angel-obando-17/CNN-accelerator-on-SoC/socs.md

# COMPARACION DE SOCS

| Board | SoC | Familia | Nucleos | Cache | DMA Channels | On Chip Memory | RAM | BRAM  | Word Size BRAM | Logic Cells | DSP Slices | Precio (COP) | 
|---|---|---|---|---|---|---|---|---|---|---|---|---|
| Puzhi 7020  | Z-7020 | Zynq®-7000 | Dual-Core ARM - Cortex-A9 MPCore | 32KB I, 32KB D / 512 KB | 8 (4 to PL) | 256 KB | 512 MB | 4.9Mb | 1-bit hasta 72-bits | 85K | 220 | $480.174 |
| ZedBoard Zynq-7000 | Z-7020 | Zynq®-7000 | Dual-Core ARM - Cortex-A9 MPCore | 32KB I, 32KB D / 512 KB | 8 (4 to PL) | 256 KB | 512 MB | 4.9Mb | 1-bit hasta 72-bits | 85K | 220 | $2.186.821,53 |
| PYNQ-Z2 FPGA | Z-7020 | Zynq®-7000 | Dual-Core ARM - Cortex-A9 MPCore | 32KB I, 32KB D / 512 KB | 8 (4 to PL) | 256 KB | 512 MB | 4.9Mb | 1-bit hasta 72-bits | 85K | 220 | $490.947,33 |
| Zybo Z7 | Z-7020 | Zynq®-7000 | Dual-Core ARM - Cortex-A9 MPCore | 32KB I, 32KB D / 512 KB | 8 (4 to PL) | 256 KB | 1 GB | 4.9Mb | 1-bit hasta 72-bits | 85K | 220 | $2.420.796 |
| KRM-3Z7030 | Z-7030 | Zynq®-7000 | Dual-Core ARM - Cortex-A9 MPCore | 32KB I, 32KB D / 512 KB | 8 (4 to PL) | 256 KB | 1 GB | 9.3Mb | 1-bit hasta 72-bits | 125K | 400 | $1.948.744,00 |
| ZYNQ EVB Board | Z-7030 | Zynq®-7000 | Dual-Core ARM - Cortex-A9 MPCore | 32KB I, 32KB D / 512 KB | 8 (4 to PL) | 256 KB | 2GB | 9.3Mb | 1-bit hasta 72-bits | 125K | 400 | $2.895.960,60 |
| AXU2CGB Dev Board | ZU2CG | Zynq UltraScale+  | Dual-core Arm® Cortex®-A53 / Dual-core Arm Cortex-R5F | ( 32KB I, 32KB D / 1MB ) / ( 32KB I, 32KB D / 128 Tightly Coupled Memory per core ) | 8 (4 to PL) | 256 KB | 2GB | 5.3Mb | 1-bit hasta 72-bits | 103K | 240 | $1.596.491,10 |
