angel-obando-17/CNN-accelerator-on-SoC/CNN/docs/analisis.md

# ANALSIS DE RESULTADOS DE ENTRENAMIENTO

Para validar las restricciones impuestas en el acelerador, sobre la resolucion de imagenes y la cuantizacion a INT8, se desarrollo el modelo de CNN que tendra la tarea de indentificar enfermedades en una planta de tomate, para esto se empleo el database de PlantVillage alojado en Kaggle, link = "https://www.kaggle.com/datasets/emmarex/plantdisease/data".

## ESTRATEGIA DE VALIDACIÓN

Para hacer una analisis completo y detallado de que ocurre en distintos escenarios y asi ver que posibles resultados obtener se planteo el siguiente esquema:

* Realizar entrenamientos del modelo en $3$ resoluciones distintas, las cuales son [ $256$ $\times$ $256$, $128$ $\times$ $128$, $96$ $\times$ $96$ ].
* Para cada entrenamiento obtenido anteriormente se realizan las siguientes cuantizaciones [ "float32", "int16", "int8" ].
* En cada cuantizacion obtenida se usan como metricas el accuracy y confussion matrix.

## IMPLEMENTACION

Para poder realizar una correcta implementacion del modelo, primero se necesitaba balancear el database, ya que para cada una de las clases habia muestras muy disparejas, originalmente el database contaba con $10$ clases, las cuales eran:

* Tomato_Bacterial_Spot.
* Tomato_Early_Blight.
* Tomato_Late_Blight.
* Tomato_Leaf_Mold.
* Tomato_Septoria_Leaf_Spot.
* Tomato_Spider_Mites_Two_Spotted_Spider_Mite.
* Tomato__Target_Spot.
* Tomato__Tomato_YellowLeaf__Curl_Virus.
* Tomato__Tomato_Mosaic_Virus.
* Tomato_Healthy.

Se tomo la desicion de descartar la clase "Tomato__Tomato_Mosaic_Virus" debido a que tenia significativamente muchas menos muestras que las demas clases, y tomar esta clase como referencia para el balance provocaria una perdida enorme de informacion de las demas clases, obteniendo un entrenamiento muy pobre, por lo tanto se decidio eliminarlo definitivamente.

Despues de esto entonces se tomo como clase referencia la clase "Tomato_Leaf_Mold" la cual tenia un total de $952$ muestras, por lo que todas las demas clases debian ser recortadas hasta obtener este mismo numero de muestras, pero antes de hacer eso, se decicio con ayuda de un script en python tomar 48 muestras aleatorias de la clase "Tomato_Leaf_Mold" y aplicarle ciertas transforamciones muy poco invasivas, ya sean como hacer espejo, cambiar algunos tonos de luz o rotar un poco las imagenes, esto con el proposito de alcanzar $1000$ muestras para esta clase, de esta forma entonces, cada clase debia recortarse a $1000$ muestras.

Una vez que el dataset fue balanceado, entonces ahora si se procedio a realizar el script en python que realizaria las siguientes tareas:

* Segmentacion de las imagenes utilizando el metodo de "grabCut" de la libreria OpenCV disponible para python.
* Una vez con las imagenes segmentadas, entonces se procede a realizar el primer entrenamiento con las imagenes en su resolucion original, la cual es de $256$ $\times$ $256$. 
* Una vez que el modelo haya terminado de entrenarse, entonces se exportaron los pesos obtenidos en su formato original de "float32".
* Se procede a validar el modelo con su cunatizado original, se mide accuracy y se obtiene la confussion matrix.
* Se procede a cuantizar el modelo a "int8", se mide accuracy y se obtiene la confussion matrix.
* Se procede a cuantizar el modelo a "int16", se mide el accuracy y se obtiene la confussion matrix.
* Esto se repite para cada otra de las resoluciones, es decir para [ $128$ $\times$ $128$, $96$ $\times$ $96$ ].

En cuanto al modelo CNN implementado, como ya se menciono anteriormente, se utilizo el modelo de MobileNetV1, pero personalizado para que utilice las capas soportadas por el acelerador que se desea implementar, por lo que solo consiste en capas de convolucion normal $3$ $\times$ $3$, DepthWise $3$ $\times$ $3$, PointWise $1$ $\times$ $1$, MaxPool $2$ $\times$ $2$ y Global Average Pool, tambien se limitaron los strides a [ $1$, $2$ ].

Tambien se implemento un sistema que midiera el tiempo que se tardo en cada etapa del proceso, desde que se cargaron las imagenes, segmentado las imagenes, entrenando el modelo, realizando las pruebas de validacion y tambien calculando el tiempo que le tomo cuantizar los parametros del modelo.

## PRIMEROS RESULTADOS

### Primer entrenamiento

#### RESOLUCION 256

Para la primer etapa de entrenamiento donde se uso las imagenes con su resolucion original, es decir $256$ $\times$ $256$, los resultados obtenidos fueron los siguientes:

* Indexado de archivos:  $0.434$ s.
* Total de $9000$ imagenes | $9$ clases.
* [ Train $=$ $6300$,  Val $=$ $1350$,  Test $=$ $1350$ ].
* Entrenamiento: $8254.509$ s.
Accuracy vs Loss in Training
* Accuracy: $0.8319$.
* Confussion Matrix:
Confussion Matrix $256$ $\times$ $256$ (float32)

Despues de esto se cuantizo a INT8, donde se obtuvieron los siguientes resultados:

* Conversion de parametros a INT8: $48.953$ s.
* Tamaño del modelo en INT8: $120.8$ KB.
* Accuracy int8: $0.8259$.
* Confussion Matrix:
Confussion Matrix $256$ $\times$ $256$ (int8)

Para finalizar tenemos el modelo cuantizado en INT16, donde los resultados fueron los siguientes:

* Conversion de parametros a INT16: $95.270$ s.
* Tamaño del modelo en INT8: $141.9$ KB.
* Accuracy int16: $0.8274$.
* Confussion Matrix:
Confussion Matrix $256$ $\times$ $256$ (int16)

#### RESOLUCION 128

Para la segunda etapa de entrenamiento donde se uso las imagenes con un reescalado a $128$ $\times$ $128$, los resultados obtenidos fueron los siguientes:

* Entrenamiento: $8052.963$ s.
Accuracy vs Loss in Training
* Accuracy: $0.6763$.
* Tiempo de evaluacion: $75.031$ s.
* Confussion Matrix:
Confussion Matrix $128$ $\times$ $128$ (float32)

Despues de esto se cuantizo a INT8, donde se obtuvieron los siguientes resultados:

* Conversion de parametros a INT8: $42.980$ s.
* Tamaño del modelo en INT8: $120.8$ KB.
* Accuracy int8: $0.6800$.
* Confussion Matrix:
Confussion Matrix $128$ $\times$ $128$ (int8)

Para finalizar tenemos el modelo cuantizado en INT16, donde los resultados fueron los siguientes:

* Conversion de parametros a INT16: $82.207$ s.
* Tamaño del modelo en INT8: $141.9$ KB.
* Accuracy int16: $0.6763$.
* Confussion Matrix:
Confussion Matrix $128$ $\times$ $128$ (int16

#### RESOLUCION 96

Para la tercer etapa y ultima etapa de entrenamiento donde se uso las imagenes con un reescalado a $96$ $\times$ $96$, los resultados obtenidos fueron los siguientes:

* Entrenamiento: $8052.963$ s.
Accuracy vs Loss in Training
* Accuracy: $0.7259$.
* Tiempo de evaluacion: $72.404$ s.
* Confussion Matrix:
Confussion Matrix $96$ $\times$ $96$ (float32)

Despues de esto se cuantizo a INT8, donde se obtuvieron los siguientes resultados:

* Conversion de parametros a INT8: $41.845$ s.
* Tamaño del modelo en INT8: $120.7$ KB.
* Accuracy int8: $0.7230$.
* Confussion Matrix:
Confussion Matrix $96$ $\times$ $96$ (int8)

Para finalizar tenemos el modelo cuantizado en INT16, donde los resultados fueron los siguientes:

* Conversion de parametros a INT16: $81.680$ s.
* Tamaño del modelo en INT8: $141.8$ KB.
* Accuracy int16: $0.7267$.
* Confussion Matrix:
Confussion Matrix $96$ $\times$ $96$ (int16)

| Resolucion | Tiempo de Entrenamiento ( s ) | Cuantizacion | Accuracy | Inferencia ( ms / img ) | Tamaño del modelo ( kB ) | Tiempo de conversion ( s ) |
|---|---|---|---|---|---|---|
| $256$ $\times$ $256$ | $8254.509$ | float32 | $0.831852$ | $7.5678$ | $1112.441$ | No aplica |
| $256$ $\times$ $256$ | $8254.509$ | INT8 | $0.825926$ | $207.1756$ | $120.773$ | $48.9533$ |
| $256$ $\times$ $256$ | $8254.509$ | INT16 | $0.827407$ | $264.2121$ | $141.882$ | $95.2697$ |
| $128$ $\times$ $128$ | $8052.963$ | float32 | $0.676296$ | $3.3505$ | $1112.293$ | No aplica |
| $128$ $\times$ $128$ | $8052.963$ | INT8 | $0.680000$ | $214.8316$ | $120.773$ | $42.9797$ |
| $128$ $\times$ $128$ | $8052.963$ | INT16 | $0.676296$ | $218.2872$ | $141.882$ | $82.2065$ |
| $96$ $\times$ $96$ | $7811.027$ | float32 | $0.725926$ | $3.7295$ | $1112.286$ | No aplica |
| $96$ $\times$ $96$ | $7811.027$ | INT8 | $0.722963$ | $201.9591$ | $120.656$ | $41.8454$ |
| $96$ $\times$ $96$ | $7811.027$ | INT16 | $0.726667$ | $213.9610$ | $141.7656$ | $81.6804$ |

## CORRECIONES REALIZADAS

Despues de haber entrenado el modelo por primera vez, se observo que el mejor accuracy obtenido fue cuando se entreno el modelo con las dimensiones originales de las imagenes y cuantizando a float32, el accuracy que se obtuvo fue de $0.8318$, lo cual fue un buen punto de partida, a partir de aqui se tomaron desiciones respecto a como mejorar este accuracy obtenido, y buscar subirlo lo mayor posible.

Para el primer entrenamiento realizado, se escogio como modelo de segmentacion el metodo grabCut de openCV, este metodo aunque muy rapido, cometio muchos errores a la hora de segmentar algunas imagenes, ya que o les recortaba parte de la hoja, por lo tanto las dejaba incompletas o sino, les agreagaba sombra como si fueran parte de la hoja, haciendo que el modelo aprendiera patrones que no eran correctos debido a la forma en la cual estaban siendo segmentadas.

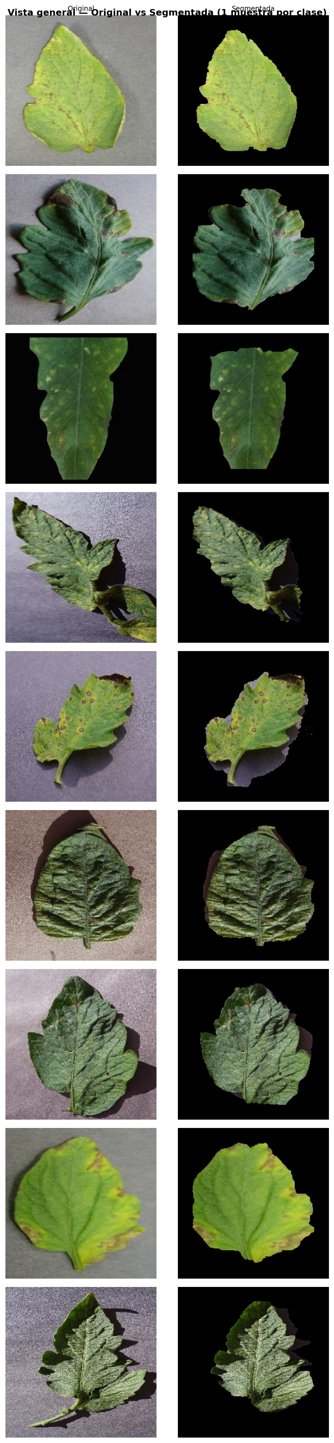
[picture p2: CNN/resultados_experimentos/imagenes_segmentadas/00_mosaic_overview.png]


Para poder resolver este problema se tomo la desicion de tomar una muestra aleatoria de cada clase, y realizar el proceso de segmentacion de manera manual, para esto se uso la herramienta open-source labelme, con la cual se realizaron las mascaras de una muestra por clase, por lo que se obtuvieron 9 mascaras.

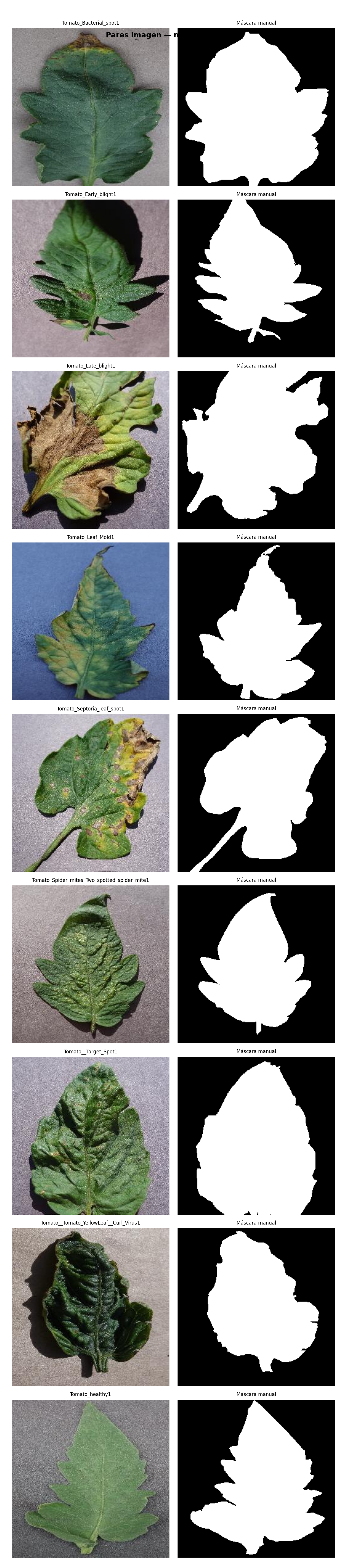
[picture p3: CNN/resultados_experimentos/segmentacion/mascaras_manuales.png]
Segmentacion realizada con grabCut


Con las 9 mascaras ya obtenidas se procedio a entrenar un modelo de CNN pequeño llamado U-Net el cual esta desarrollado para la segmentacion de imagenes. La red se basa en una red neuronal completamente convolucional cuya arquitectura se modificó y amplió para funcionar con menos imágenes de entrenamiento y lograr una segmentación más precisa.

El script utilizado para este paso fue el llamado "u_net_segmentation.py", despues de entrenarla con las 9 mascaras obtenidas de forma manual, se utilizo para segmentar todas las imagenes del dataset, por lo que se obtuvieron 9000 imagenes segmentadas de manera mas precisa que usando el metodo de grabCut, a continuacion se muestran unas muestras de esta segmentacion realizada por la red neuronal.

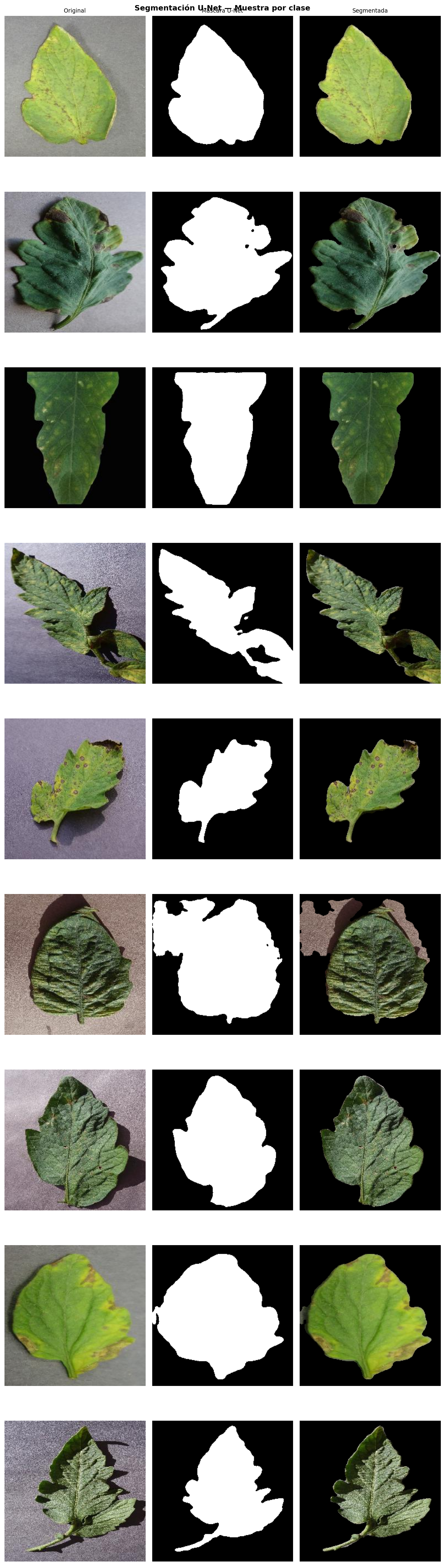
[picture p4: CNN/resultados_experimentos/segmentacion/segmentacion_muestras.png]
Segmentacion realizada con grabCut


Como se puede ver, los resultados que se obtienen son mucho mejores que los que nos devuelve el metodo de grabCut, ahora con este nuevo dataset de imagenes mejor segmentadas, se procedio a realizar un nuevo entrenamiento de la CNN, repitiendo los mismos pasos que en el primer entrenamiento, pero usando este nuevo dataset, los resultados que se obtuvieron fueron los siguientes:

### Segundo Entrenamiento

#### RESOLUCION 256

Para la primer etapa de este segundo entrenamiento, se siguio el mismo esquema que para el primer entrenamiento, donde la primer fase del entrenamiento fue con las imagenes en su resolucion original de $256$ $\times$ $256$, donde se obtuvieron los siguientes resultados:

* Indexado de archivos:  $0.124$ s.
* Total de $9000$ imagenes | $9$ clases.
* [ Train $=$ $6300$,  Val $=$ $1350$,  Test $=$ $1350$ ].
* Entrenamiento: $869.452$ s.
Accuracy vs Loss in Training
* Accuracy: $0.8859$.
* Confussion Matrix:
Confussion Matrix $256$ $\times$ $256$ (float32)

Despues de esto se cuantizo a INT8, donde se obtuvieron los siguientes resultados:

* Conversion de parametros a INT8: $35.354$ s.
* Tamaño del modelo en INT8: $120.8$ KB.
* Accuracy int8: $0.8837$.
* Confussion Matrix:
Confussion Matrix $256$ $\times$ $256$ (int8)

Para finalizar tenemos el modelo cuantizado en INT16, donde los resultados fueron los siguientes:

* Conversion de parametros a INT16: $67.825$ s.
* Tamaño del modelo en INT8: $141.9$ KB.
* Accuracy int16: $0.8867$.
* Confussion Matrix:
Confussion Matrix $256$ $\times$ $256$ (int16)

#### RESOLUCION 128

Para la segunda etapa de entrenamiento donde se uso las imagenes con un reescalado a $128$ $\times$ $128$, los resultados obtenidos fueron los siguientes:

* Entrenamiento: $531.974$ s.
Accuracy vs Loss in Training
* Accuracy: $0.7030$.
* Tiempo de evaluacion: $26.070$ s.
* Confussion Matrix:
Confussion Matrix $128$ $\times$ $128$ (float32)

Despues de esto se cuantizo a INT8, donde se obtuvieron los siguientes resultados:

* Conversion de parametros a INT8: $31.813$ s.
* Tamaño del modelo en INT8: $120.8$ KB.
* Accuracy int8: $0.7104$.
* Confussion Matrix:
Confussion Matrix $128$ $\times$ $128$ (int8)

Para finalizar tenemos el modelo cuantizado en INT16, donde los resultados fueron los siguientes:

* Conversion de parametros a INT16: $58.952$ s.
* Tamaño del modelo en INT8: $141.9$ KB.
* Accuracy int16: $0.7015$.
* Confussion Matrix:
Confussion Matrix $128$ $\times$ $128$ (int16

#### RESOLUCION 96

Para la tercer etapa y ultima etapa de entrenamiento donde se uso las imagenes con un reescalado a $96$ $\times$ $96$, los resultados obtenidos fueron los siguientes:

* Entrenamiento: $534.569$ s.
Accuracy vs Loss in Training
* Accuracy: $0.7622$.
* Tiempo de evaluacion: $26.955$ s.
* Confussion Matrix:
Confussion Matrix $96$ $\times$ $96$ (float32)

Despues de esto se cuantizo a INT8, donde se obtuvieron los siguientes resultados:

* Conversion de parametros a INT8: $30.056$ s.
* Tamaño del modelo en INT8: $120.7$ KB.
* Accuracy int8: $0.7689$.
* Confussion Matrix:
Confussion Matrix $96$ $\times$ $96$ (int8)

Para finalizar tenemos el modelo cuantizado en INT16, donde los resultados fueron los siguientes:

* Conversion de parametros a INT16: $59.788$ s.
* Tamaño del modelo en INT8: $141.8$ KB.
* Accuracy int16: $0.7667$.
* Confussion Matrix:
Confussion Matrix $96$ $\times$ $96$ (int16)

| Resolucion | Tiempo de Entrenamiento ( s ) | Cuantizacion | Accuracy | Inferencia ( ms / img ) | Tamaño del modelo ( kB ) | Tiempo de conversion ( s ) |
|---|---|---|---|---|---|---|
| $256$ $\times$ $256$ | $869.451$ | float32 | $0.885926$ | $8.6652$ | $1112.440$ | No aplica |
| $256$ $\times$ $256$ | $869.451$ | INT8 | $0.883704$ | $11.2185$ | $120.773$ | $35.3539$ |
| $256$ $\times$ $256$ | $869.451$ | INT16 | $0.886667$ | $68.8505$ | $141.882$ | $67.8251$ |
| $128$ $\times$ $128$ | $531.974$ | float32 | $0.702963$ | $2.8907$ | $1112.294$ | No aplica |
| $128$ $\times$ $128$ | $531.974$ | INT8 | $0.710370$ | $6.7732$ | $120.773$ | $31.8126$ |
| $128$ $\times$ $128$ | $531.974$ | INT16 | $0.701481$ | $23.7306$ | $141.882$ | $58.9521$ |
| $96$ $\times$ $96$ | $534.568$ | float32 | $0.762222$ | $3.9877$ | $1112.286$ | No aplica |
| $96$ $\times$ $96$ | $534.568$ | INT8 | $0.768889$ | $6.8182$ | $120.656$ | $30.0562$ |
| $96$ $\times$ $96$ | $534.568$ | INT16 | $0.766667$ | $16.0752$ | $141.765$ | $59.7883$ |

## COMPARACIONES CON OTROS MODELOS

Despues de realizar el segundo entrenamiento, se procedio a reliazar entrenamientos de tres modelos mas, Le-Net, Efficient-Net y MObileNetV2, los entrenamientos se realizaron con el mismo dataset de las imagenes ya segmentadas por U-Net, para este caso, unicamente se realizaron los entrenamientos en la resolucion original de las imagenes, la cual es de $256$ $\times$ $256$, despues se realizaron las respectivas cuantizaciones a INT8 e INT16 y se validaron las muestras de test, los resultados obtenidos de estos entrenamientos fueron los siguientes:

### Le-Net

* Total de $9000$ imagenes | $9$ clases.
* [ Train $=$ $6300$,  Val $=$ $1350$,  Test $=$ $1350$ ].
* Entrenamiento: $882.987$ s.
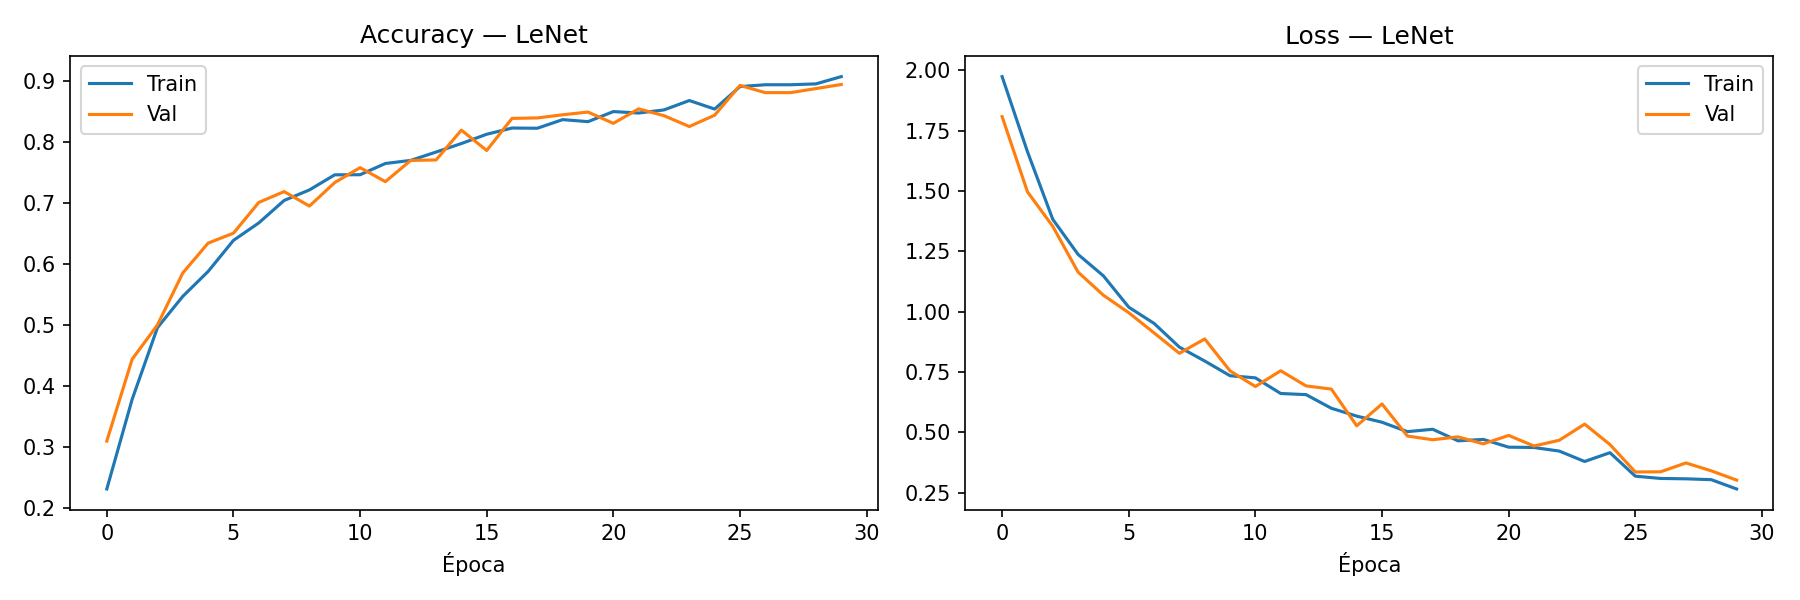
[picture p5: CNN/resultados_comparativa/training_LeNet.png]
Accuracy vs Loss in Training

* Accuracy: $0.8696$.
* Confussion Matrix:
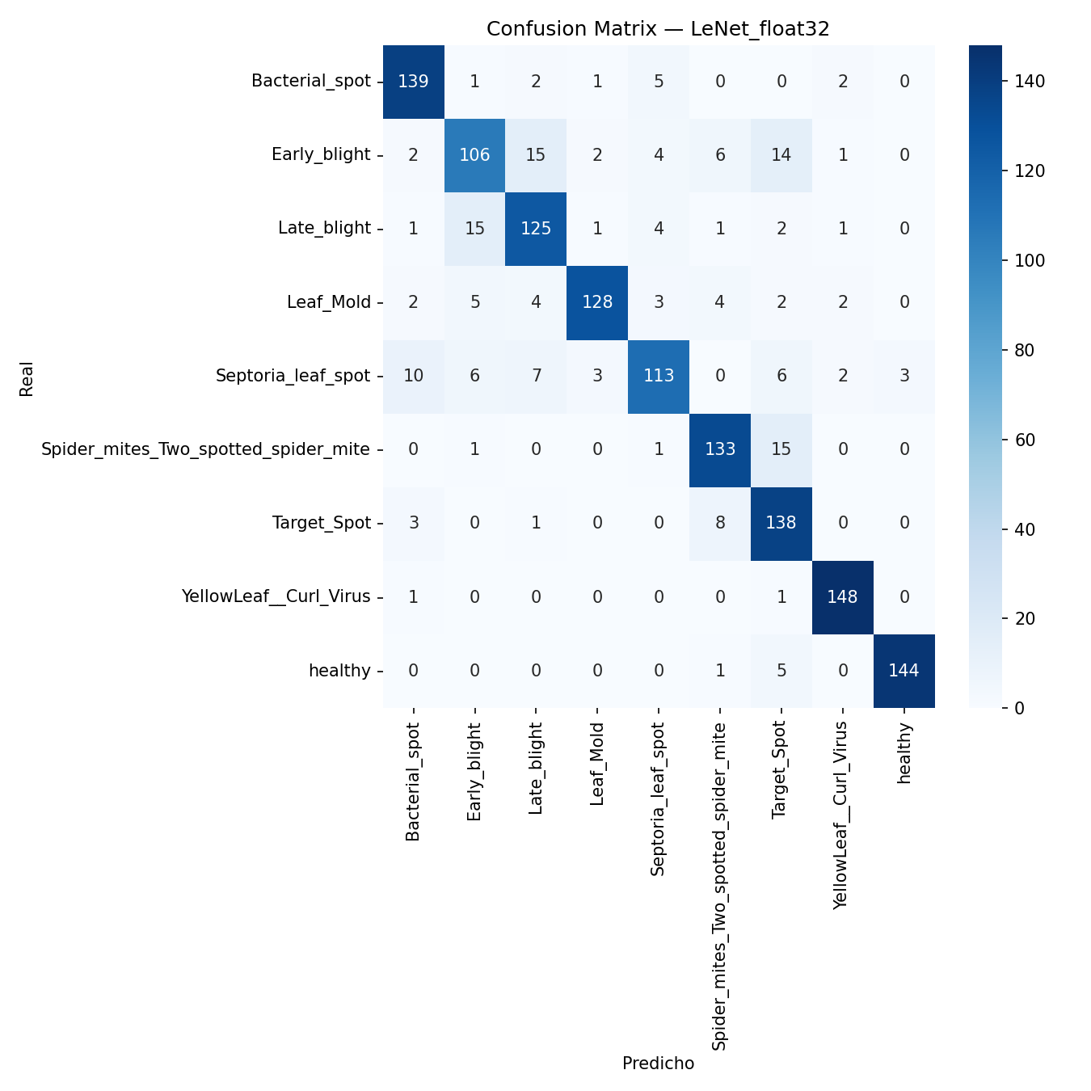
[picture p6: CNN/resultados_comparativa/cm_LeNet_float32.png]
Confussion Matrix $256$ $\times$ $256$ (float32)


Despues de esto se cuantizo a INT8, donde se obtuvieron los siguientes resultados:

* Conversion de parametros a INT8: $12.140$ s.
* Tamaño del modelo en INT8: $110.0$ KB.
* Accuracy int8: $0.8681$.
* Confussion Matrix:
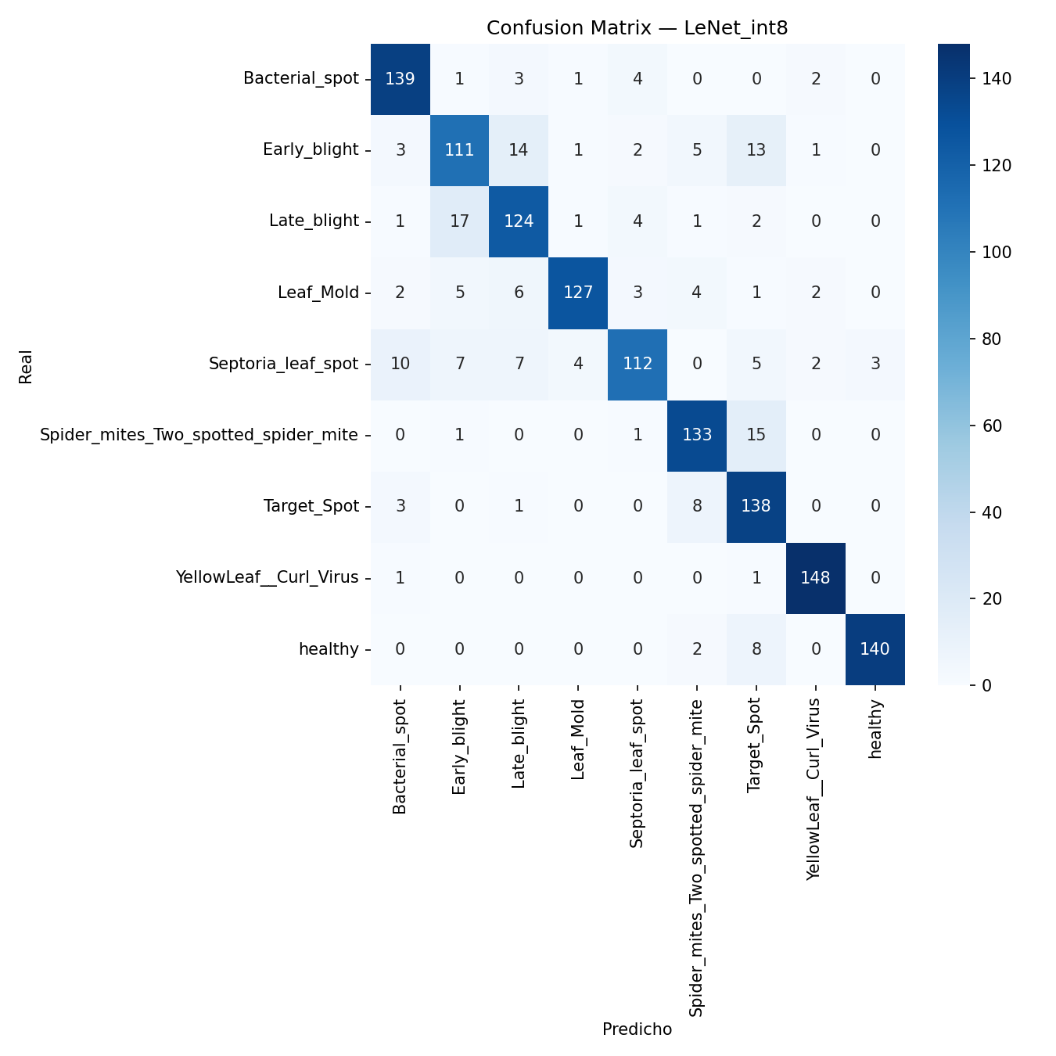
[picture p7: CNN/resultados_comparativa/cm_LeNet_int8.png]


Para finalizar tenemos el modelo cuantizado en INT16, donde los resultados fueron los siguientes:

* Conversion de parametros a INT16: $23.027$ s.
* Tamaño del modelo en INT8: $114.2$ KB.
* Accuracy int16: $0.8689$.
* Confussion Matrix:
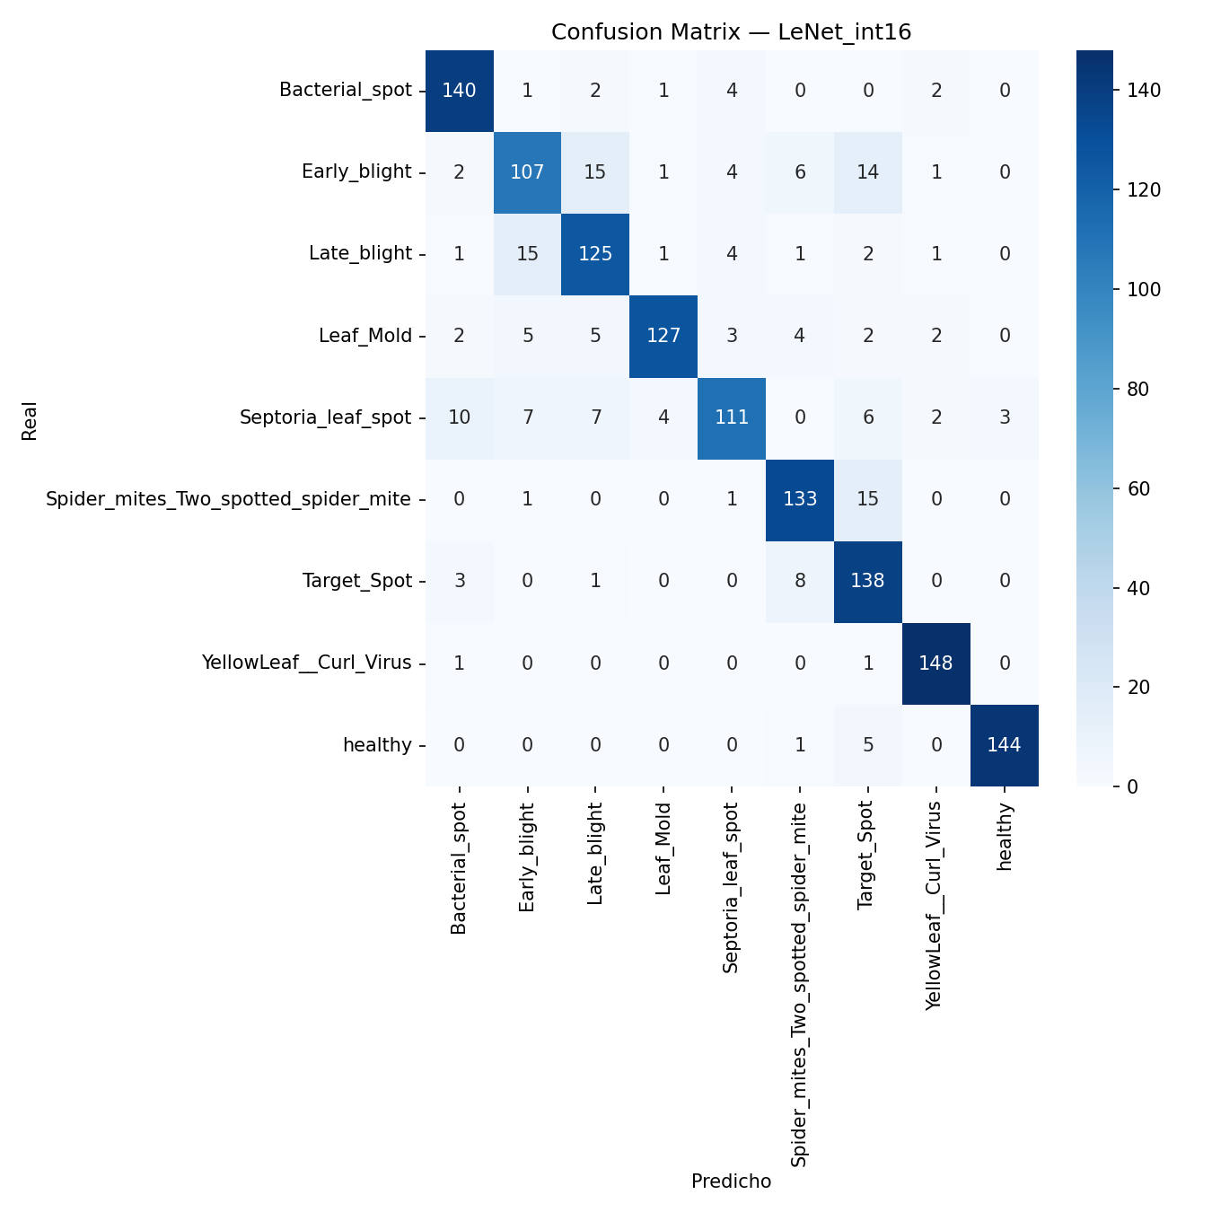
[picture p8: CNN/resultados_comparativa/cm_LeNet_int16.png]


### MobileNetV2

* Total de $9000$ imagenes | $9$ clases.
* [ Train $=$ $6300$,  Val $=$ $1350$,  Test $=$ $1350$ ].
* Entrenamiento: $770.597$ s.
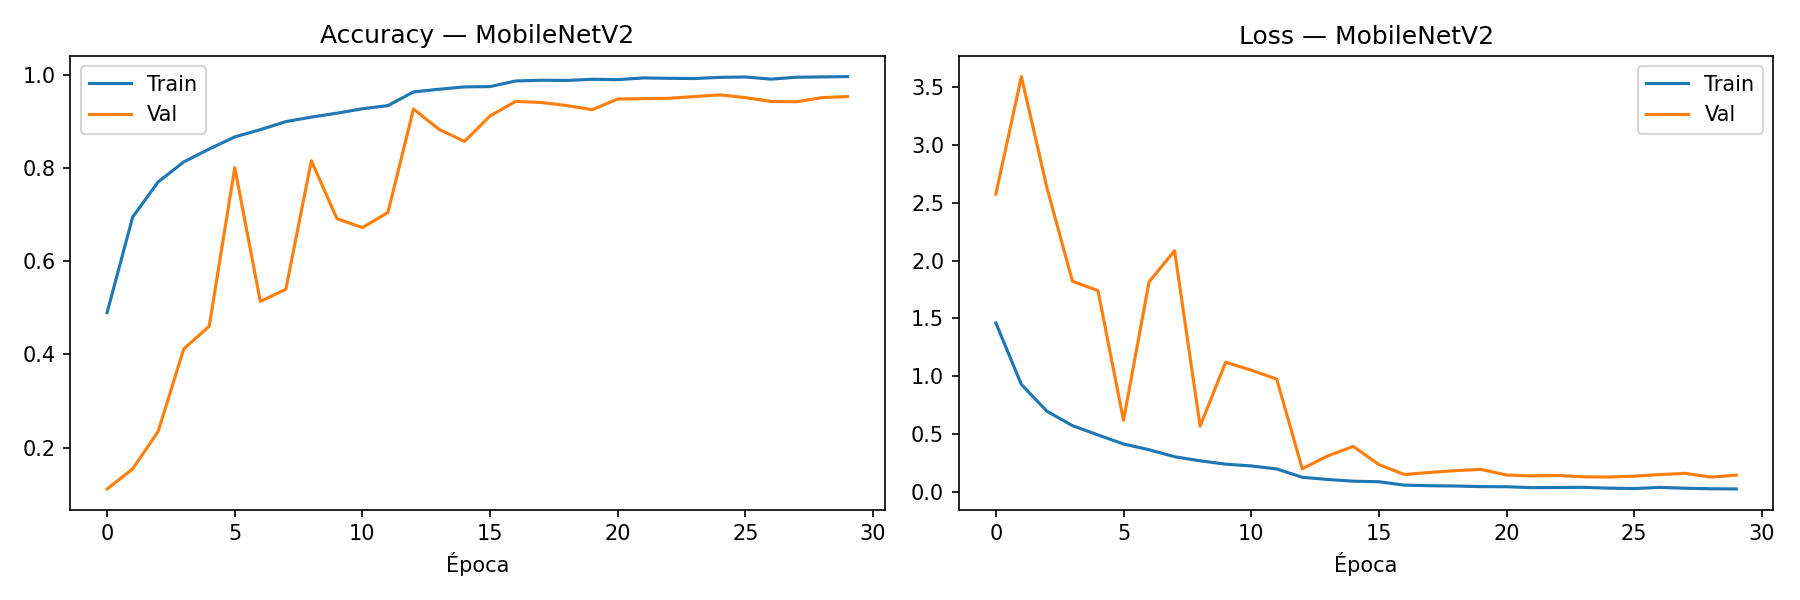
[picture p9: CNN/resultados_comparativa/training_MobileNetV2.png]
Accuracy vs Loss in Training

* Accuracy: $0.9444$.
* Confussion Matrix:
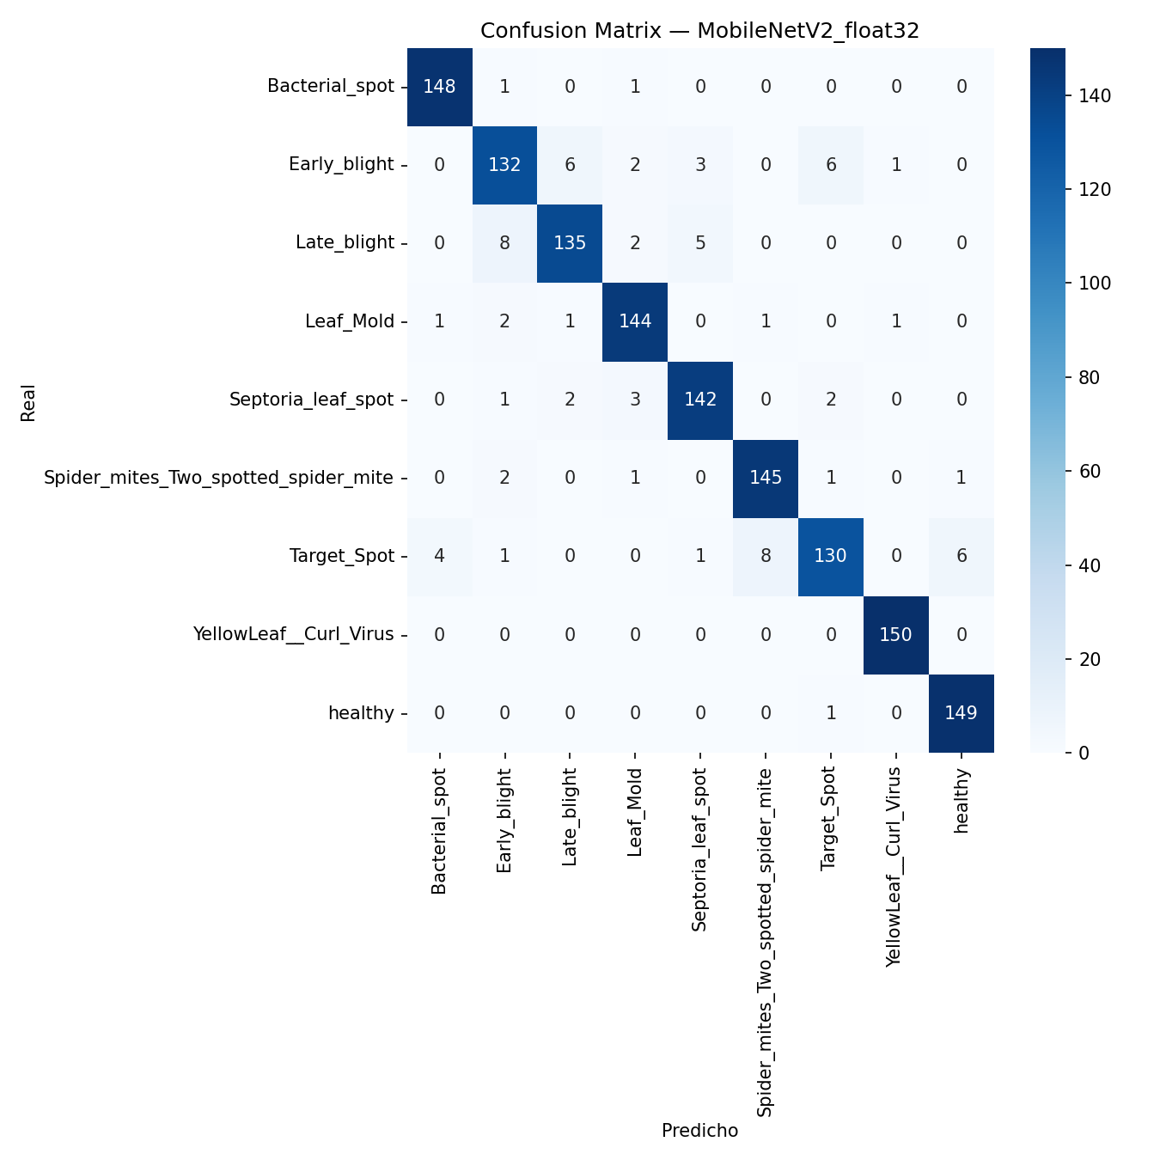
[picture p10: CNN/resultados_comparativa/cm_MobileNetV2_float32.png]
Confussion Matrix $256$ $\times$ $256$ (float32)


Despues de esto se cuantizo a INT8, donde se obtuvieron los siguientes resultados:

* Conversion de parametros a INT8: $11.363$ s.
* Tamaño del modelo en INT8: $143.5$ KB.
* Accuracy int8: $0.9452$.
* Confussion Matrix:
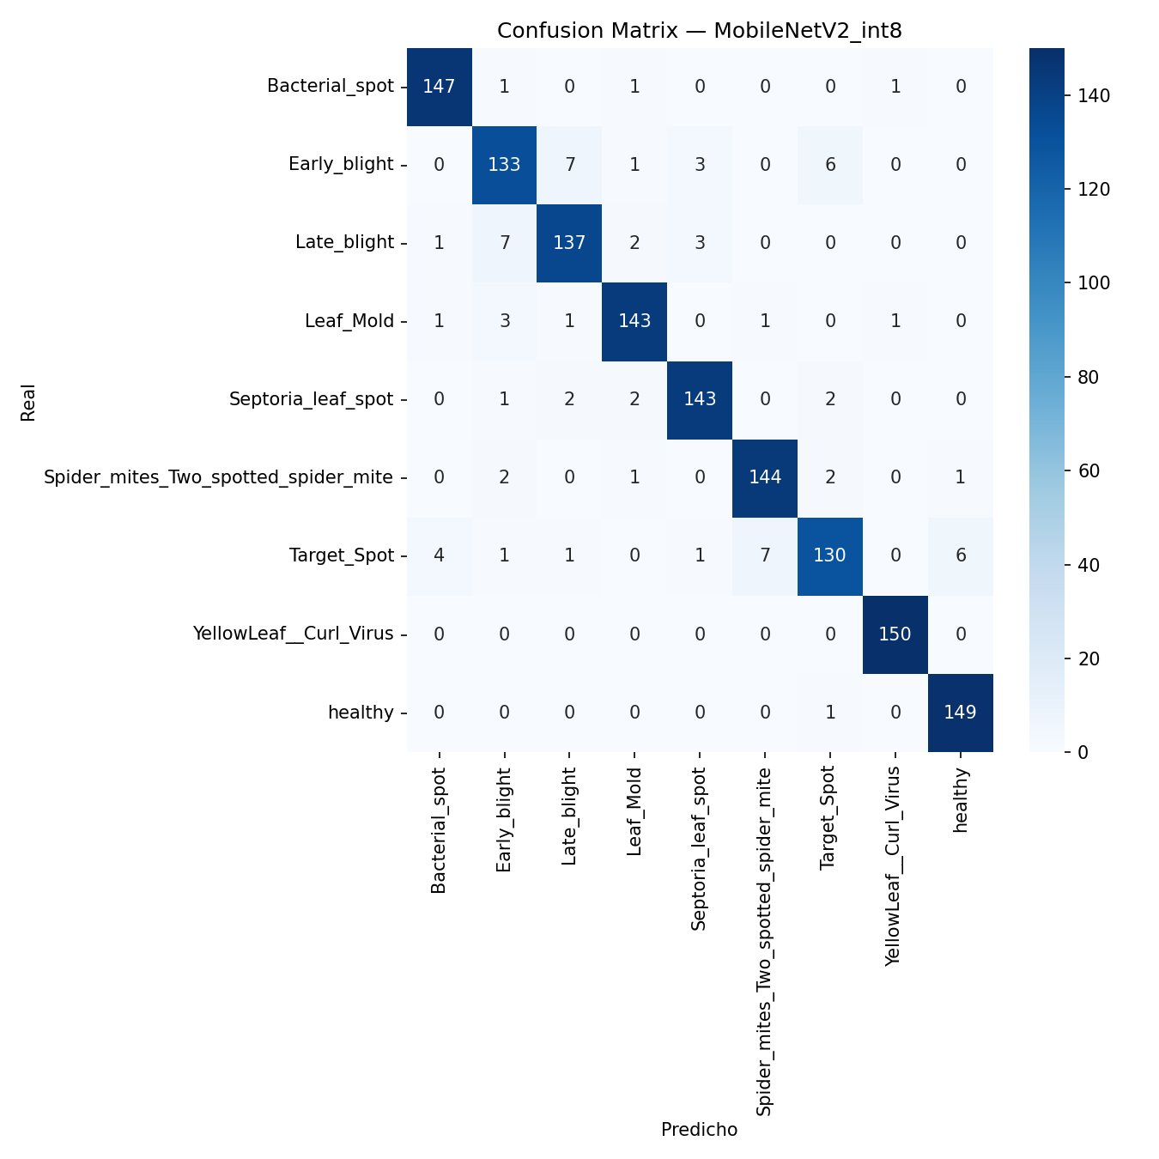
[picture p11: CNN/resultados_comparativa/cm_MobileNetV2_int8.png]


Para finalizar tenemos el modelo cuantizado en INT16, donde los resultados fueron los siguientes:

* Conversion de parametros a INT16: $19.795$ s.
* Tamaño del modelo en INT8: $166.5$ KB.
* Accuracy int16: $0.9481$.
* Confussion Matrix:
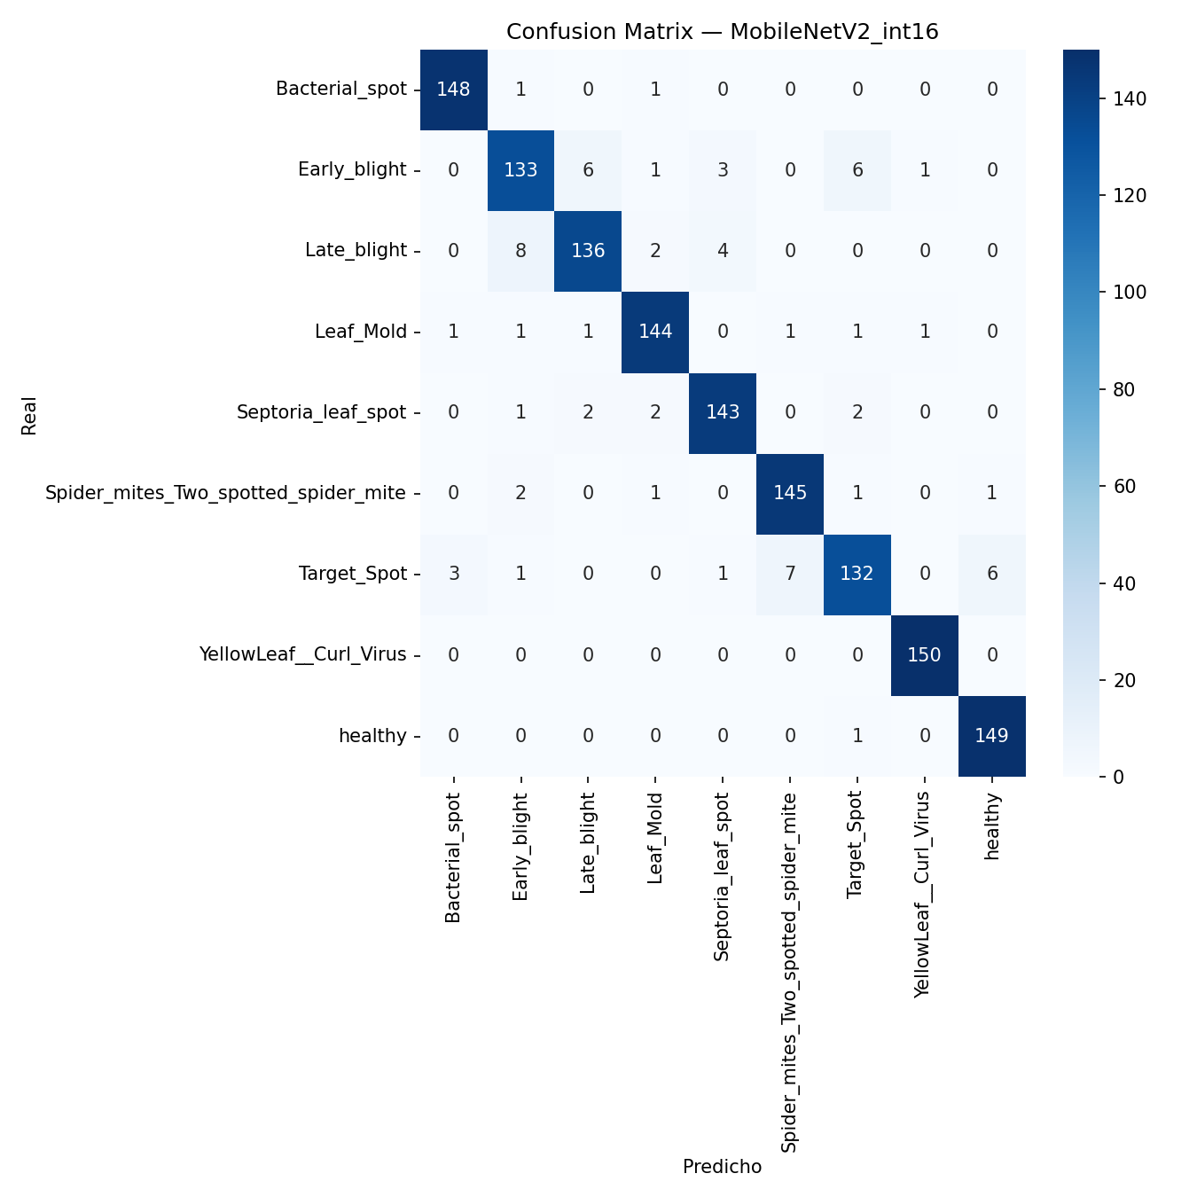
[picture p12: CNN/resultados_comparativa/cm_MobileNetV2_int16.png]


### Efficient-Net

* Total de $9000$ imagenes | $9$ clases.
* [ Train $=$ $6300$,  Val $=$ $1350$,  Test $=$ $1350$ ].
* Entrenamiento: $775.373$ s.
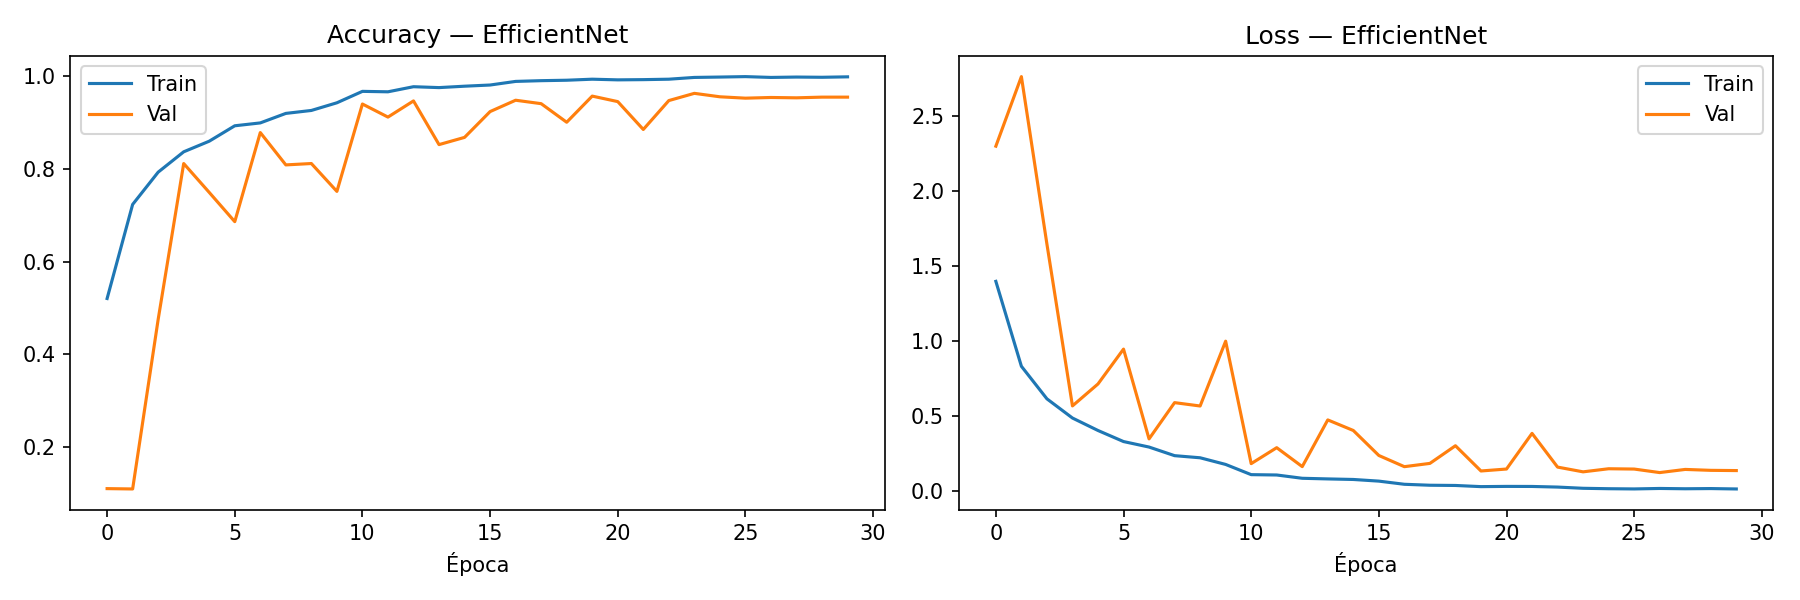
[picture p13: CNN/resultados_comparativa/training_EfficientNet.png]
Accuracy vs Loss in Training

* Accuracy: $0.9548$.
* Confussion Matrix:
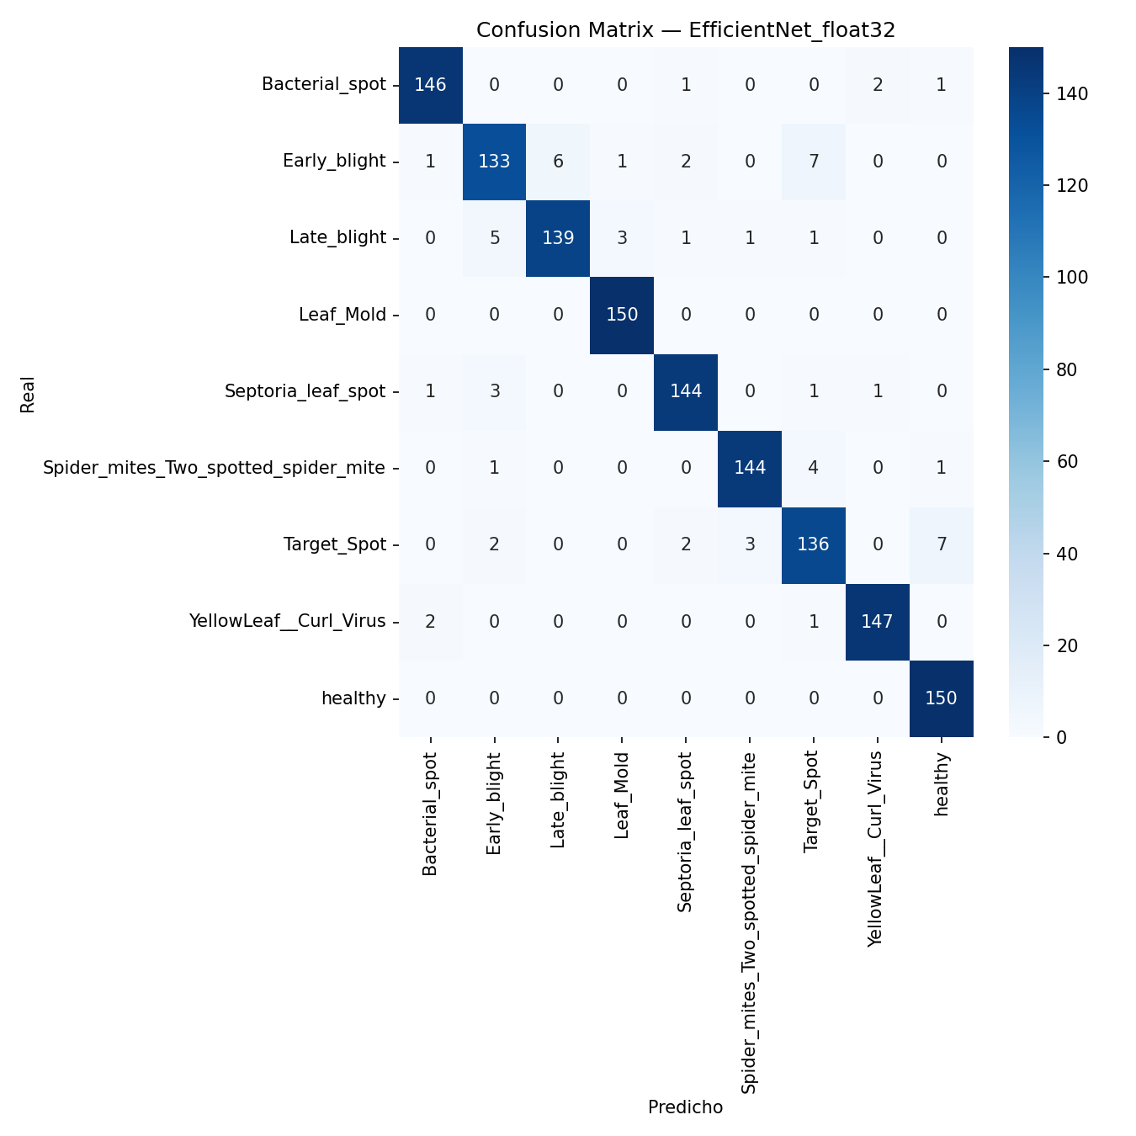
[picture p14: CNN/resultados_comparativa/cm_EfficientNet_float32.png]
Confussion Matrix $256$ $\times$ $256$ (float32)


Despues de esto se cuantizo a INT8, donde se obtuvieron los siguientes resultados:

* Conversion de parametros a INT8: $26.483$ s.
* Tamaño del modelo en INT8: $195.7$ KB.
* Accuracy int8: $0.9163$.
* Confussion Matrix:
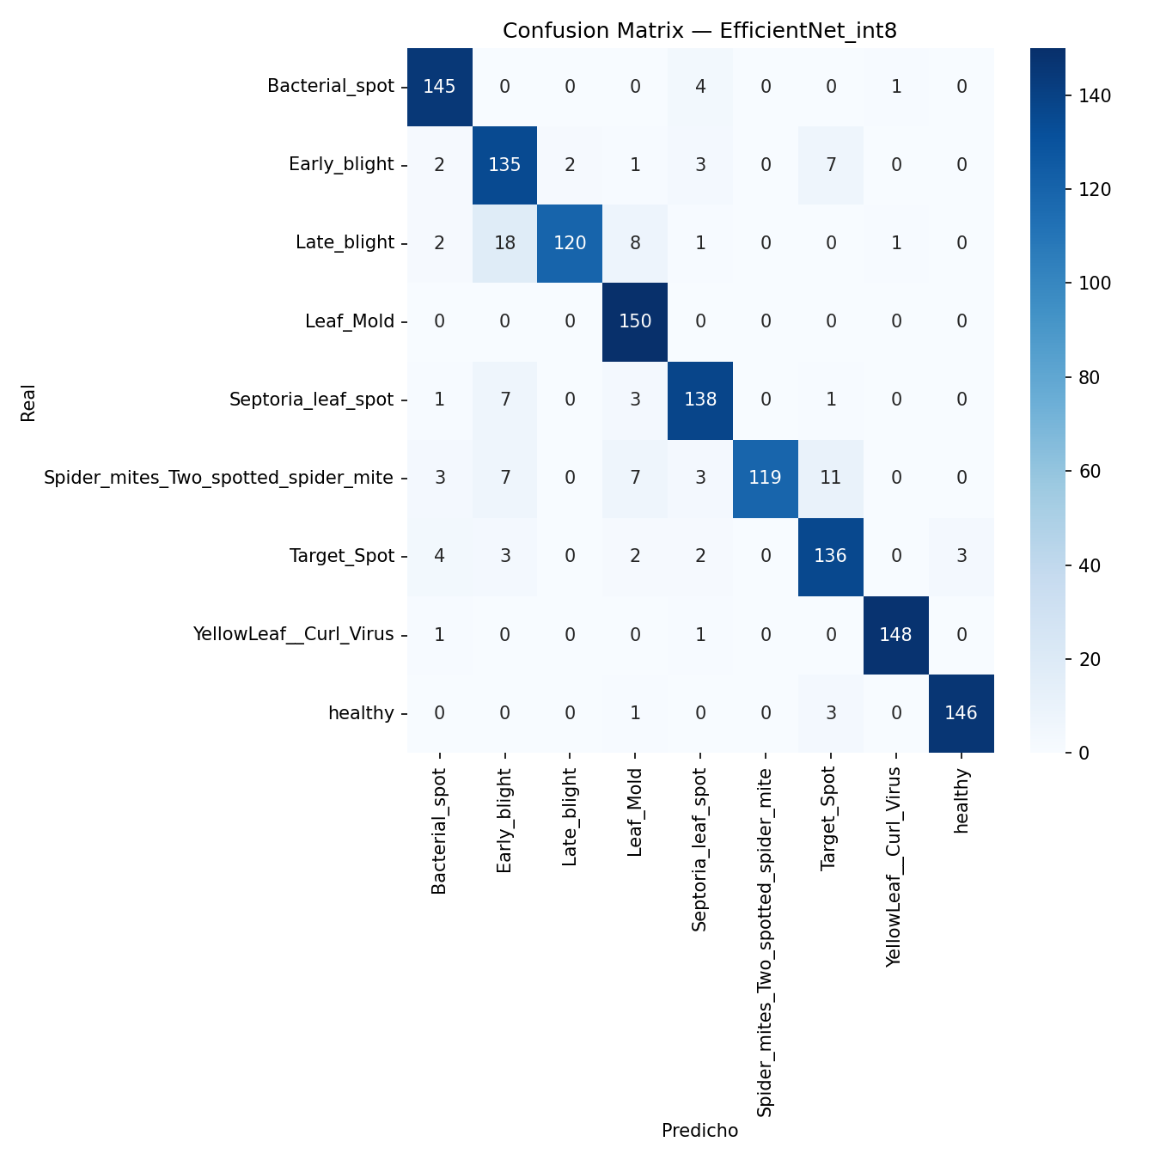
[picture p15: CNN/resultados_comparativa/cm_EfficientNet_int8.png]


Para finalizar tenemos el modelo cuantizado en INT16, donde los resultados fueron los siguientes:

* Conversion de parametros a INT16: $47.243$ s.
* Tamaño del modelo en INT8: $225.7$ KB.
* Accuracy int16: $0.9578$.
* Confussion Matrix:
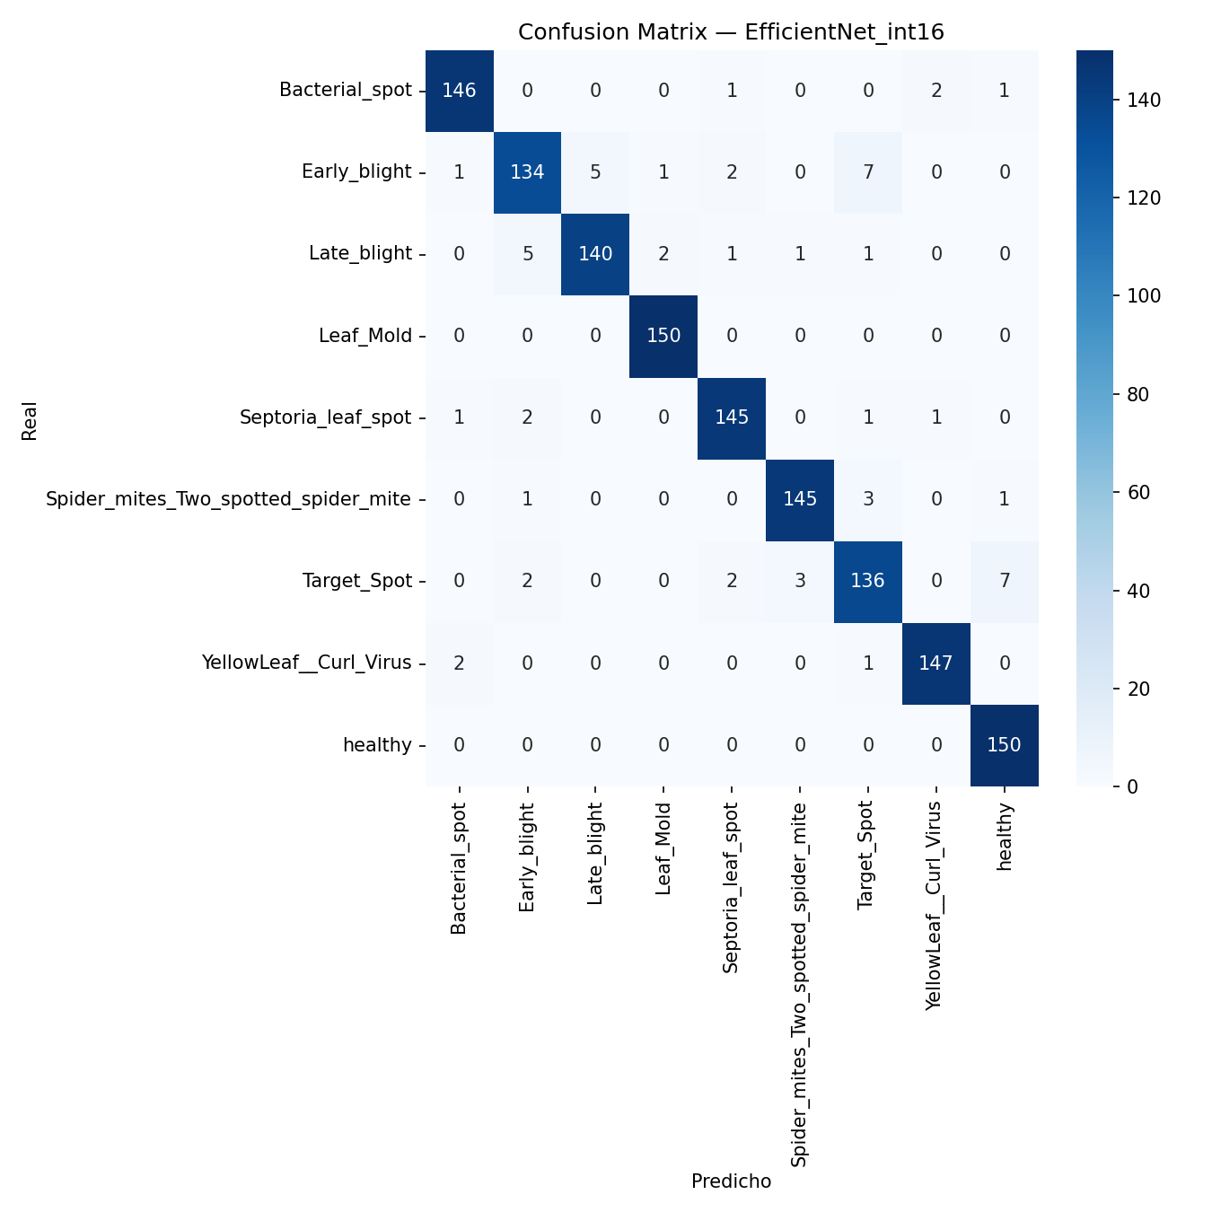
[picture p16: CNN/resultados_comparativa/cm_EfficientNet_int16.png]


| Modelo | Cuantizacion | Accuracy | Inferencia ( ms / img ) | Tamaño del modelo ( kB ) | 
|---|---|---|---|---|
| MobileNetV1 | float32 | $0.885926$ | $8.6652$ | $1112.440$ |
| MobileNetV1 | INT8 | $0.883704$ | $11.2185$ | $120.773$ |
| MobileNetV1 | INT16 | $0.886667$ | $68.8505$ | $141.882$ |
| Le-Net | float32 | $0.869630$ | $3.414$ | $1220.796$ |
| Le-Net | INT8 | $0.868148$ | $16.962$ | $110.046$ |
| Le-Net | INT16 | $0.868889$ | $373.245$ | $114.250$ |
| MobileNetV2 | float32 | $0.944444$ | $4.078$ | $1333.752$ |
| MobileNetV2 | INT8 | $0.945185$ | $7.424$ | $143.539$ |
| MobileNetV2 | INT16 | $0.948148$ | $59.014$ | $166.476$ |
| Efficient-Net | float32 | $0.954815$ | $5.475$ | $1597.346$ |
| Efficient-Net | INT8 | $0.916296$ | $10.042$ | $195.664$ |
| Efficient-Net | INT16 | $0.957778$ | $76.033$ | $225.656$ |

## Mobile-NetV2

Despues de haber realizado el entrenamiento de disintos modelos para evaluar como se comportaban al ser entrenados con el mismo dataset, entonces se tomo la desicion de trabajar mas a fondo con MobileNetV2, esto porque fue el modelo que presento un accuracy mas alto y estable ante las cuantizaciones, donde el cambio entre float32, INT8 e INT16, es casi nulo, por este motivo, se entreno el modelo en las demas resoluciones antes evaluadas tambien en MobileNetV1, ya que los modelos de comparacion unicamente se entrenaron con las imagenes en su resolucion original, siendo $256$ $\times$ $256$, entonces se entreno este modelo en las demas resoluciones, donde se obtuvieron los siguiente resultados.

### RESOLUCION 256

* Indexado de archivos:  $0.085$ s.
* Total de $9000$ imagenes | $9$ clases.
* [ Train $=$ $6300$,  Val $=$ $1350$,  Test $=$ $1350$ ].
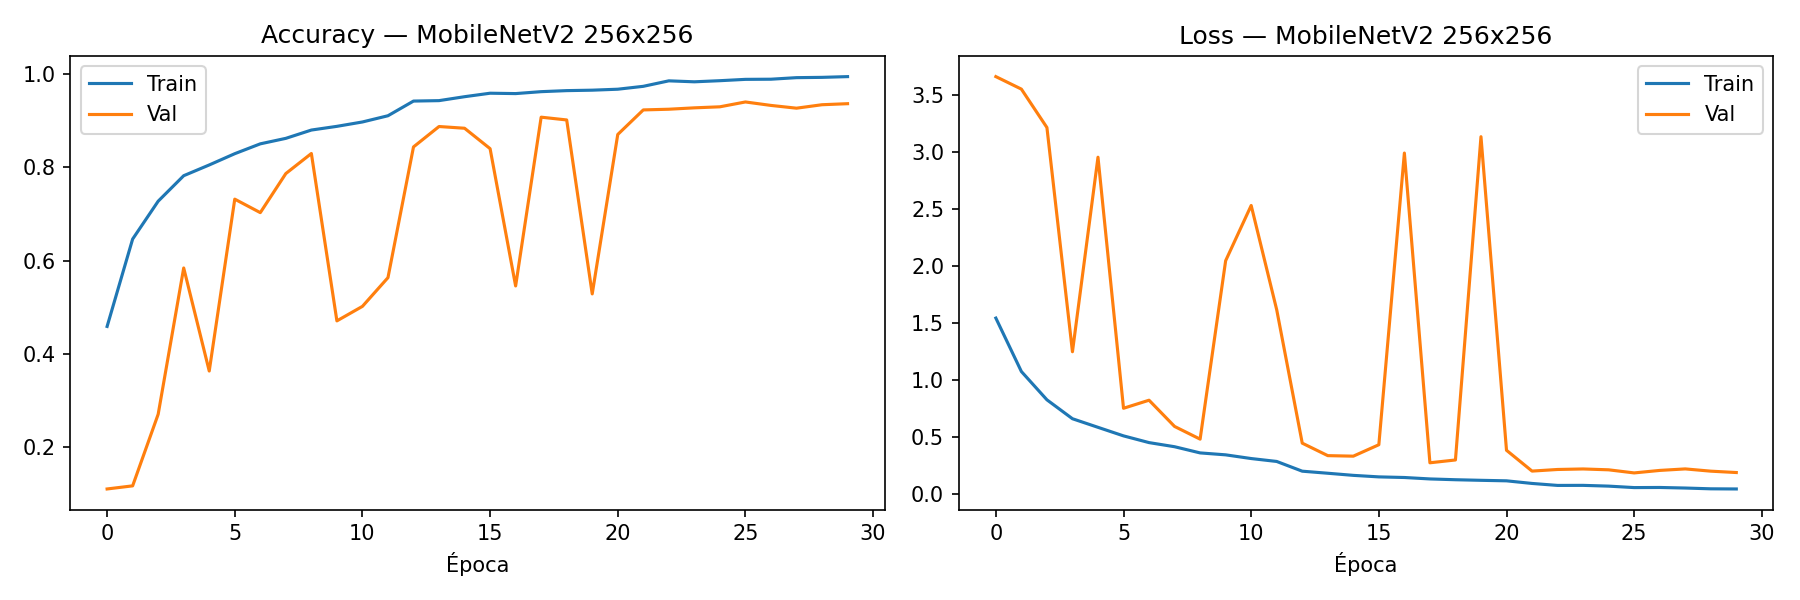
[picture p17: CNN/results/mobilenetv2/training_MobileNetV2_256x256.png]
Accuracy vs Loss in Training

* Accuracy: $0.9319$.
* Confussion Matrix:
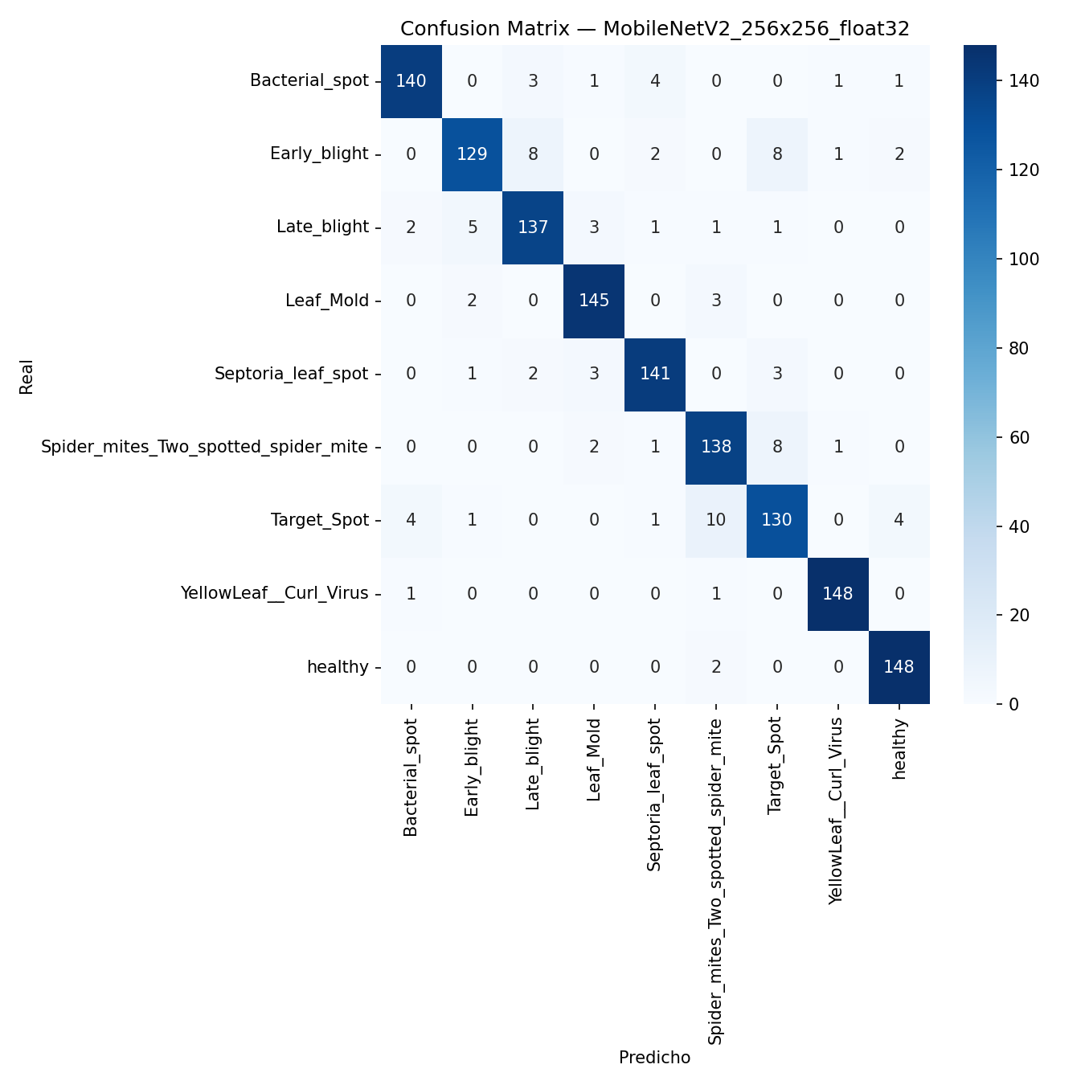
[picture p18: CNN/results/mobilenetv2/cm_MobileNetV2_256x256_float32.png]
Confussion Matrix $256$ $\times$ $256$ (float32)


Despues de esto se cuantizo a INT8, donde se obtuvieron los siguientes resultados:

* Conversion de parametros a INT8: $12.206$ s.
* Tamaño del modelo en INT8: $143.9$ KB.
* Accuracy int8: $0.9333$.
* Confussion Matrix:
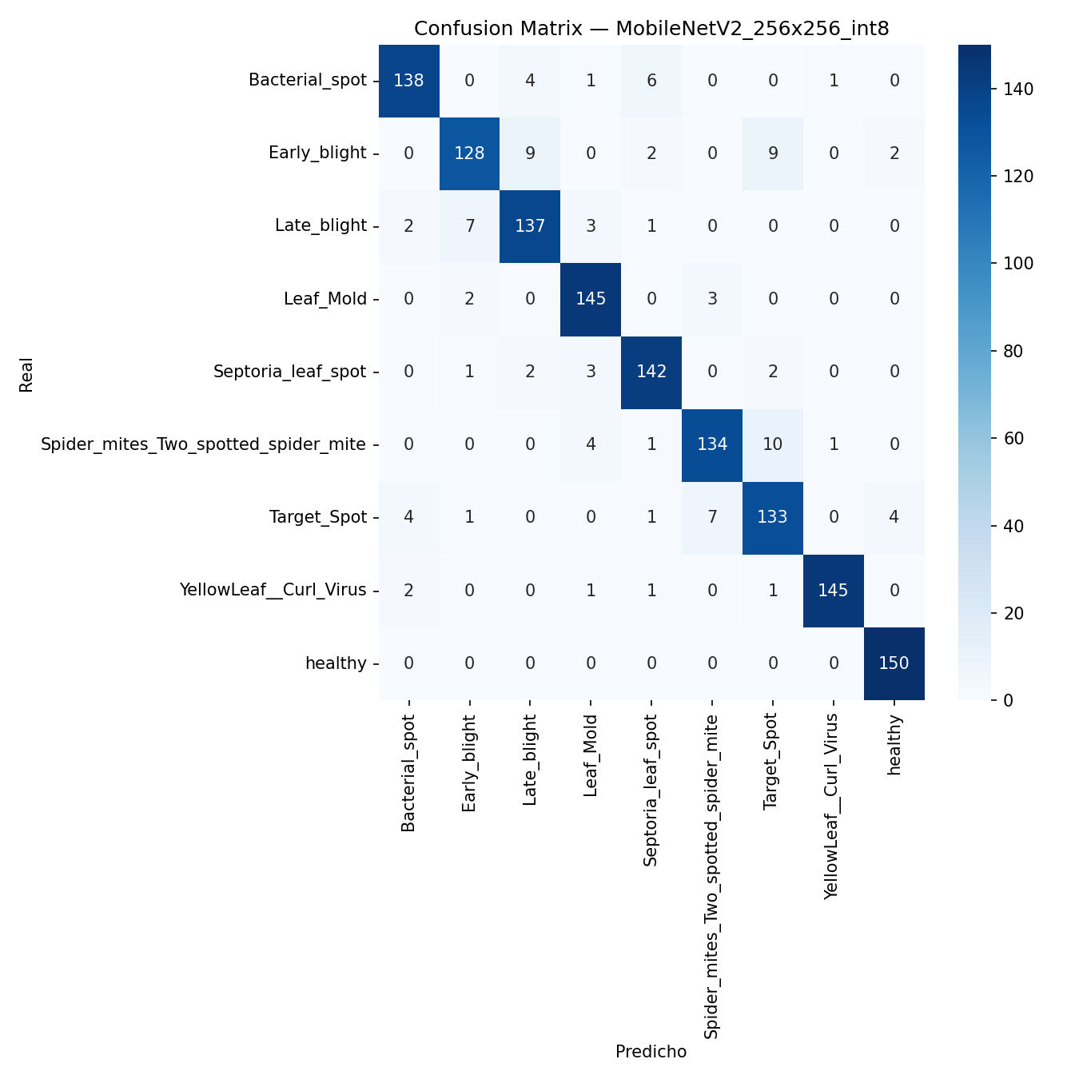
[picture p19: CNN/results/mobilenetv2/cm_MobileNetV2_256x256_int8.png]


Para finalizar tenemos el modelo cuantizado en INT16, donde los resultados fueron los siguientes:

* Conversion de parametros a INT16: $21.167$ s.
* Tamaño del modelo en INT8: $166.8$ KB.
* Accuracy int16: $0.9319$.
* Confussion Matrix:
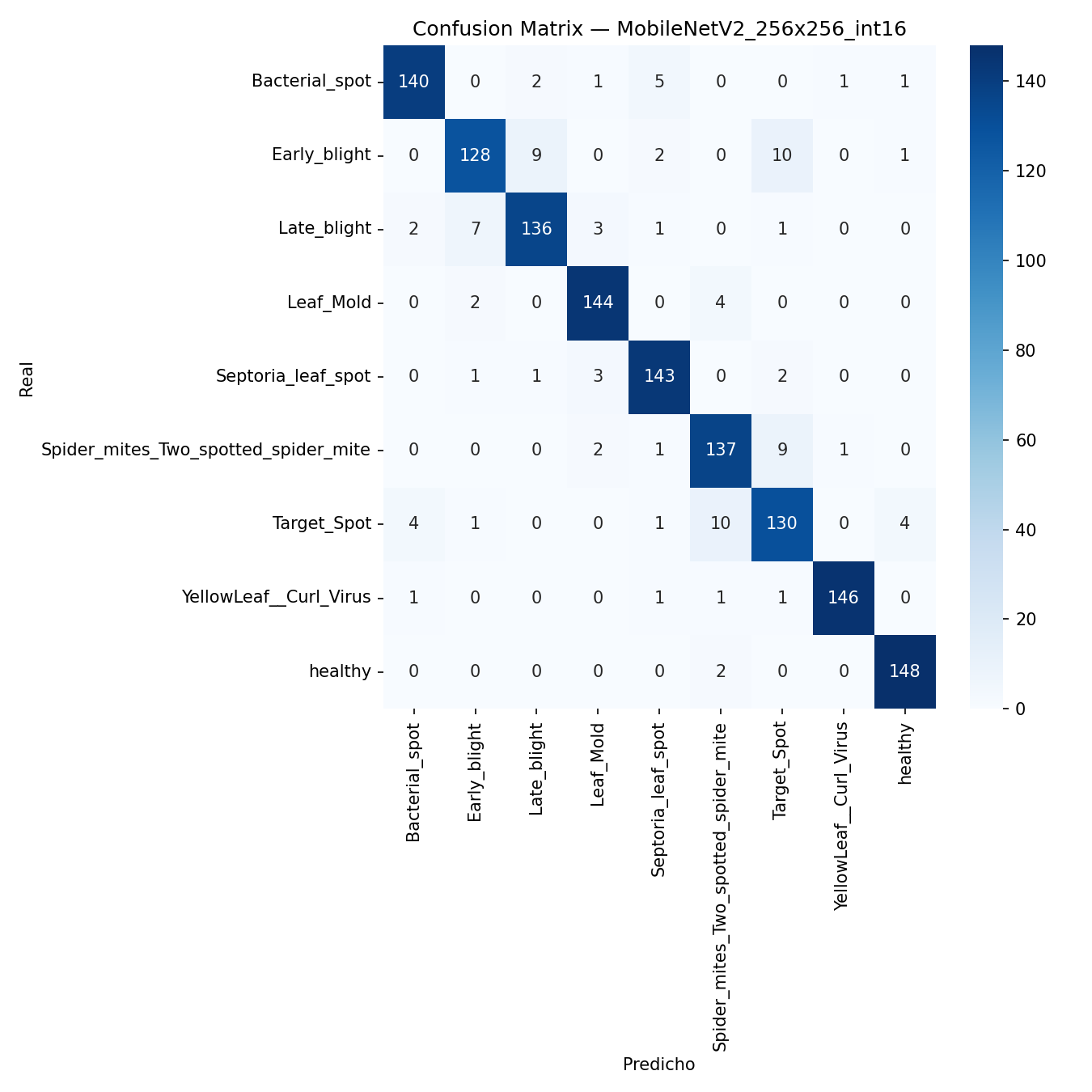
[picture p20: CNN/results/mobilenetv2/cm_MobileNetV2_256x256_int16.png]


#### RESOLUCION 128

Para la segunda etapa de entrenamiento donde se uso las imagenes con un reescalado a $128$ $\times$ $128$, los resultados obtenidos fueron los siguientes:

* Entrenamiento: $535.229$ s.
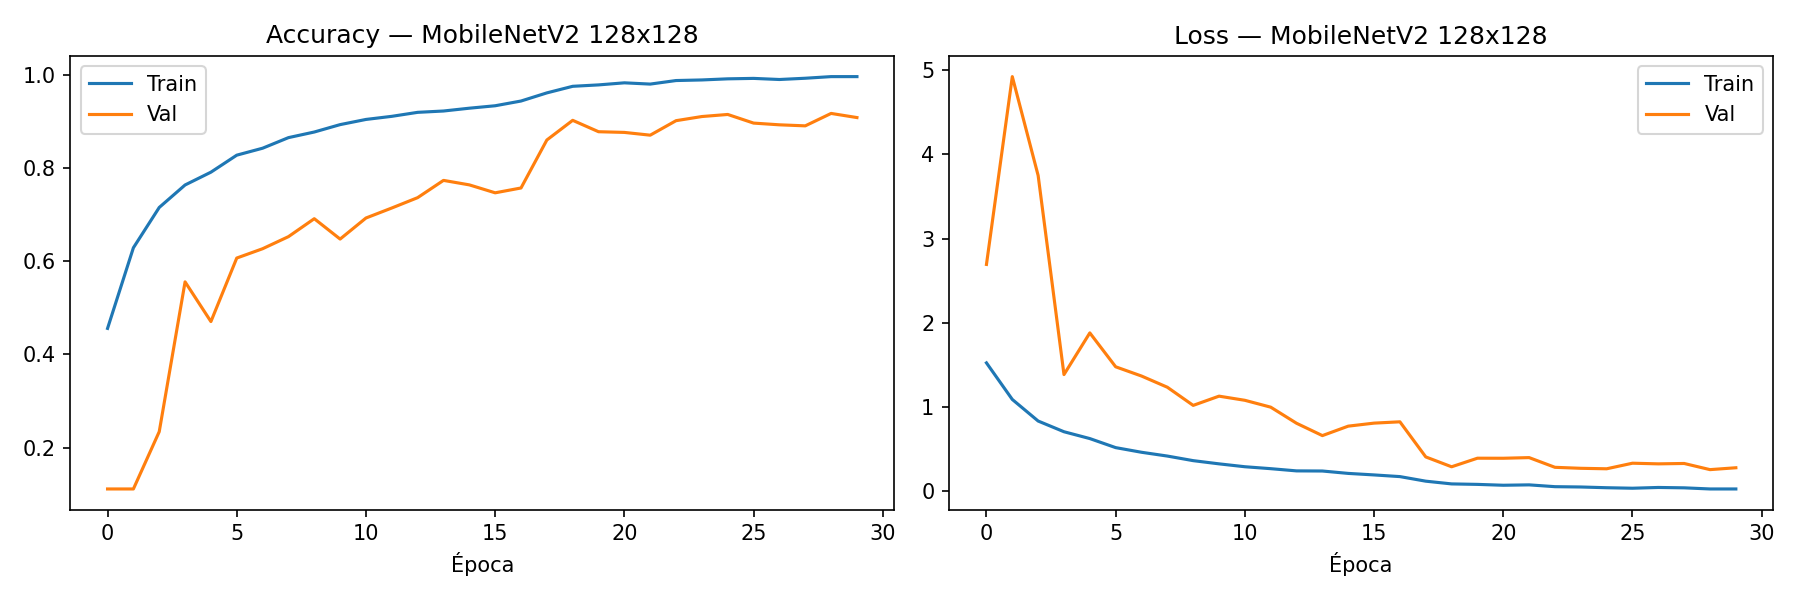
[picture p21: CNN/results/mobilenetv2/training_MobileNetV2_128x128.png]
Accuracy vs Loss in Training

* Accuracy: $0.8919$.
* Confussion Matrix:
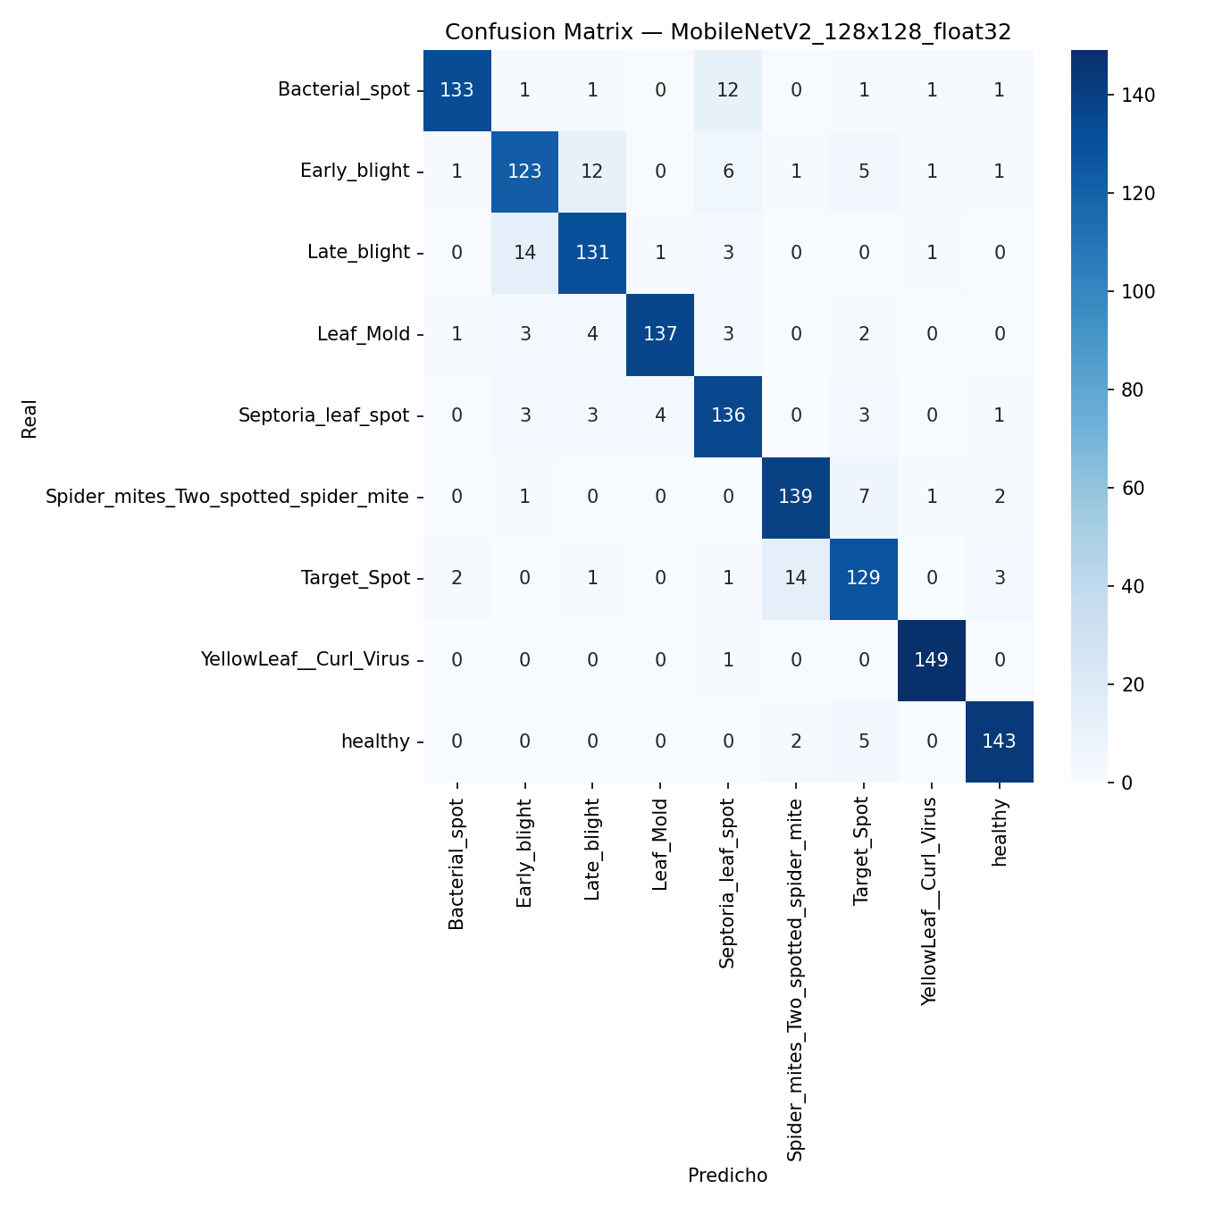
[picture p22: CNN/results/mobilenetv2/cm_MobileNetV2_128x128_float32.png]
Confussion Matrix $256$ $\times$ $256$ (float32)


Despues de esto se cuantizo a INT8, donde se obtuvieron los siguientes resultados:

* Conversion de parametros a INT8: $6.049$ s.
* Tamaño del modelo en INT8: $143.9$ KB.
* Accuracy int8: $0.8881$.
* Confussion Matrix:
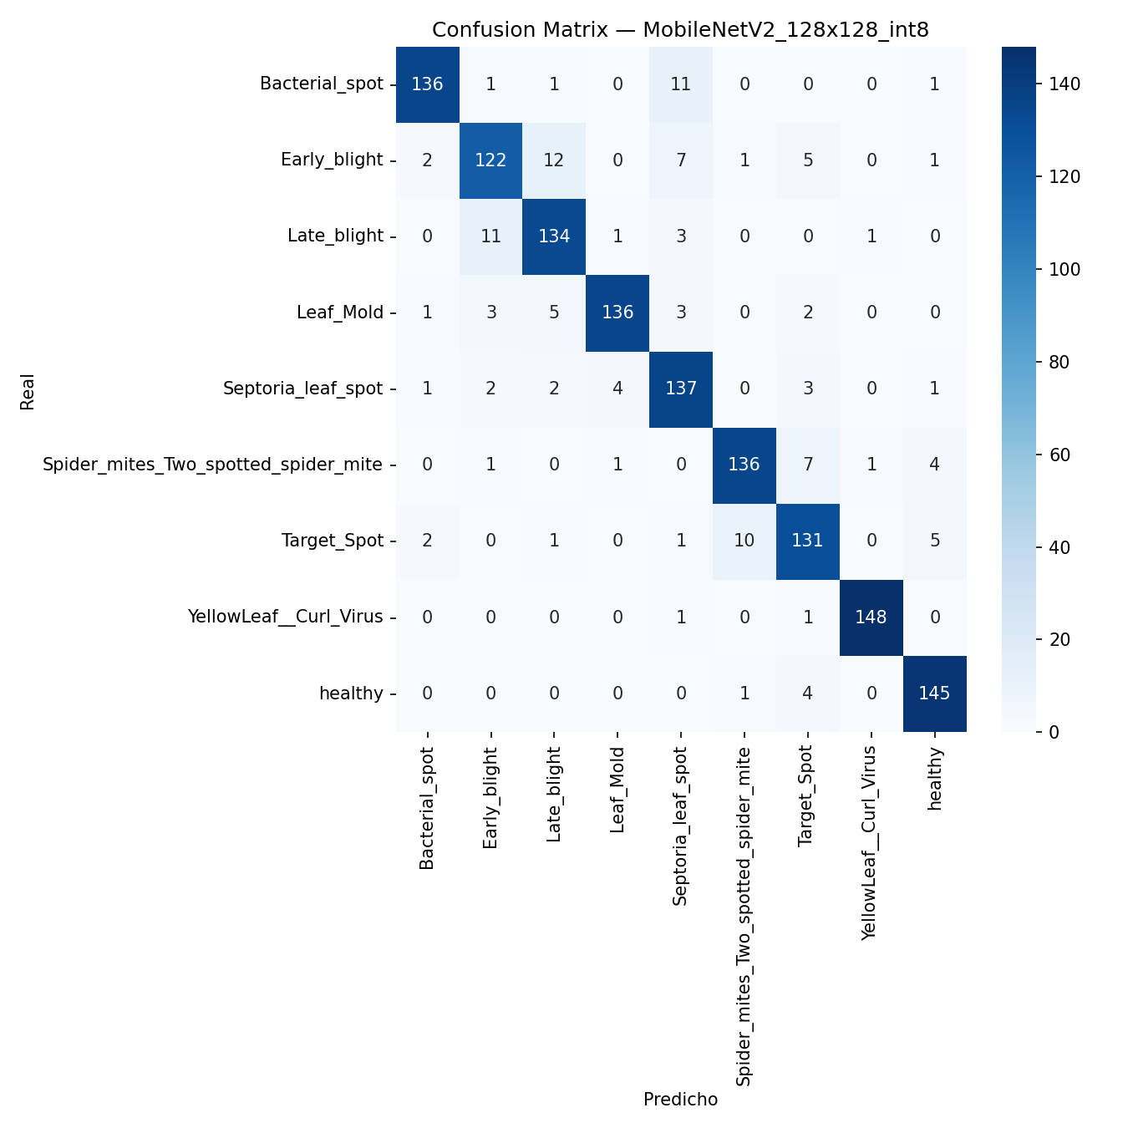
[picture p23: CNN/results/mobilenetv2/cm_MobileNetV2_128x128_int8.png]


Para finalizar tenemos el modelo cuantizado en INT16, donde los resultados fueron los siguientes:

* Conversion de parametros a INT16: $9.494$ s.
* Tamaño del modelo en INT8: $166.8$ KB.
* Accuracy int16: $0.8904$.
* Confussion Matrix:
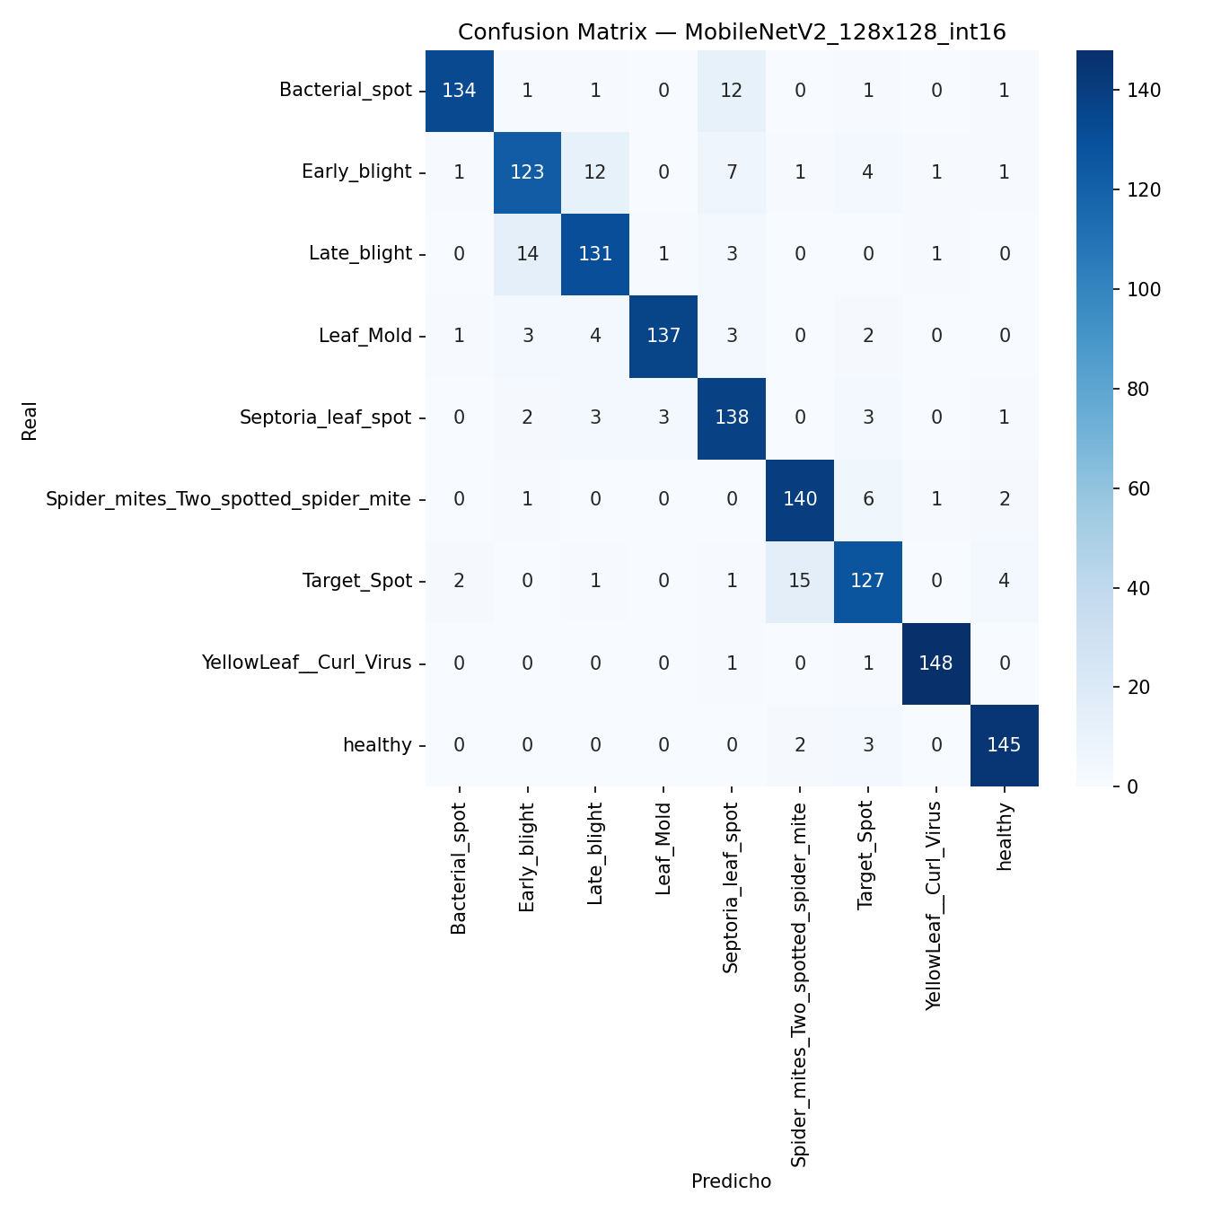
[picture p24: CNN/results/mobilenetv2/cm_MobileNetV2_128x128_int16.png]


#### RESOLUCION 96

Para la tercer etapa y ultima etapa de entrenamiento donde se uso las imagenes con un reescalado a $96$ $\times$ $96$, los resultados obtenidos fueron los siguientes:

* Entrenamiento: $537.572$ s.
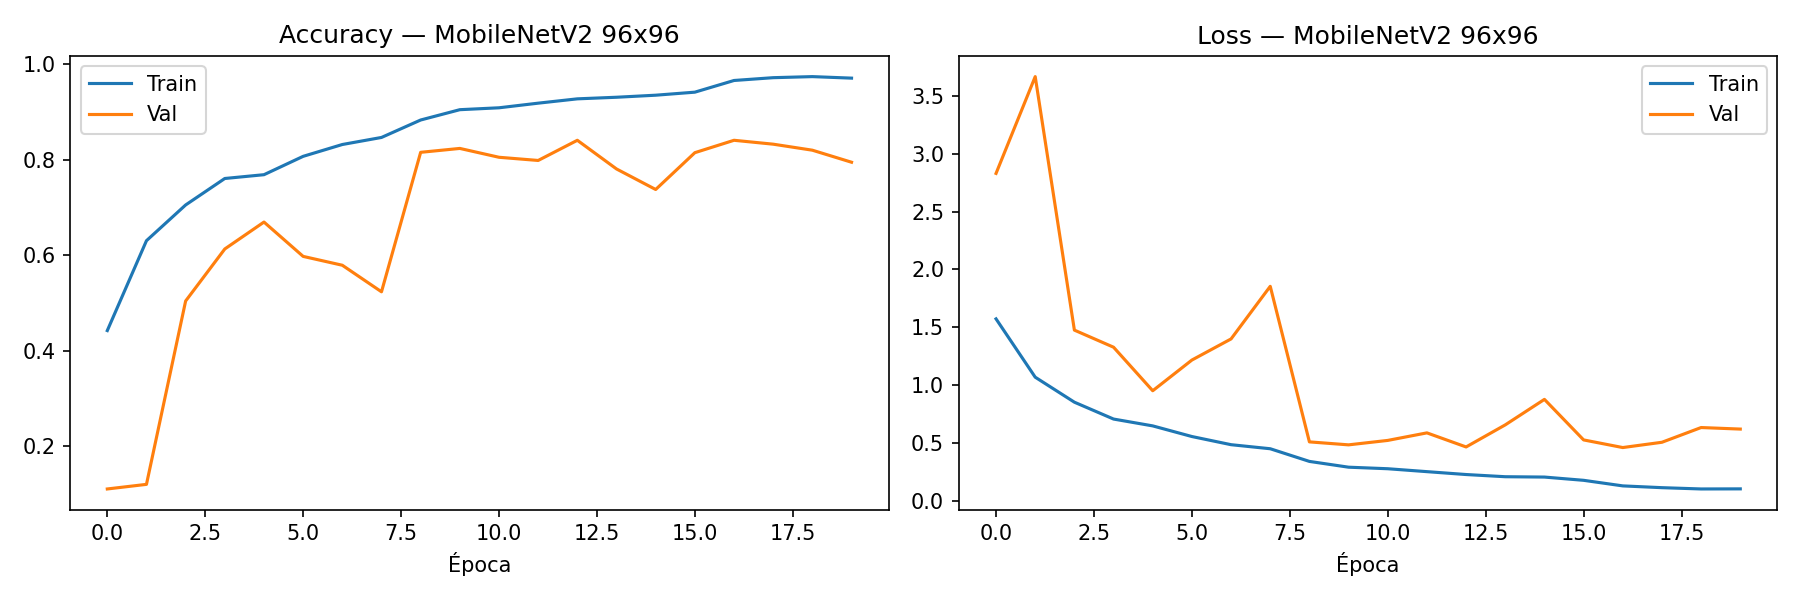
[picture p25: CNN/results/mobilenetv2/training_MobileNetV2_96x96.png]
Accuracy vs Loss in Training

* Accuracy: $0.8652$.
* Confussion Matrix:
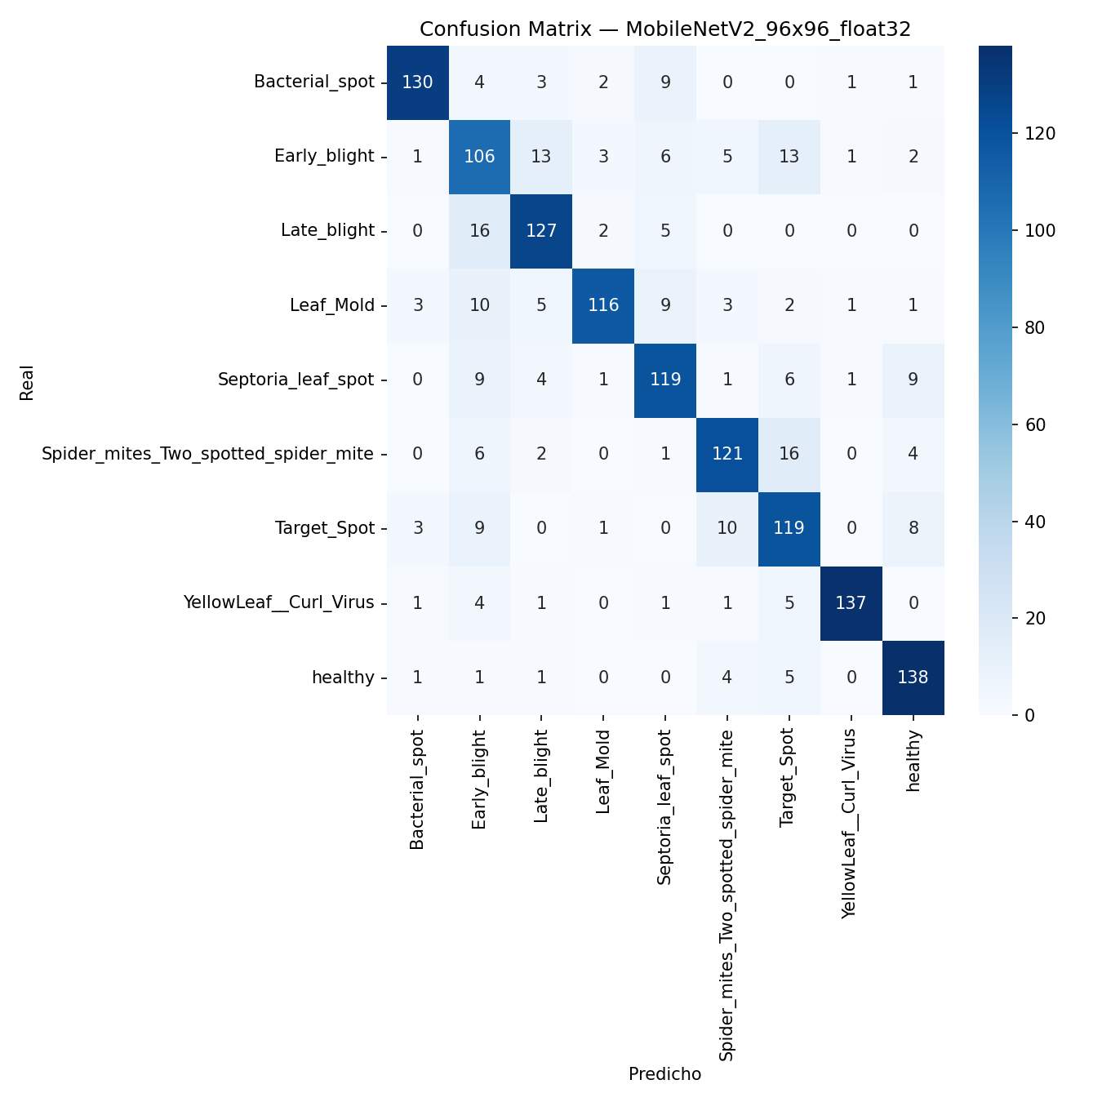
[picture p26: CNN/results/mobilenetv2/cm_MobileNetV2_96x96_float32.png]
Confussion Matrix $256$ $\times$ $256$ (float32)


Despues de esto se cuantizo a INT8, donde se obtuvieron los siguientes resultados:

* Conversion de parametros a INT8: $5.439$ s.
* Tamaño del modelo en INT8: $143.8$ KB.
* Accuracy int8: $0.8615$.
* Confussion Matrix:
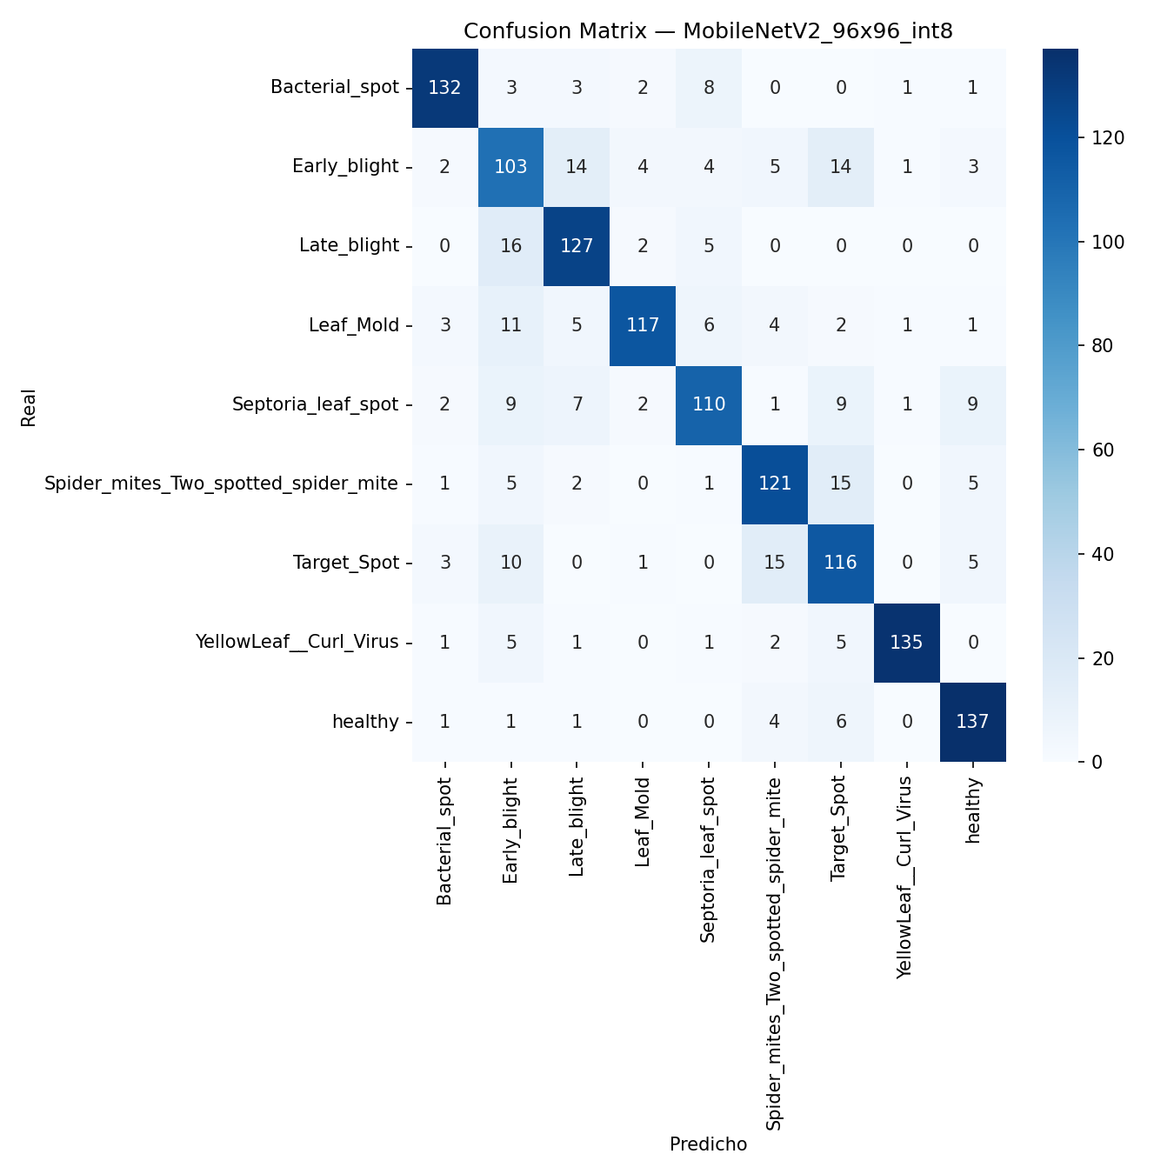
[picture p27: CNN/results/mobilenetv2/cm_MobileNetV2_96x96_int8.png]


Para finalizar tenemos el modelo cuantizado en INT16, donde los resultados fueron los siguientes:

* Conversion de parametros a INT16: $7.604$ s.
* Tamaño del modelo en INT8: $166.7$ KB.
* Accuracy int16: $0.8615$.
* Confussion Matrix:
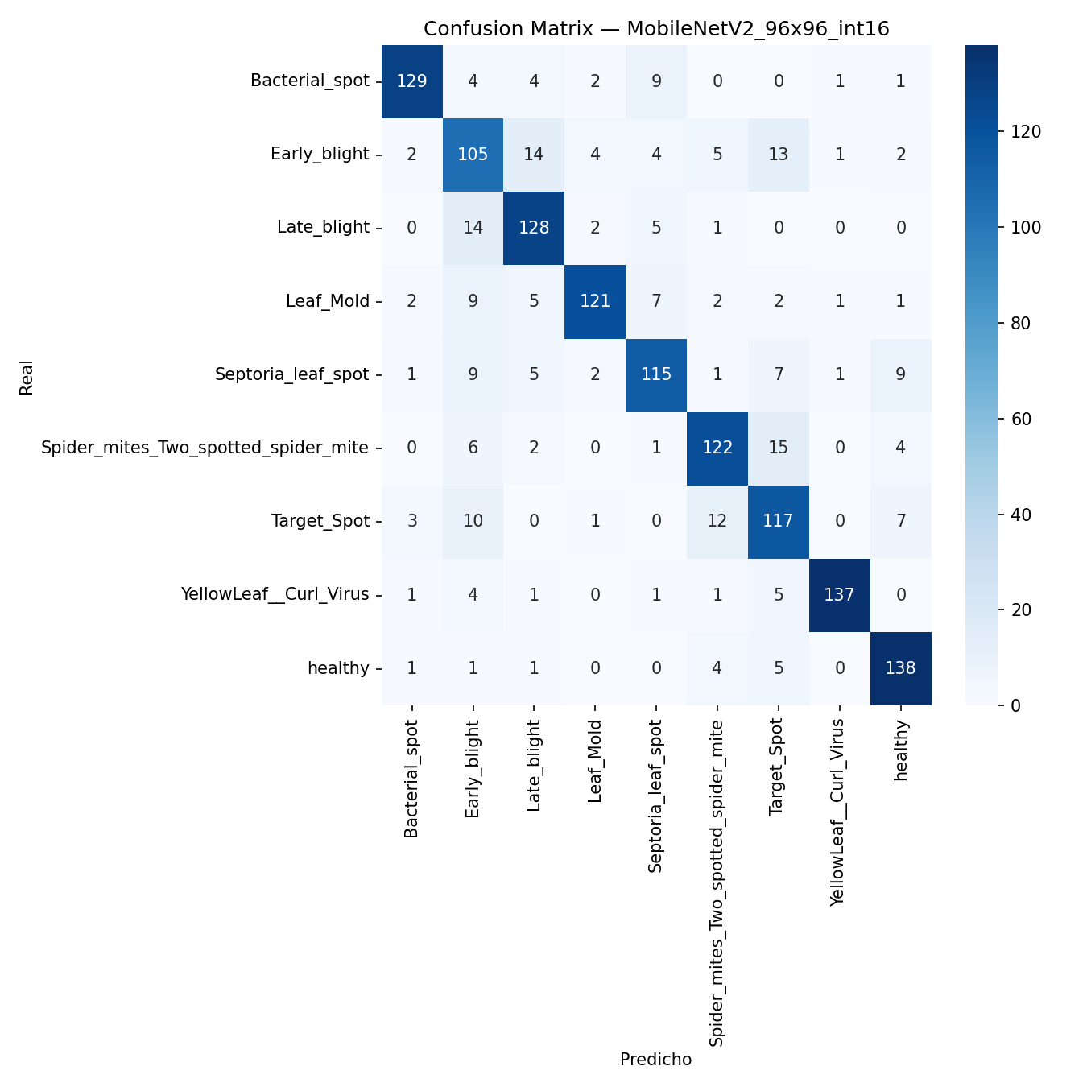
[picture p28: CNN/results/mobilenetv2/cm_MobileNetV2_96x96_int16.png]


| Resolucion | Tiempo de Entrenamiento ( s ) | Cuantizacion | Accuracy | Inferencia ( ms / img ) | Tamaño del modelo ( kB ) | Tiempo de conversion ( s ) |
|---|---|---|---|---|---|---|
| $256$ $\times$ $256$ | $835.882$ | float32 | $0.931852$ | $89.0374$ | $1333.812$ | No aplica |
| $256$ $\times$ $256$ | $835.882$ | INT8 | $0.933333$ | $7.8534$ | $143.851$ | $12.2063$ |
| $256$ $\times$ $256$ | $835.882$ | INT16 | $0.931852$ | $60.9060$ | $166.804$ | $21.1668$ |
| $128$ $\times$ $128$ | $535.229$ | float32 | $0.891852$ | $107.2005$ | $1333.645$ | No aplica |
| $128$ $\times$ $128$ | $535.229$ | INT8 | $0.888148$ | $6.9041$ | $143.851$ | $6.0487$ |
| $128$ $\times$ $128$ | $535.229$ | INT16 | $0.890370$ | $23.4037$ | $166.804$ | $9.4935$ |
| $96$ $\times$ $96$ | $537.571$ | float32 | $0.865185$ | $85.5729$ | $1333.6386$ | No aplica |
| $96$ $\times$ $96$ | $537.571$ | INT8 | $0.861481$ | $5.5657$ | $143.773$ | $35.4388$ |
| $96$ $\times$ $96$ | $537.571$ | INT16 | $0.861481$ | $14.2891$ | $166.726$ | $7.6035$ |

## Segmentacion HSV.

Despuees de haber validado dos modelos de segmentacion distintos, se tomo en cuenta el hecho de que dichos metodos debian tambian estar implementados en el harware final sobre el que correria el modelo, esto implicaba varias cosas:

* Para el caso de grabCut de openCV, el codigo fuente esta realizado en C++, e implementar dicho codigo teniendo en ceunta que no se tendra un Sistema Operativo orquestador para poder usar herramientas de mas alto nivel, entonces implicaria que todo el algoritmo debia ser implementado a C, esto conllevaria mucho tiempo de trabajo, unicamente para poder realizar la etapa de segmentacion, por lo cual esta idea se termino descartando debido a estas dificultades.

* Para el caso de la CNN U-Net, se tiene una situacion similar que con el algoritmo de grabCut, al ser esta un red neuronal convolucional, y el proposito del proyecto es acelerar redes neuronales convolucionales basadas en el modelo de MobileNetV1-V2, pues entonces, esto implicaria que dicha CNN U-Net, tambien deberia tener su mini espacio en los recursos hardware para ser acelerada y realizar la segmentacion de las imagenes, esto a grandes rasgos es implementar dos aceleradores en uno, el primero para U-Net que se encargaria de segmentar, y el acelerador para MobileNetV1-V2 para clasificar, esto complica la meta del trabajo en gran cantidad, dado que se deberia diseñar una arquitectura que sea capaz de manejar la arquitectura interna del modelo U-Net, tambien, otra opcion es delegar esta tarea a algun core del PS, pero esto seria lento, dado que los cores no son muy eficazes realizando inferencia, por lo que se generaria latencia adicional y eso es lo que se busca reducir, de esta forma entonces este metodo tambien queda descartado.

Finalmente entonces, se evaluaron posibles metodos de segmentacion que sean muy buenos a la hora de realizar su tarea principal, la cual es la de segmentar y que ademas sea facil de implementar ya esa en hardware o en software, de esta forma entonces se llego al metodo HSV, para validar que tan buen resultado podia dar dicho metodo de segmentacion, entonces se procedio a realizar un entrenamiento para los modelos de MoibleNetV1 y MobileNetV2, cada uno en las resoluciones ya vistas anteriormente y en las cuantizaciones respectivas, donde se llego al siguiente resultado:

| Modelo | Resolucion | Tiempo de Entrenamiento ( s ) | Cuantizacion | Accuracy | Inferencia ( ms / img ) | Tamaño del modelo ( kB ) | Tiempo de conversion ( s ) |
|---|---|---|---|---|---|---|---|
| MobileNetV1 | $256$ $\times$ $256$ | $1018.646$ | float32 | $00.894815$ | $75.6133$ | $1112.443$ | No aplica |
| MobileNetV1 | $256$ $\times$ $256$ | $1018.646$ | INT8 | $0.891852$ | $10.8527$ | $121.171$ | $11.5081$ |
| MobileNetV1 | $256$ $\times$ $256$ | $1018.646$ | INT16 | $0.893333$ | $69.1207$ | $142.296$ | $21.0533$ |
| MobileNetV1 | $128$ $\times$ $128$ | $776.667$ | float32 | $0.834815$ | $70.5669$ | $1112.297$ | No aplica |
| MobileNetV1 | $128$ $\times$ $128$ | $776.667$ | INT8 | $0.829630$ | $10.0106$ | $121.171$ | $7.7092$ |
| MobileNetV1 | $128$ $\times$ $128$ | $776.667$ | INT16 | $0.830370$ | $27.6465$ | $142.296$ | $10.6148$ |
| MobileNetV1 | $96$ $\times$ $96$ | $752.522$ | float32 | $0.688148$ | $82.5353$ | $1112.291$ | No aplica |
| MobileNetV1 | $96$ $\times$ $96$ | $752.522$ | INT8 | $0.687407$ | $10.3658$ | $121.015$ | $6.2473$ |
| MobileNetV1 | $96$ $\times$ $96$ | $752.522$ | INT16 | $0.691852$ | $19.5669$ | $142.140$ | $9.2255$ |
| MobileNetV2 | $256$ $\times$ $256$ | $964.043$ | float32 | $0.942222$ | $81.1592$ | $1333.805$ | No aplica |
| MobileNetV2 | $256$ $\times$ $256$ | $964.043$ | INT8 | $0.941481$ | $11.1495$ | $143.320$ | $11.9327$ |
| MobileNetV2 | $256$ $\times$ $256$ | $964.043$ | INT16 | $0.941481$ | $60.0587$ | $166.242$ | $20.491$ |
| MobileNetV2 | $128$ $\times$ $128$ | $744.527$ | float32 | $0.900000$ | $79.6877$ | $1333.638$ | No aplica |
| MobileNetV2 | $128$ $\times$ $128$ | $744.527$ | INT8 | $0.898519$ | $6.8753$ | $143.320$ | $6.675$ |
| MobileNetV2 | $128$ $\times$ $128$ | $744.527$ | INT16 | $0.900000$ | $21.5922$ | $166.242$ | $8.900$ |
| MobileNetV2 | $96$ $\times$ $96$ | $746.734$ | float32 | $0.863704$ | $76.5758$ | $1333.631$ | No aplica |
| MobileNetV2 | $96$ $\times$ $96$ | $746.734$ | INT8 | $0.864444$ | $8.4222$ | $143.132$ | $5.971$ |
| MobileNetV2 | $96$ $\times$ $96$ | $746.734$ | INT16 | $0.861481$ | $16.6644$ | $166.046$ | $8.199$ |

Con los resultados obtenidos en esta etapa, se decidio finalmente seguir trabajando con el modelo de Mobile-NetV2, en la resolucion de $256$ $\times$ $256$ y con cuantizacion INT8.
