angel-obando-17/CNN-accelerator-on-SoC/images/asm_addr_generator.png

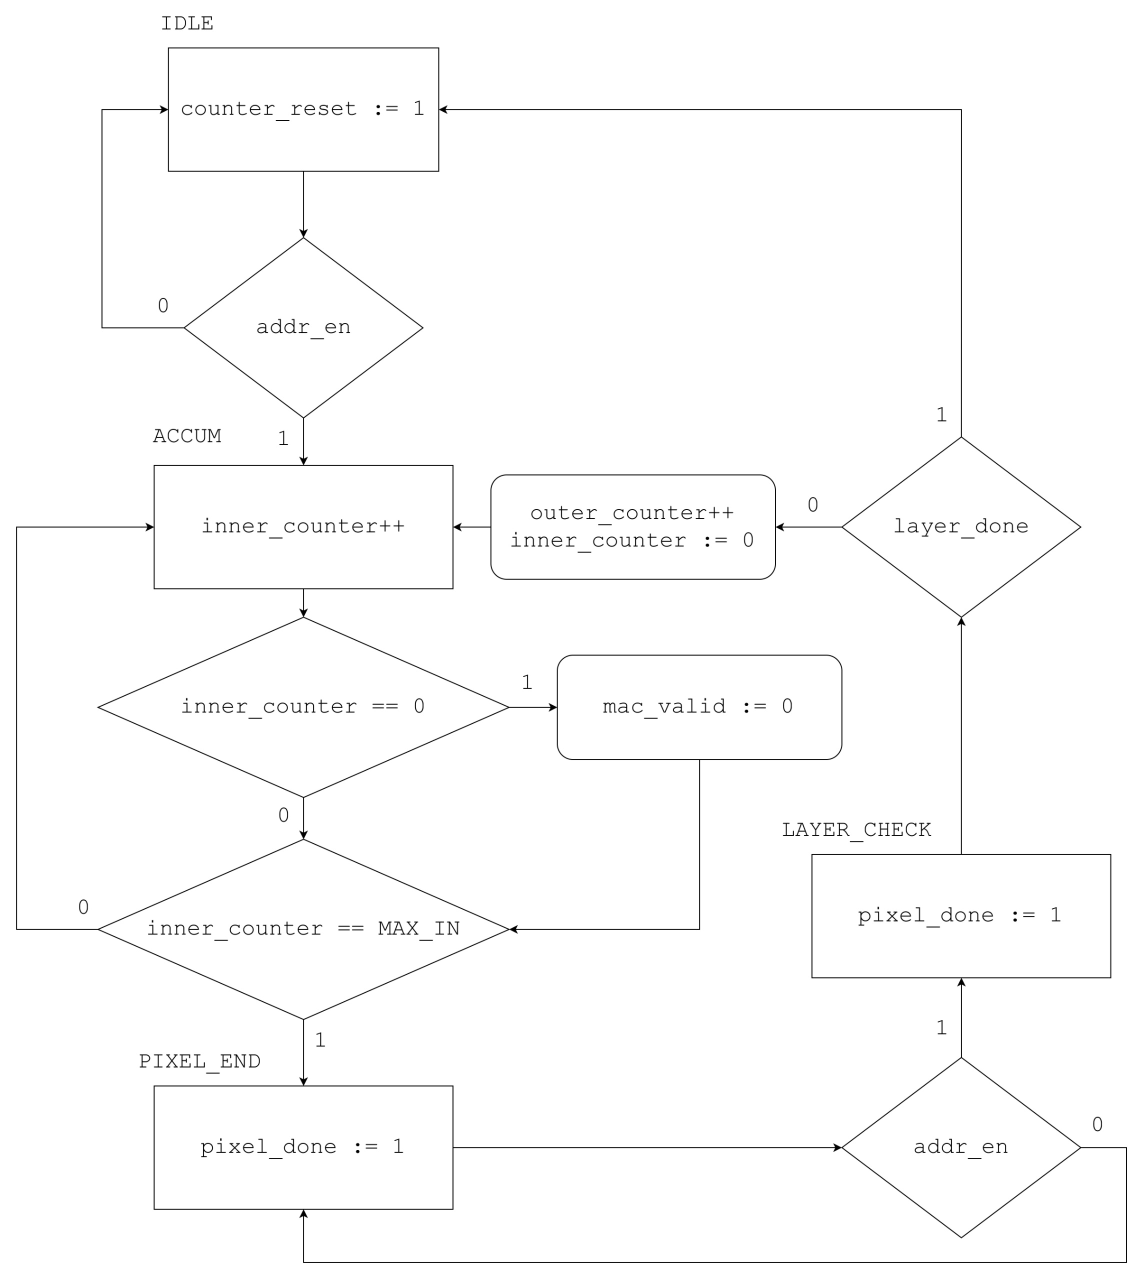
images/asm_addr_generator.png
