angel-obando-17/CNN-accelerator-on-SoC/CNN/resultados_comparativa/comparativa_modelos.png

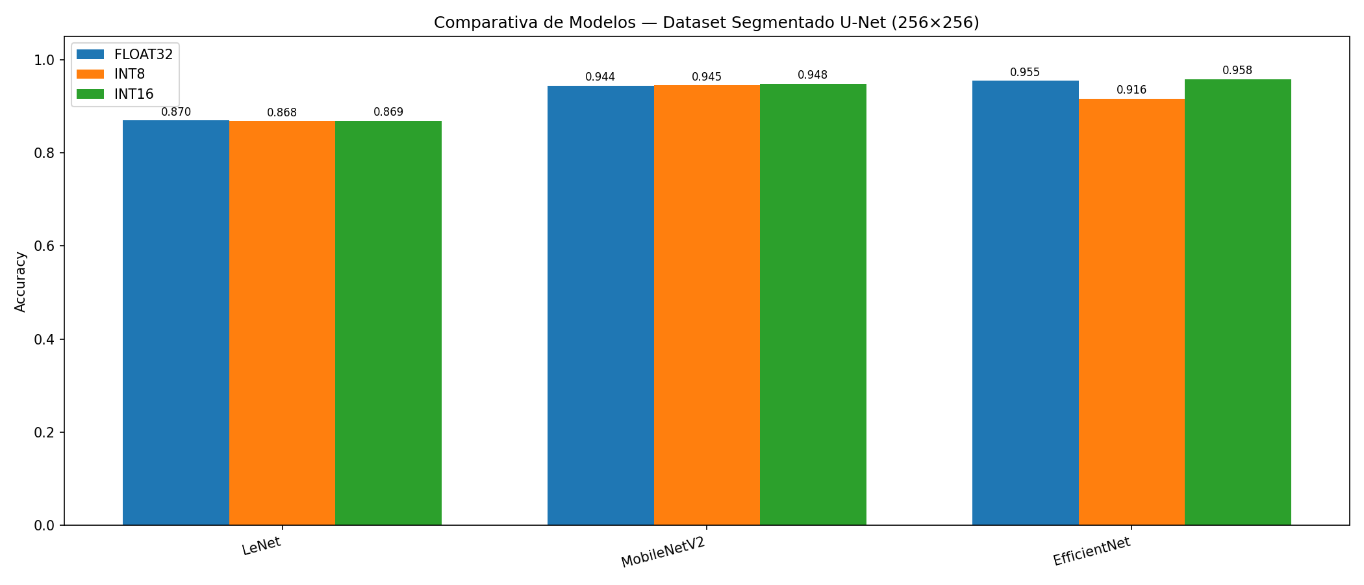
CNN/resultados_comparativa/comparativa_modelos.png
