angel-obando-17/CNN-accelerator-on-SoC/CNN/resultados_experimentos/imagenes_segmentadas/grid_Tomato__Target_Spot.png

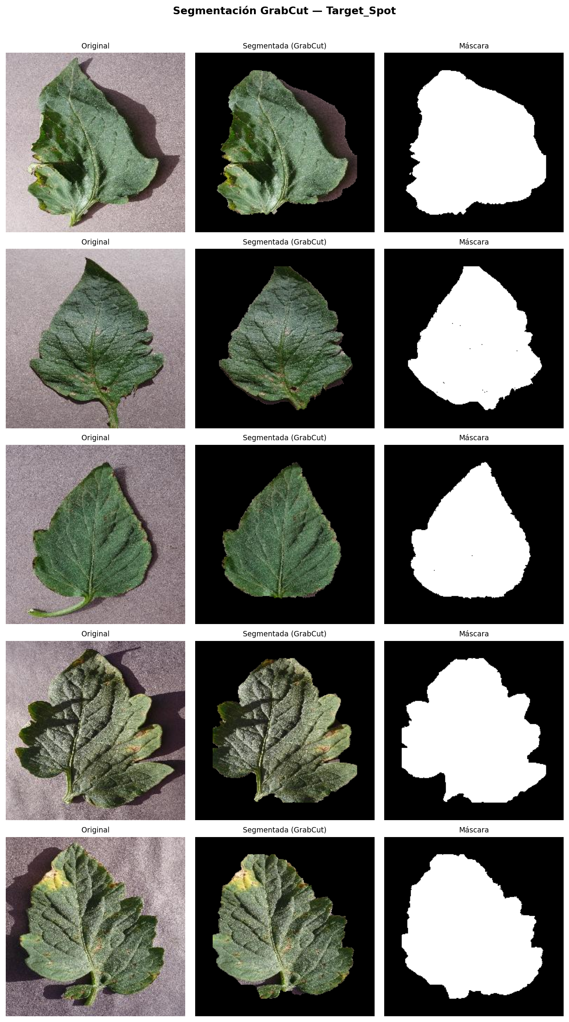
CNN/resultados_experimentos/imagenes_segmentadas/grid_Tomato__Target_Spot.png
