angel-obando-17/CNN-accelerator-on-SoC/CNN/resultados_experimentos/imagenes_segmentadas/grid_Tomato__Tomato_YellowLeaf__Curl_Virus.png

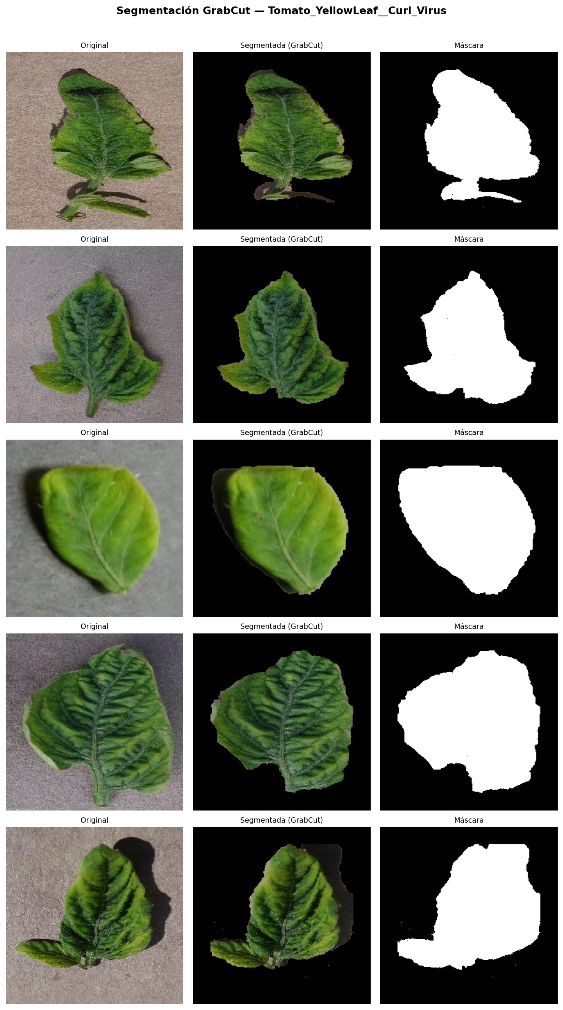
CNN/resultados_experimentos/imagenes_segmentadas/grid_Tomato__Tomato_YellowLeaf__Curl_Virus.png
