angel-obando-17/CNN-accelerator-on-SoC/CNN/resultados_experimentos/imagenes_segmentadas/grid_Tomato_Early_blight.png

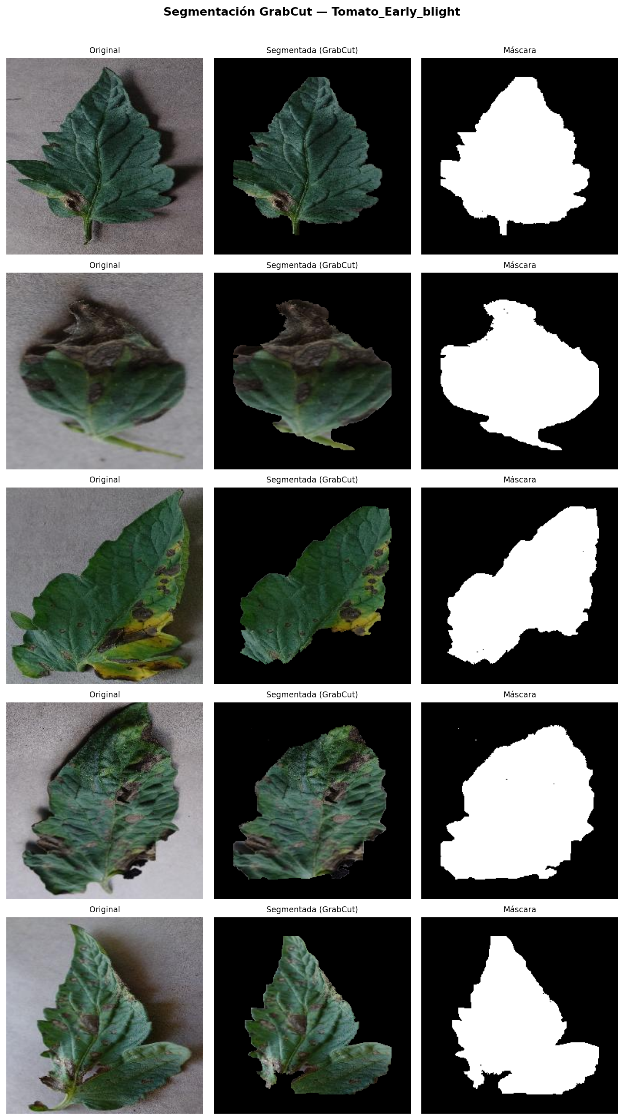
CNN/resultados_experimentos/imagenes_segmentadas/grid_Tomato_Early_blight.png
