angel-obando-17/CNN-accelerator-on-SoC/CNN/resultados_experimentos/imagenes_segmentadas/grid_Tomato_Leaf_Mold.png

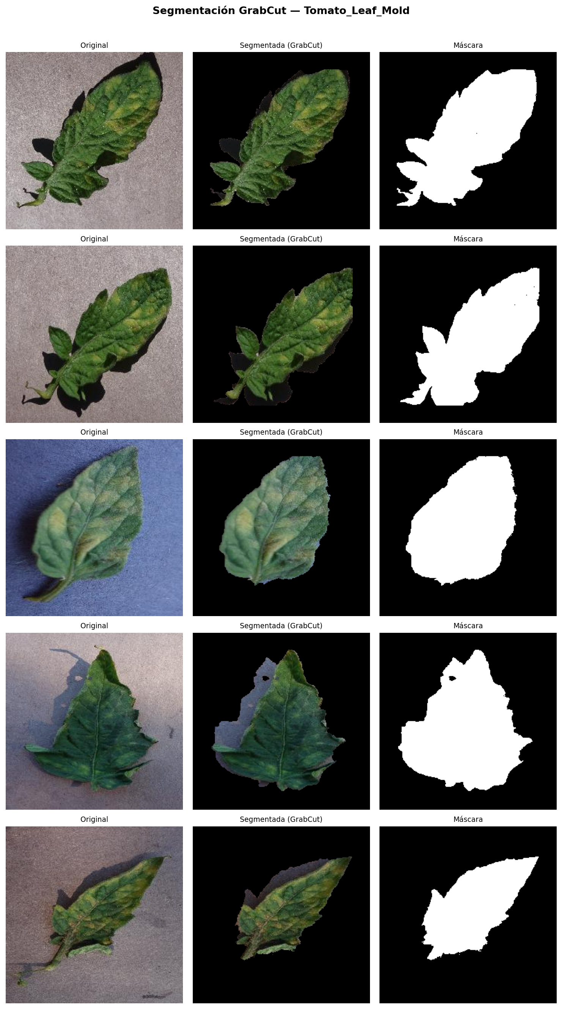
CNN/resultados_experimentos/imagenes_segmentadas/grid_Tomato_Leaf_Mold.png
