angel-obando-17/CNN-accelerator-on-SoC/CNN/resultados_experimentos/imagenes_segmentadas/grid_Tomato_Septoria_leaf_spot.png

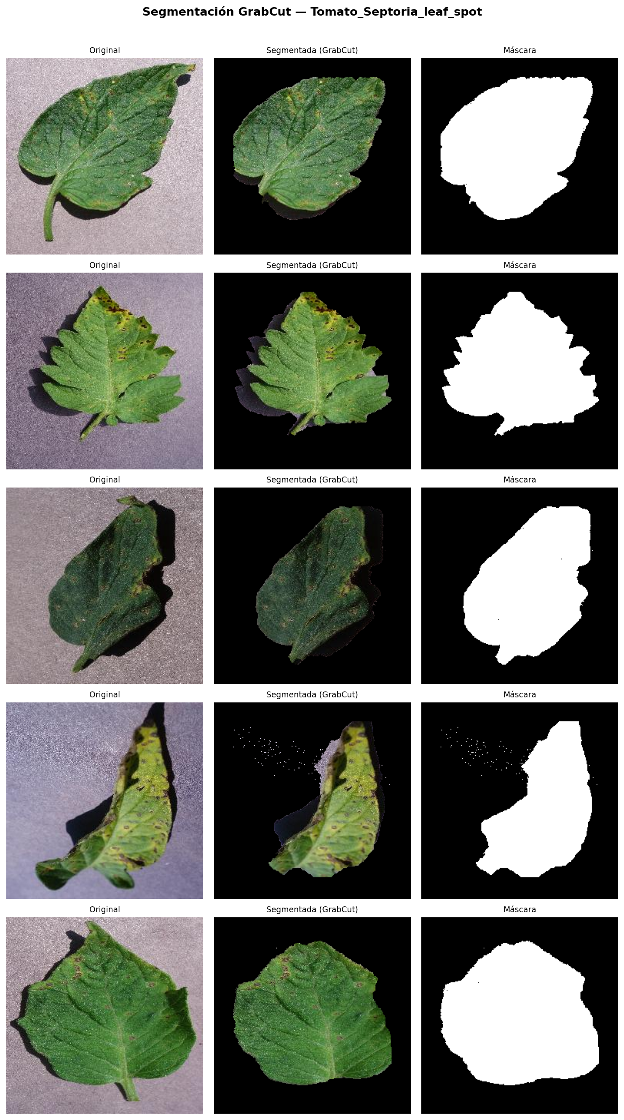
CNN/resultados_experimentos/imagenes_segmentadas/grid_Tomato_Septoria_leaf_spot.png
