angel-obando-17/CNN-accelerator-on-SoC/CNN/resultados_experimentos/segmentacion/unet_predicciones.png

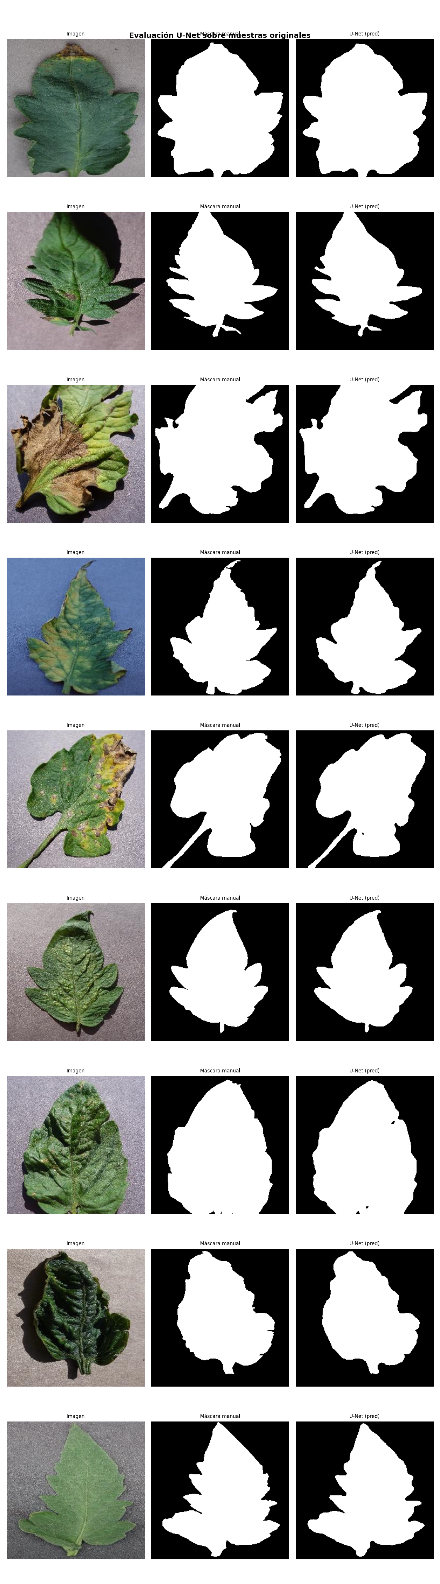
CNN/resultados_experimentos/segmentacion/unet_predicciones.png
