angel-obando-17/CNN-accelerator-on-SoC/CNN/resultados_experimentos/segmentacion/unet_training.png

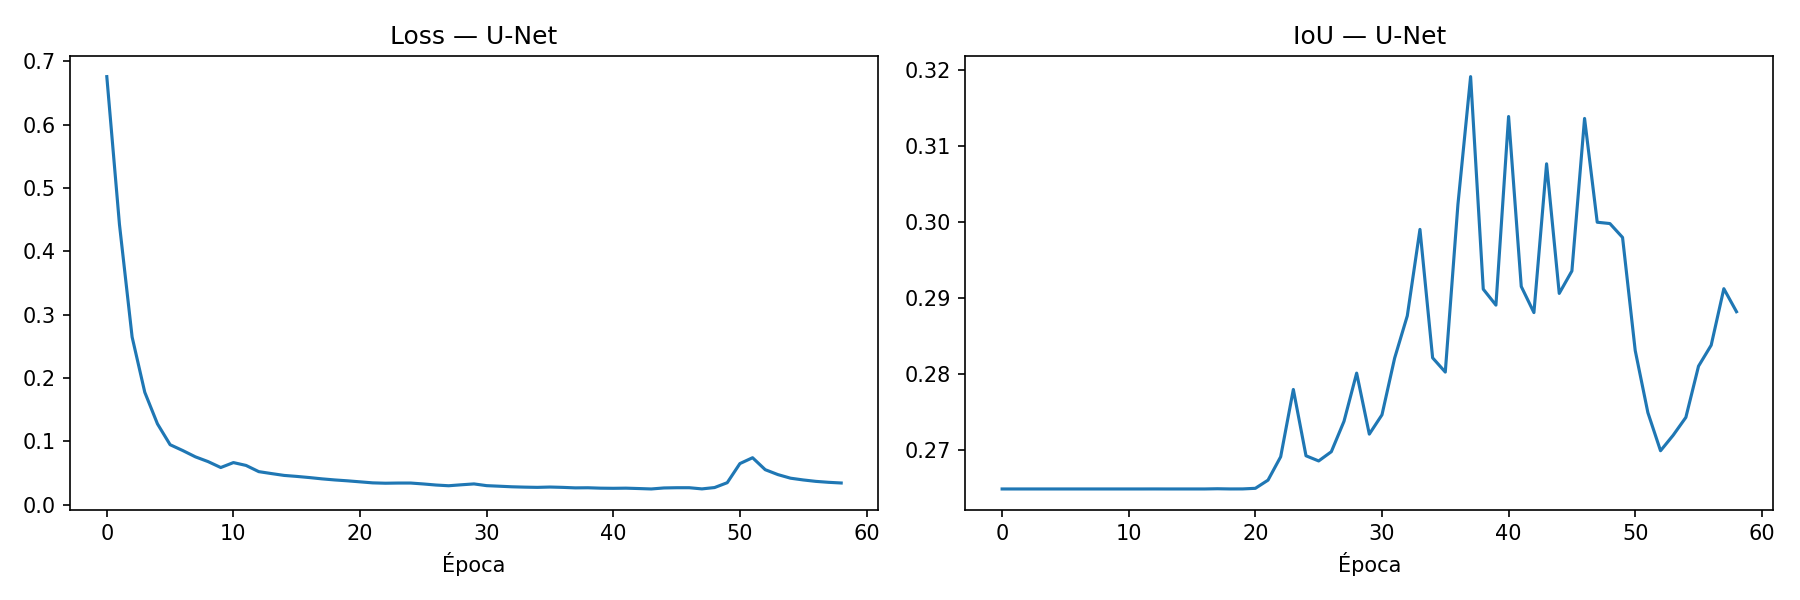
CNN/resultados_experimentos/segmentacion/unet_training.png
