angel-obando-17/CNN-accelerator-on-SoC/CNN/resultados_experimentos/summary_accuracy.png

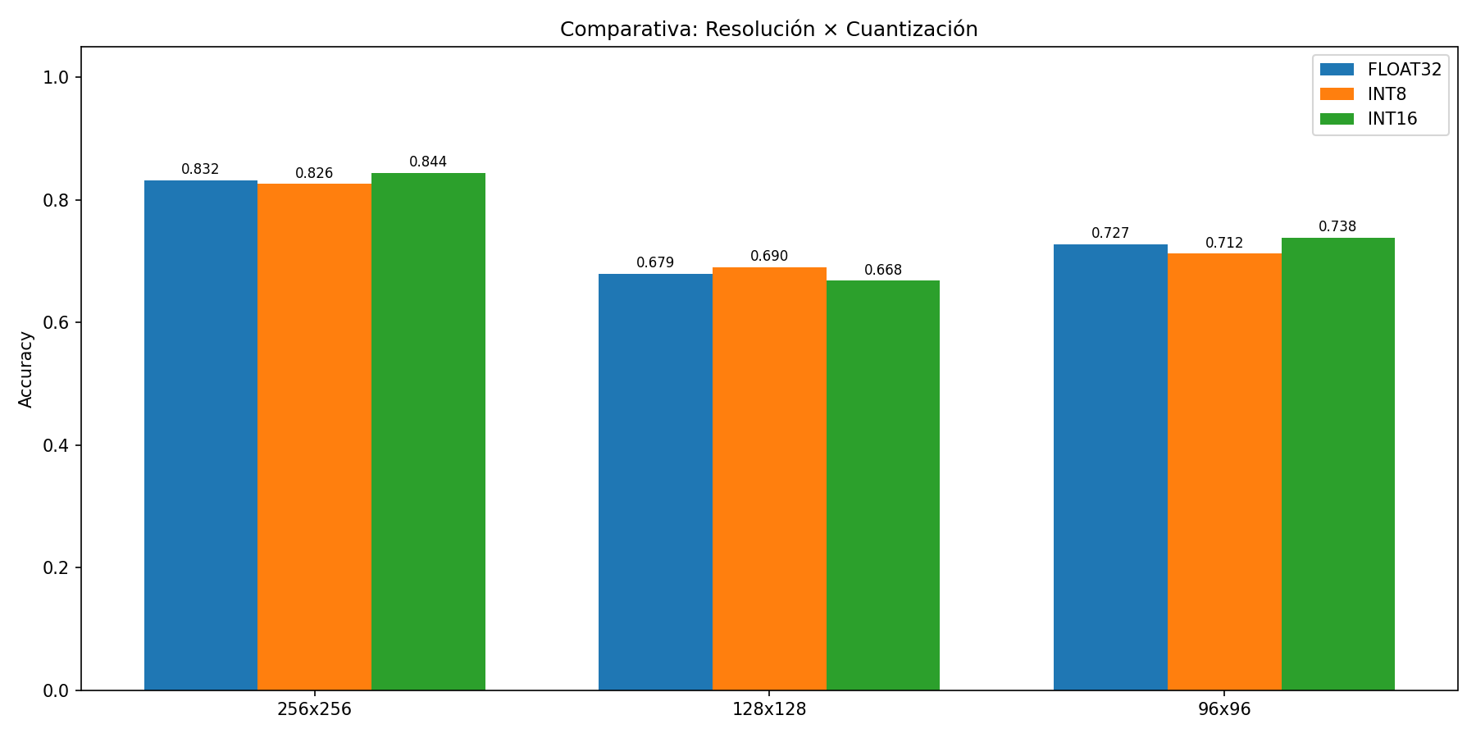
CNN/resultados_experimentos/summary_accuracy.png
