angel-obando-17/CNN-accelerator-on-SoC/CNN/resultados_experimentos/training_96x96.png

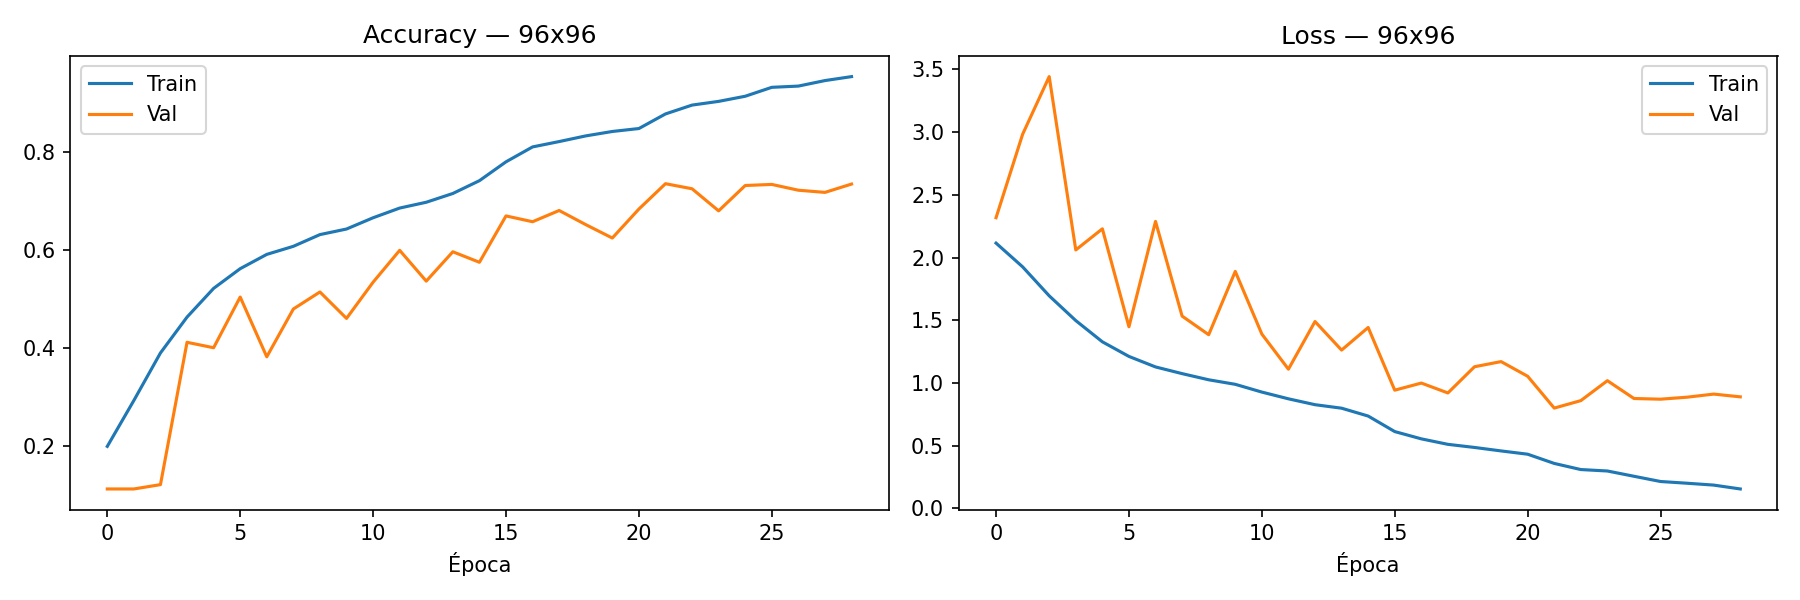
CNN/resultados_experimentos/training_96x96.png
