angel-obando-17/CNN-accelerator-on-SoC/CNN/resultados_experimentos/training_256x256.png

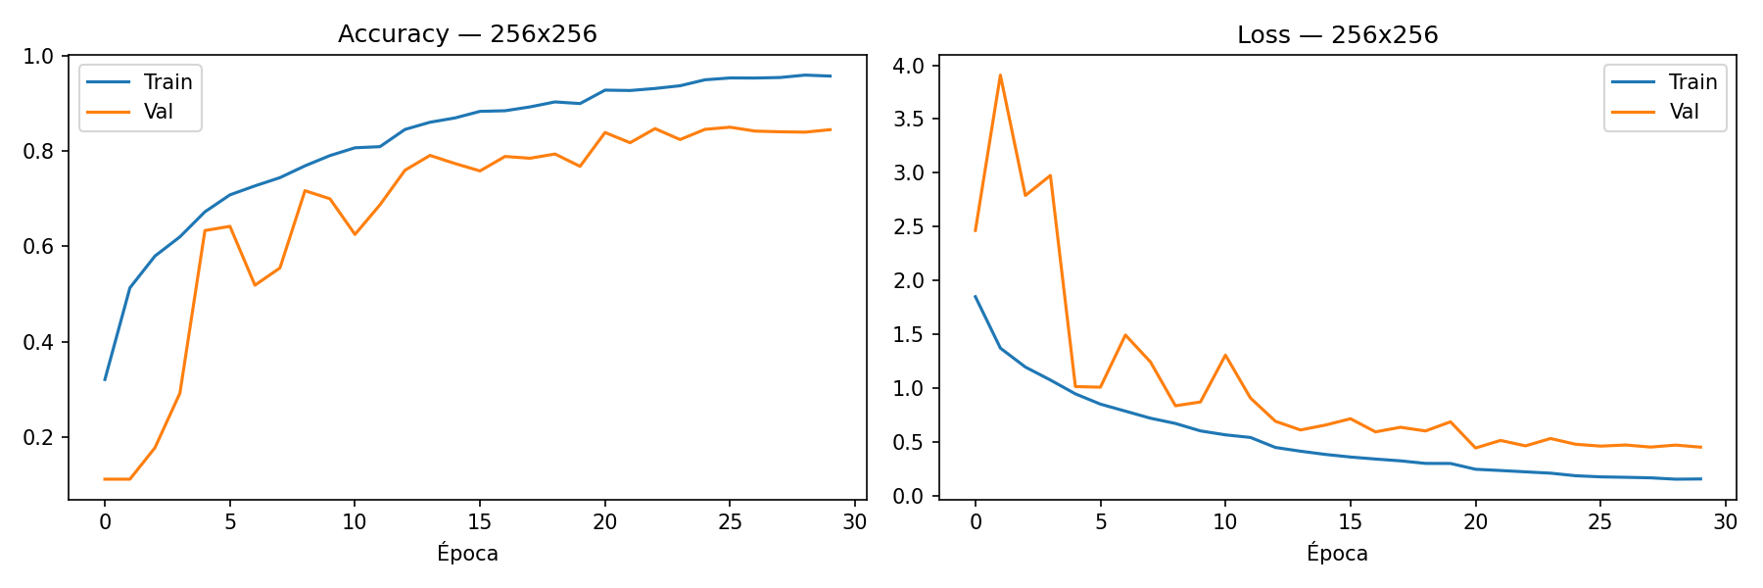
CNN/resultados_experimentos/training_256x256.png
