angel-obando-17/CNN-accelerator-on-SoC/CNN/resultados_experimentos_2/training_128x128.png

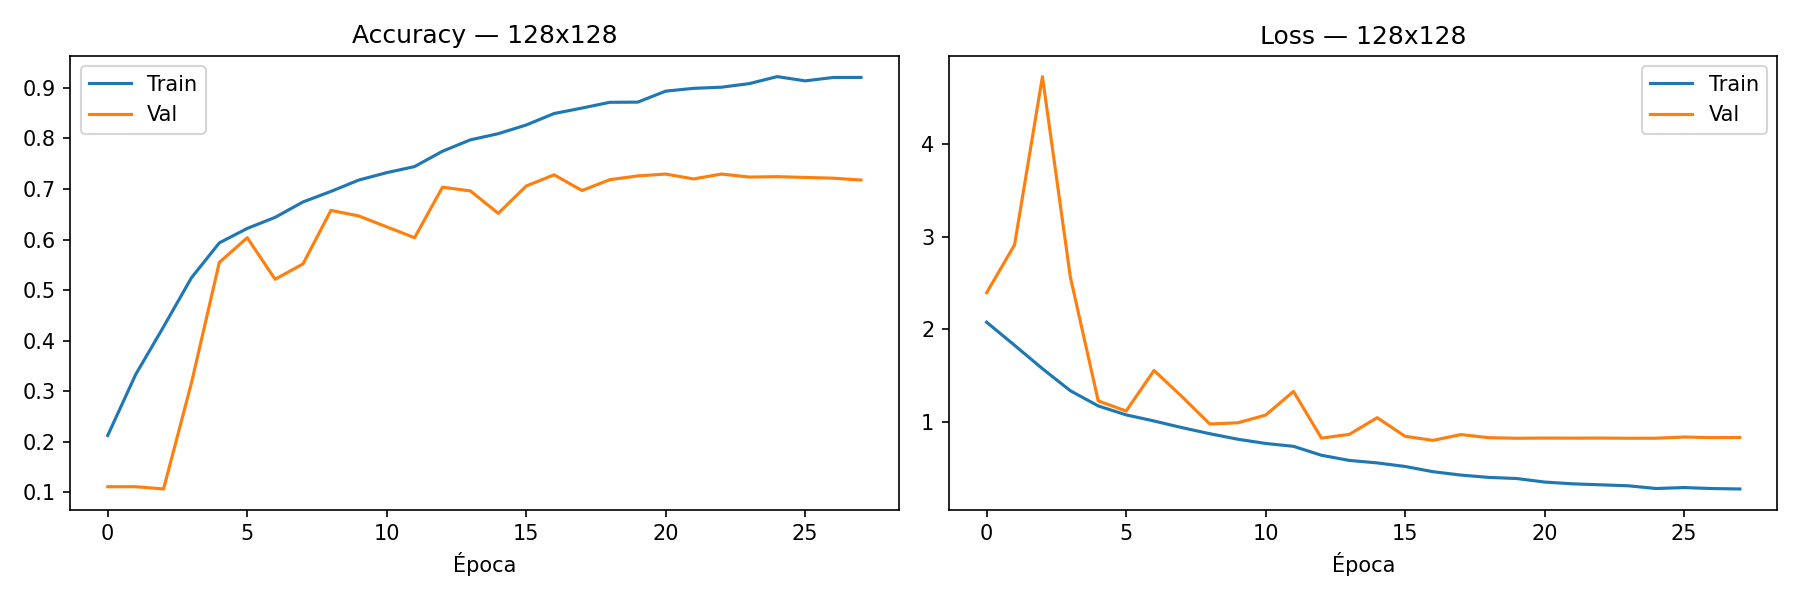
CNN/resultados_experimentos_2/training_128x128.png
