angel-obando-17/CNN-accelerator-on-SoC/CNN/results/hsv/segmentacion_muestras_hsv.png

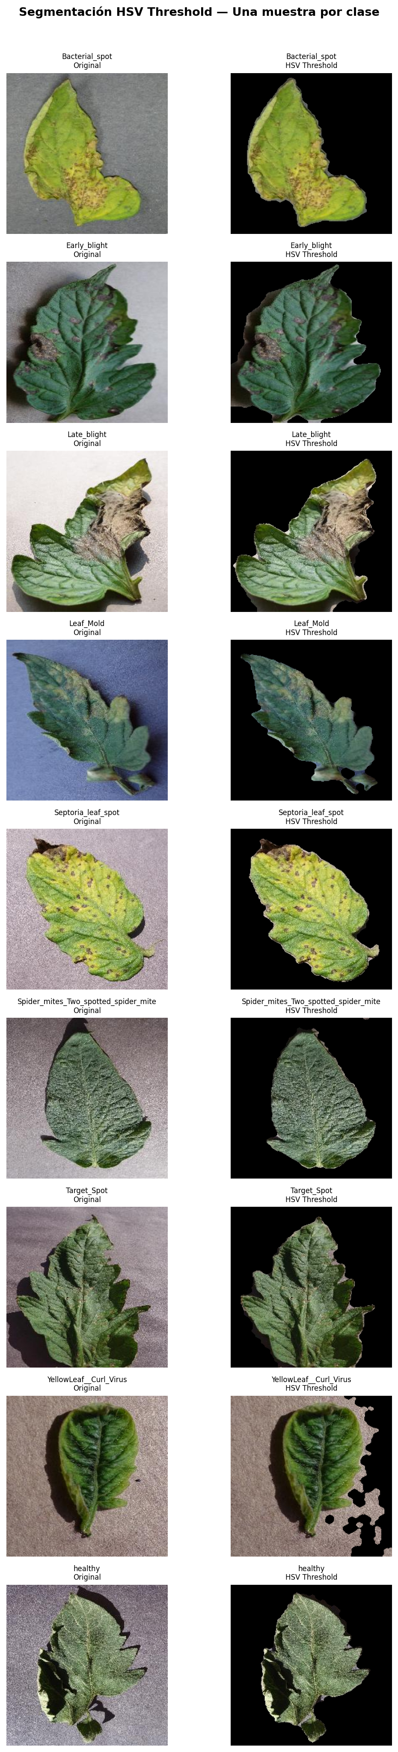
CNN/results/hsv/segmentacion_muestras_hsv.png
