angel-obando-17/CNN-accelerator-on-SoC/CNN/results/hsv/training_MobileNetV1_HSV_128x128.png

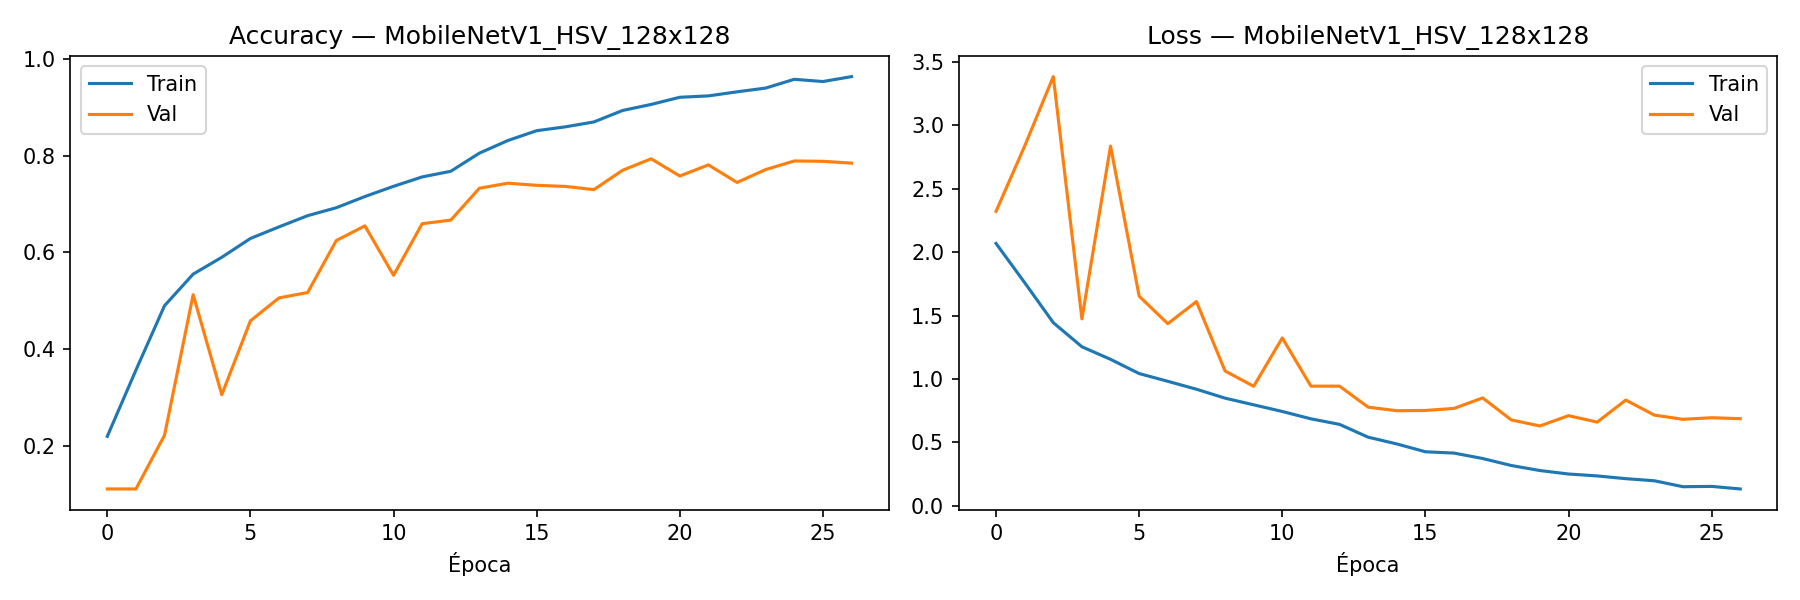
CNN/results/hsv/training_MobileNetV1_HSV_128x128.png
