angel-obando-17/CNN-accelerator-on-SoC/CNN/results/hsv/training_MobileNetV2_HSV_96x96.png

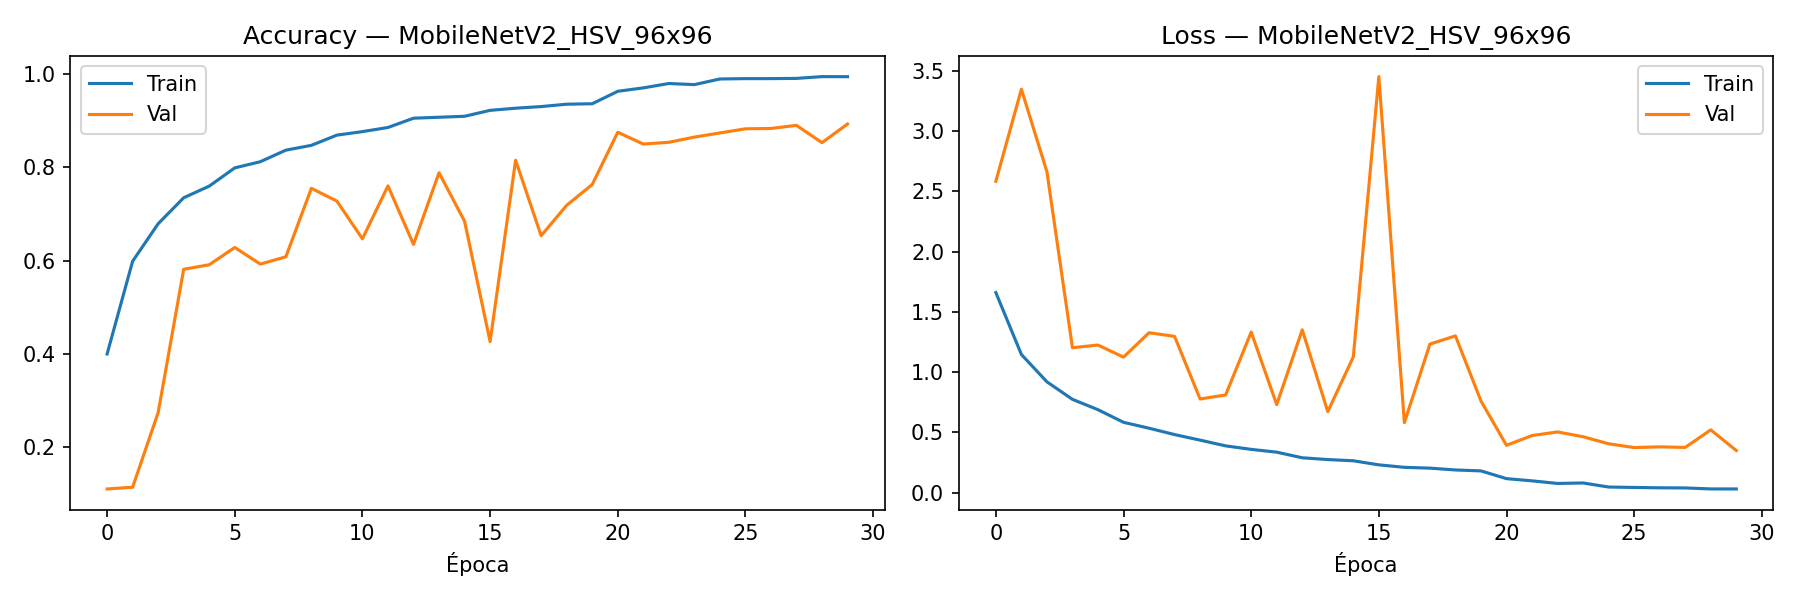
CNN/results/hsv/training_MobileNetV2_HSV_96x96.png
