angel-obando-17/CNN-accelerator-on-SoC/CNN/results/qat/training_MobileNetV2_QAT_256x256.png

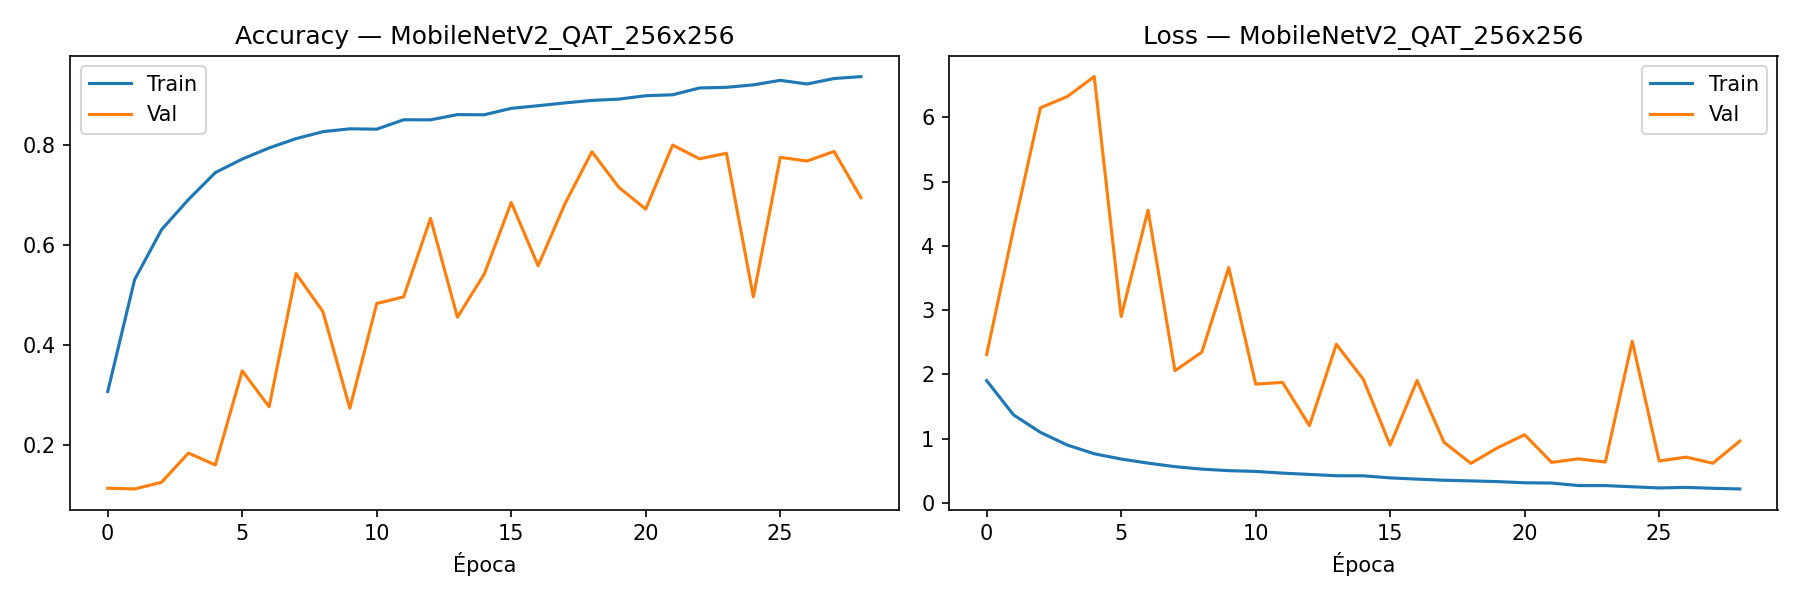
CNN/results/qat/training_MobileNetV2_QAT_256x256.png
