angel-obando-17/CNN-accelerator-on-SoC/Bitacora.md

# BITACORA [ TRABAJO DE GRADO ]
---

En este archivo se busca llevar un registro del proceso que se tendra para realizar el trabajo de grado de forma que todo quede evidenciado, todos los requerimientos y lo que se llevara a cabo sera anotado en esta bitacora.

---

## CONTEXTO Y LIMITACIONES

### BOARD SELECCIONADA

La board con la cual se trabajara a lo largo de este proceso, sera la *Puzhi 7020 Starlite Kit de evaluación Xilinx Zynq-7000 SoC XC7Z020 Placa de desarrollo FPGA ZYNQ 7000*, dicha placa se escogio principalmente por su costo, teniendo en cuenta que el proposito es trabajar con pequeños y medianos agricultores, no muchos cuentan con los recursos para adquirir hardware de mas capacidad, pero tambien se escogio ya que tiene un minimo de recursos para poder llevar a cabo la tarea principal que es la inferencia de redes neuronales convolucionales.

### ESPECIFICACIONES DE LA BOARD

* SoC Zynq 7020:
    + Arm Cortex-A9 MPCore de dos núcleos.
    + L1 Cache 32KB para Instrucciones, 32KB para Datos ( Por nucleo ).
    + L2 Cache 512KB.
    + Hasta 866 MHz.
    + 85k Celdas Logicas.
    + 4,9 Mb de BRAM.
    + 220 particiones de DSP.
    + 200 pines de E/S Maximos.
    + 53,2k LUTs.
    + 106,4k Flip-Flops.
* 512 MB de RAM DDR3.
* 64Kbit EEPROM.
* JTAG Downloader.
* SD Card Slot.
* MIPI CSI connector.
* $1$ $\times$ UART.
* $2$ $\times$ $40$ Pin Connector.

La placa tiene un precio de \$432.010 mas \$102.344,36 de envio en AliExpress que fue donde se adquirio.

### MODELOS DE CNN ESCOGIDA

Como se menciono en las especificaciones de la board escogida, esta cuenta con recursos muy limitados dada las necesidades de los agricultores, teniendo en cuenta el hardware, entonces tambien se debe limitar los modelos CNN que se pueden montar en la board para que esta realice su tarea de inferencia de forma satisfactoria. Despues de un proceso de evaluacion y comparacion de multiples modelos de CNN (LeNet, MobileNetV1, MobileNetV2, EfficientNet) entrenados bajo las mismas condiciones con el dataset PlantVillage segmentado, se decidio trabajar con el modelo **MobileNetV2**, en la resolucion de **$256$ $\times$ $256$** y con cuantizacion **INT8**, esto por las siguientes razones:

* MobileNetV2 obtuvo un accuracy de $94.14\%$ en INT8 con segmentacion HSV, superando a MobileNetV1 ($89.18\%$) en las mismas condiciones.
* La perdida de accuracy al cuantizar de float32 a INT8 es minima ($0.07\%$), lo que valida que el modelo es robusto ante la cuantizacion.
* Las operaciones adicionales que introduce MobileNetV2 respecto a V1 (residual connections y ReLU6) son implementables en hardware sin mayor complejidad.
* La resolucion de $256$ $\times$ $256$ fue la que mayor accuracy produjo en todas las evaluaciones, y es la resolucion nativa del dataset PlantVillage.

### LIMITACIONES DEL ACELERADOR

Dado que la placa tiene recursos muy limitados se necesita que la CNNs que se monten en el acelerador cumplan una serie de requisitos para que puedan ser ejecutadas de forma satisfactoria en la placa, algunas de estas fueron escogidas como diria el profe Carlos, por el criterio de Ingeniero, otras tienen una razon de ser, dichas limitaciones seran anumeradas a continuacion.

* Limitaciones a nivel de CNN ( Capas soportadas ):
    + Conv $3$ $\times$ $3$.
    + Pointwise $1$ $\times$ $1$.
    + Depthwise $3$ $\times$ $3$.
    + ReLU6 ( ReLU con clamp en 6, reemplaza al ReLU simple para soportar MobileNetV2 ).
    + Add elemento a elemento ( residual connections de MobileNetV2 ).
    + Pool Layer $2$ $\times$ $2$ ( opcional dependiendo de la capa ).
    + Global Average Pool ( opcional dependiendo de la capa ).
* Numero maximo de canales:
    + $C_{in} \leq 64$.
    + $C_{out} \leq 64$.
    + Los canales de expansion interna de los bloques invertidos de MobileNetV2 pueden superar 64 de forma transitoria, sin embargo los canales de entrada y salida de cada bloque siempre respetan el limite impuesto.
* Resolucion de entrada: $256$ $\times$ $256$ con 3 canales RGB. El procesamiento se realiza mediante tiling espacial para acomodar los feature maps en BRAM.
* Precision numerica de INT8, para los acumuladores INT32 y pesos cuantizados offline.
* Limitaciones a nivel de PL:
    + Un solo motor de convolucion, que sera reutilizado en el tiempo, dicho motor sera configurable por registros, y tendra modos Conv $3$ $\times$ $3$, Conv $1$ $\times$ $1$ y Depthwise $3$ $\times$ $3$.
    + Paralelismo usando solo 16 MACs en paralelo, donde cada MAC procesara un filtro de cada capa, dado que se usa Dpethwise entonces realmente es un MAC para cada canal.
    + BRAM solo para line buffers, Ventana $3$ $\times$ $3$, ping-pong buffers pequeños.
    + DDR como almacenamiento principal usandose para activaciones grandes y pesos por capa.
    + Usar una camara MIPI para la captura de imagenes.
* Pre-procesamiento:
    + Re-size a $256$ $\times$ $256$.
    + Segmentacion HSV threshold ( ejecutada en Core 1 del PS, antes de pasar la imagen al acelerador ).
    + RGB.
    + Normalizacion simple.
    + Todo en INT8.
* Dataflow:
    Cuando se habla del datafow en una CNN, estamos hablando sobre como es el flujo de datos ( input data, weights y partial sums ) atravez del hardware sobre el cual esta corriendo, buscando que haya la mayor optimizacion posible entre la memoria y los elementos de procesamiento, normalmente se tienen los tipos weight stationary, output stationary, input stationary y row stationary.
    + Weight Stationary: 
    Carga los pesos en los elementos de procesamiento (PEs por sus siglas en ingles), guardandolos ahi, esto minimizando el costo de energia de leer pesos desde la memoria.
    + Output Stationary:
    Se centra en acumular sumas parciales dentro de los PE, lo que reduce la necesidad de leer/escribir frecuentemente sumas parciales en el buffer global.
    + Input Stationary:
    Mantiene las input activations estacionarias en los PE para maximizar la reutilización.
    + Row Stationary:
    Optimiza la eficiencia energética al maximizar la reutilización de ambas filas de datos de entrada y de filtro, a menudo considerados altamente eficientes.

    Para este proyecto, se considero que la opcion mas pertinente es usar Output Stationary, esto debido a que la parte mas costosa del computa en una CNN es hacer la convolucion, por lo que es muy pertinente mantener los acumuladores en los PEs, de esta forma reduciendo la necesidad de escribir/leer del buffer global, evitando accesos a memoria de forma recurrente para almacenar los resultados de las sumas parciales.
* Estrategia de Memoria:
    Como se mostrara mas adelante en la macro-arquitectura del sistema, se pretende guardar weights y feature maps en la memoria RAM DDR3, pero eso implica que se cada vez que se desea procesar una nueva imagen se debe cargar completamente desde la RAM hacia el acelerador, y despues los mapas de caracteristicas resultantes vueltos a guardar en memoria, esto hace que el sistema gaste muchos ciclos escribiendo/leyendo de la memoria, generando un cuello de botella, donde el rendimiendo deja de ser el computo que se debe a realizar a nada mas que escrituras y lecturas de memorias recurrentes, para solucionar este problema se propone lo siguiente:
    + LineBuffer en BRAM:
    Es tecnica es muy utilizada en porcesamiento de imagenes en FPGAs, es una estructura de memoria que utiliza los Block RAM del FPGA, diseñada para almacenar una o mas lineas horizontales de datos de video o imagenes, actuando como un puente entre los datos de entrada y los algoritmos de procesamiento paralelo, la idea de usar esta estrategia es que idealmente se pueden tener 3 LineBuffers a nivel interno, esto porque para convoluciones $3$ $\times$ $3$, se necesitan procesar los 3 pixeles de la linea actual, los 3 superiores y los 3 inferiores, de esta forma podemos ahorrarnos la necesidad de almacenar frames completos en memoria, e ir procesandolos sin tantas lecturas de memoria.
    + Tiling Espacial:
    El tiling espacial ( o teselado ) es una estrategia muy utilizada en graficos por computadora para dividir datos espaciales extensos en bloques rectangulares mas pequeños y manejables. Esto permite cargar, visualizar y procesar mapas complejos de forma rapiday eficiente. La idea de utilizar tiling espacial es no procesaro todas las imagenes de golpe, sino procesar por bloques de filas, de esta forma reducimos la carga en el buffer interno y podemos mantener un pipeline mucho mas estable. 

### Justificación de las limitaciones

Cada una de las limitaciones antes enumeradas que se le imponen al acelerador responden a restricciones reales del hardware seleccionado, así como a criterios de eficiencia y reutilizacion. Estas decisiones van a permitir implementar una arquitectura genérica, capaz de acelerar múltiples CNNs ligeras, maximizando el aprovechamiento de los recursos del SoC.

Explicando un poco mas el porque se decidio escoger el modelo MobileNetV1, se debe mencionar como funciona una CNN a nivel interno, donde una CNN esta compuesta por una capa de entrada, una de salida y un conjunto de capas ocultas entre ambas, cada capa se caracteriza por tener un numero definido de filtros o kernels, donde estos filtros/kernels realizan lo que es llamada una conovolucion, al terminar se genera lo que se llama un mapa de caracteristicas, el cual resalta la presencia de caracteristicas especiales de la imagen, adicional este mapa de caracteristicas sirve como entrada para la siguiente capa de la CNN, escencialmente las CNN estan compuestas de muchas otras capas, no solo convolucionales, las cuales cumplen otras funciones ademas de la deteccion de caracteristicas, algunas de estas capas son:

* Pooling Layer:
Escencialmente siempre se pone una capa de pooling despues de una capa convolucional, ya antes descrita, esto porque se busca reducir la dimensionalidad de el mapa de caracteristicas obtenido en la capa convolucional anterior, pero reteniendo la informacion mas relevante, en una CNN esto es reducir el numero de pixeles usado para representar la imagen. La forma mas tipica de una capa de pooling es la llamada Max Pooling, la cual consiste en mantener el valor maximo dentro de una ventana determinada, es decir el tamaño del kernel, mientras descarta otros valores, tambien existen otras tecnicas como average pooling, la cual no toma el valor maximo dentro de la ventana, sino que toma un promedio de entre todos los valores de la ventana.

* Fully Connected Layer:
Esta capa tiene gran relevancia en las etapas finales de la CNN, donde es la responsable de clasificar imagenes basadas en las caracteristicas in las capas previas, el termino "fully connected" significa que cada neurona en una capa esta conectada a cada neurona de la siguiente capa.

La capa fully connected integra las diversas características extraídas en las capas convolucionales y de pooling anteriores y las asigna a clases o resultados específicos. Cada entrada de la capa anterior se conecta a cada unidad de activación en la capa fully connected, lo que permite que la CNN considere simultáneamente todas las características al tomar una decisión de clasificación final.

No todas las capas de una CNN están completamente conectadas. Debido a que las capas fully connected tienen muchos parámetros, aplicar este enfoque en toda la red crea una densidad innecesaria, aumenta el riesgo de sobreajuste y hace que la red sea costosa de entrenar en términos de memoria y computación. Limitar el número de capas fully connected equilibra la eficiencia computacional y la capacidad de generalización con la capacidad de aprender patrones complejos.

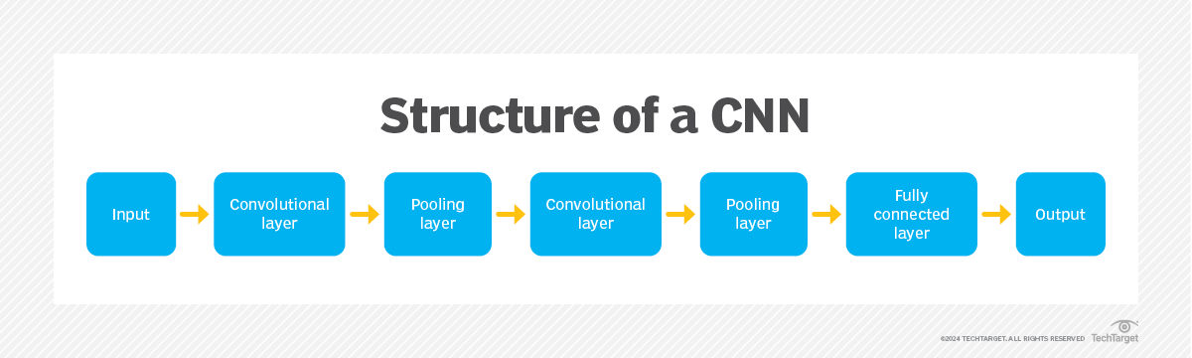
[picture p54: images/structure_of_a_cnn.png]
Structure of a CNN


Despues de entender un poco como esta compuesta una CNN tradicional, las cuales pueden incluir otras capas ademas de las mencionadas dependiendo del modelo, la idea es explicar entonces porque se decidio trabajar con el modelo MobileNetV2. 

Al igual que MobileNetV1, MobileNetV2 se basa en Depthwise Separable Convolutions, lo que reduce significativamente la cantidad de operaciones respecto a una convolucion tradicional. Sin embargo, MobileNetV2 introduce dos mejoras clave sobre V1:

La primera mejora es el **bloque invertido** (Inverted Residual Block), que expande los canales de entrada antes de aplicar la Depthwise Convolution y luego los proyecta de vuelta a un numero menor de canales con una Pointwise Convolution. Esta expansion transitoria de canales permite que la Depthwise Convolution opere en un espacio de mayor dimension, capturando mas caracteristicas, sin que los canales de entrada y salida del bloque superen el limite de 64 impuesto por el acelerador.

La segunda mejora es la **residual connection**, que suma la entrada del bloque directamente a su salida cuando las dimensiones coinciden. Esta conexion ayuda al gradiente a fluir mejor durante el entrenamiento y permite que el modelo aprenda correcciones sobre la identidad en lugar de transformaciones completas, lo que generalmente mejora el accuracy especialmente cuando se trabaja con resoluciones o datasets limitados.

Estas dos mejoras explican por que MobileNetV2 logro un accuracy de $94.14\%$ en INT8 frente a $89.18\%$ de MobileNetV1 bajo exactamente las mismas condiciones de entrenamiento y evaluacion.

### Processing System

* ARM-Cortex-A9 (Dual-Core)

    + Ejecuta la aplicacion principal.
    + Maneja la logica de alto nivel.
    + Toma desiciones ( inferencia, clasificacion, estados ).

    Nos interesa aprovechar los dos nucleos del chip, ya que de esta forma podemos asignar dichas tareas de forma equivalente para que la carga no sea de una sola unidad. En el SoC Zynq-7020, el Core 0 arranca primero por hardware y actua como maestro del sistema, mientras que el Core 1 permanece dormido hasta que el Core 0 lo despierta mediante un mecanismo de señalizacion usando la OCM (On-Chip Memory de 256KB). De esta forma:

    + Core 0: maestro del sistema ( arranca primero, orquesta todo el flujo ).
    + Core 1: esclavo ( duerme en spinlock, despierta cuando Core 0 lo señala ).

* Runtime Bare-Metal (Control & Concurrency)

    + Coordina tareas entre nucleos via OCM.
    + Ligero para no depender de un OS completo.
    + Control determinista del hardware.
    + Comunicacion inter-core: Core 0 escribe flag en OCM, Core 1 lee flag en spinlock.
    + La imagen segmentada se pasa de Core 1 a Core 0 a traves de OCM ( $256 \times 256 \times 3 = 192$ KB, cabe en los 256 KB disponibles ).

    De esta forma las tareas se podrian repartir de la siguiente manera:
    
    + Core 0:
        - Arranca el sistema.
        - Configura la camara MIPI.
        - Despierta a Core 1 cuando hay un frame disponible en DDR.
        - Espera señal de Core 1 indicando segmentacion lista.
        - Scheduler de la CNN: configura parametros por capa, lanza DMA, lanza acelerador.
        - Maneja interrupciones del acelerador.
        - Lee resultado final y toma decision de clasificacion.
    + Core 1:
        - Duerme en spinlock esperando señal de Core 0.
        - Al despertar: lee frame de DDR, aplica segmentacion HSV threshold.
        - Escribe imagen segmentada en OCM.
        - Señala a Core 0 que la segmentacion esta lista.
        - Vuelve a dormir.

* Drivers AXI / DMA

    + Abstraccion del hardware.
    + Escritura / Lectura de los registros AXI-Lite.
    + Configuracion de transferencia DMA.

    Este bloque realmente viene a ser como el puente entre PS y PL.

---
### Interconexion AXI

* AXI-Lite (Control)

    + Configurar el acelerador CNN.
    + Seleccionar tipo de capa.
    + Direcciones base.
    + Dimensiones.
    + Flags start / done.

* AXI-Hp (High Performance)

    + Activaciones.
    + Pesos.
    + Feature maps.
    + Transferencias grandes.

---
### Programmable Logic

* MIPI CSI RX

    + Captura continua de imagenes.
    + Conversion a stream interno.

* Pre-processsing

    + Resize de la imagen capturada a $256$ $\times$ $256$.
    + Normalizacion simple ( division por 255, conversion a INT8 ).
    + Reordenamiento de datos al formato esperado por el acelerador.
    + Nota: la segmentacion HSV se realiza en el Core 1 del PS antes de que la imagen llegue a este bloque, por lo que el Pre-processing en PL recibe una imagen ya segmentada.

* CNN Accelerator

    + Conv $3$ $\times$ $3$ normal.
    + Depthwise $3$ $\times$ $3$.
    + Pointwise $1$ $\times$ $1$.
    + ReLU6 ( activacion con clamp ).
    + Add elemento a elemento ( residual connections ).
    + Pooling / GAP.
    + Motor unico reutilizado por capa, configurable por registros AXI-Lite.

* DMA Engine

    + Mover datos entre DDR <-> PL.
    + Sin intervencion del CPU.
    + Maximo throughput.

---
### DDR3 (512MB)

* Frames de camara.
* Feature maps intermedios.
* Pesos por capa.

Como se ha venido mencionando, el SoC Zynq-7020 cuenta con un procesador ARM Cortex-A9 de dos núcleos, debido a esto se opto por implementar un runtime bare-metal ligero que permitiera la ejecución paralela de tareas críticas sin la sobrecarga de un sistema operativo completo.

Esta decisión permite separar responsabilidades entre nucleos, reducir la latencia en la comunicación con la lógica programable, lo cual es bastante relevante en aplicaciones de inferencia en tiempo real.

## MACRO - ARQUITECTURA

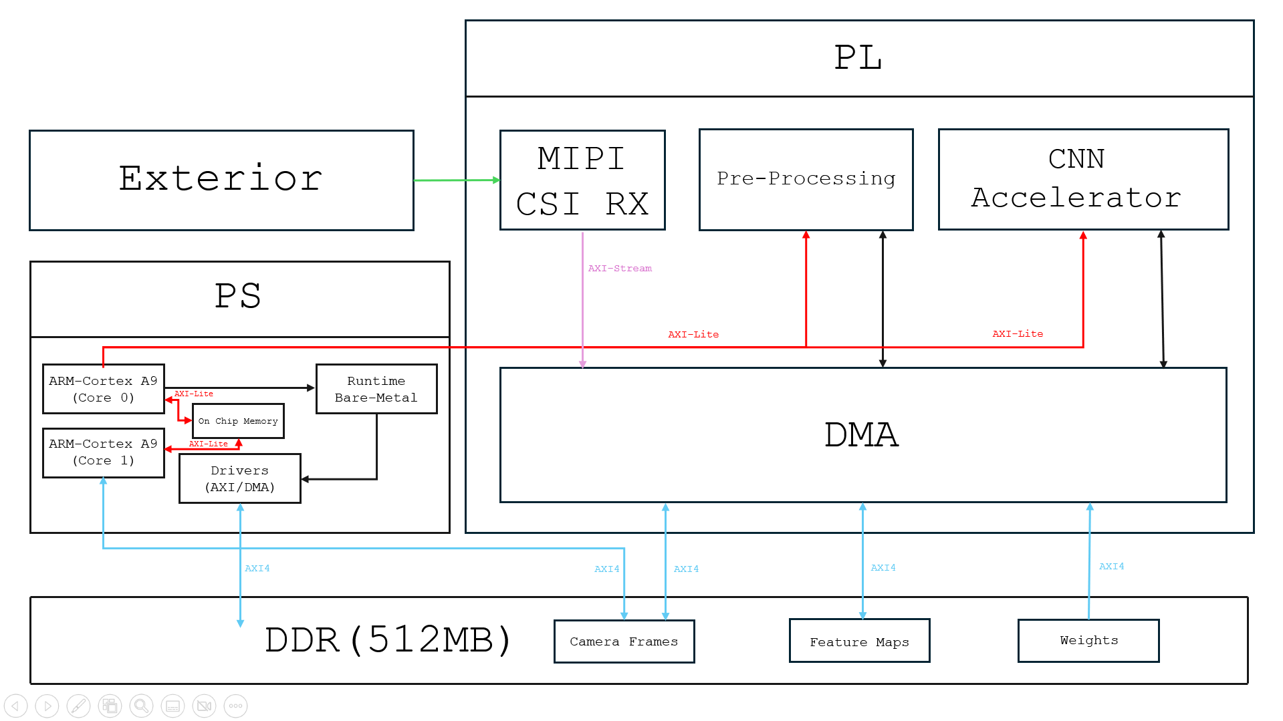
[picture p55: images/Macro_Arquitectura.png]


```mermaid

flowchart TB
    subgraph PS["Processing System (PS)"]
        ARM["ARM Cortex-A9"]
        RT["Runtime Bare-Metal"]
        INT["Interrupt Handler"]
        DMA_DRV["DMA Driver"]
        CNN_DRV["CNN Driver (AXI-Lite)"]
        MEM["DDR Memory Manager"]

        ARM --> RT
        RT --> DMA_DRV
        RT --> CNN_DRV
        RT --> MEM
        DMA_DRV --> INT
    end
```

```mermaid

flowchart TB
    subgraph PRE["Pre-processing (PL)"]
        IN_BUF["Input Buffer (BRAM)"]
        NORM["Normalization Unit"]
        RESHAPE["Data Formatter / Reshape"]
        OUT_BUF["Output Buffer (BRAM)"]
        CTRL["Control FSM"]

        IN_BUF --> NORM
        NORM --> RESHAPE
        RESHAPE --> OUT_BUF
        CTRL --> NORM
        CTRL --> RESHAPE
    end
```

En la macro-arquitectura podemos apreciar como se van a distribuir las tareas entre los distintos componentes del SoC, donde tenemos todo lo que hara el Processing System (PS), la Programmable Logic (PL), la Interconexion AXI, y la memoria DDR3.

## ARQUITECTURA INTERNA DEL CNN ACCELERATOR

Structure of a CNN

La maquina de estados que controla todo es la siguiente:

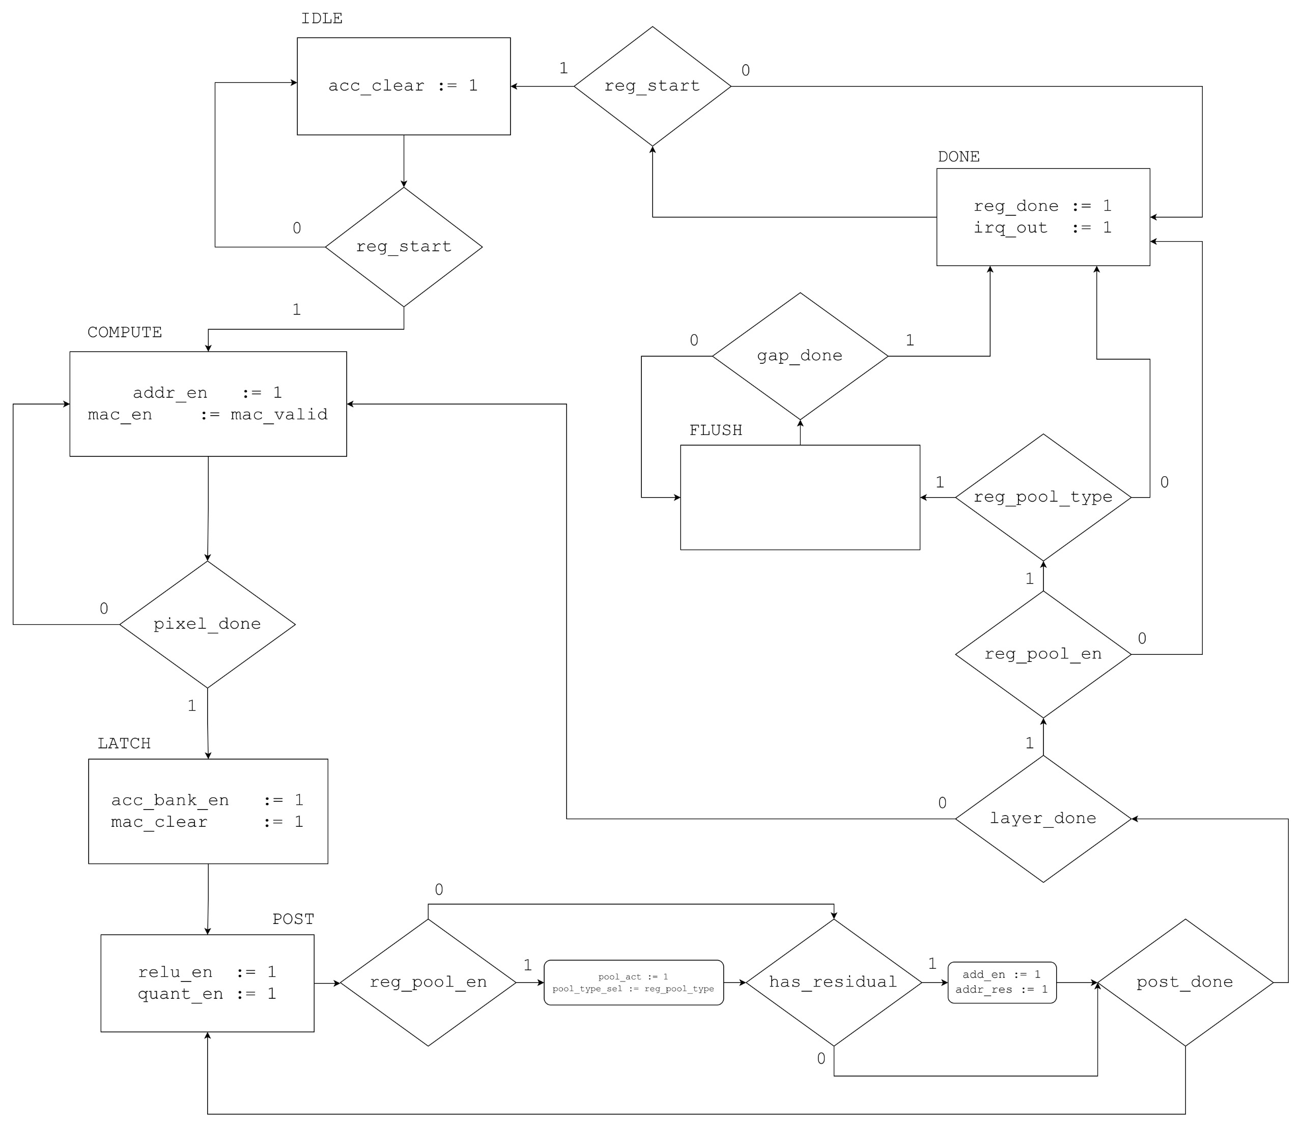
[picture p56: images/asm_cnn_accelerator.png]


Como se explico anteriormente, el acelerador soportara 4 modos de operacion: Conv normal $3$ $\times$ $3$, DepthWise $3$ $\times$ $3$, PointWise $1$ $\times$ $1$, y ADD (suma elemento a elemento para las residual connections de MobileNetV2). La FSM del acelerador genera las señales de control correspondientes segun el modo activo en cada momento.

* Que posicion $(x, y)$ de los feature maps estoy procesando.
* Que canal es el que estoy leyendo.
* Que filtro estoy usando.
* Donde guardo el resultado.

Despues de esto esta el bloque [Input Feature Buffer], es simplemente un bloque que guarda Feature Maps de entrada de la capa actual, este bloque solo obedece lo que el [Address Generator] le diga, de forma que el [Addrees Generator] pide el dato en la direccion X, y el [Input Feature Buffer] lo entrega.

```mermaid
flowchart TB

    subgraph CONTROL
        FSM["Control FSM"]
        MODE["Mode Register"]
    end

    subgraph COUNTERS
        X["x_counter"]
        Y["y_counter"]
        CI["ci_counter"]
        CO["co_counter"]
        TILE["tile_counter"]
    end

    subgraph ADDRESS_LOGIC
        CALC_IN["Input Address Calc"]
        CALC_W["Weight Address Calc"]
        CALC_OUT["Output Address Calc"]
    end

    subgraph OUTPUTS
        ADDR_IN["addr_input"]
        ADDR_W["addr_weight"]
        ADDR_OUT["addr_output"]
    end

    %% Control signals
    FSM --> X
    FSM --> Y
    FSM --> CI
    FSM --> CO
    FSM --> TILE

    FSM --> MODE

    %% Counters to address logic
    X --> CALC_IN
    Y --> CALC_IN
    CI --> CALC_IN
    TILE --> CALC_IN

    CI --> CALC_W
    CO --> CALC_W
    MODE --> CALC_W

    X --> CALC_OUT
    Y --> CALC_OUT
    CO --> CALC_OUT
    TILE --> CALC_OUT

    MODE --> CALC_IN
    MODE --> CALC_OUT

    %% Address outputs
    CALC_IN --> ADDR_IN
    CALC_W --> ADDR_W
    CALC_OUT --> ADDR_OUT
```

Para las convoluciones $3$ $\times$ $3$, es decir conv normales y DepthWise, entonces esta el [Line Buffer], este recibe los datos que el [Address Generator] le pidio al [Input Buffer], este entrega los datos pedidos y [Line Buffer] los organiza en filas para asi evitar leer recurrentemente de la memoria.

Despues tenemos el bloque de [Window Generator] el cual recibe las filas que armo el [Line Buffer] y lo entrega como una ventana de $3$ $\times$ $3$, es decir, el [Line Buffer] unicamente guardar las filas, pero para que los MACs puedan entender con que pixel trabajaran, entonces necesitan la ventana exacta con la cual trabajaran, de esto se encargar el [Window Generator].

Esto que se explico es para los modos $3$ $\times$ $3$, para el caso de las conv $1$ $\times$ $1$ no necesitamos ventanas, unicamente necesitamos los pesos de un pixel $(x, y)$ en cada feature map que esta entrando en la capa, entonces lo que sucedera es que el [Address Generator] fijara el pixel $(x, y)$ al cual se esta haciendo convolucion en este momento, y entregara todas las activaciones de cada feature map en ese pixel y esos valores pasan directos al MAC, por eso el [Input Buffer] que es quien tiene todas las activaciones de los feature maps esta conectado directamente al mux.

Hablando del Mux, este bloque [Input Mux] es simplemente un multiplexor que dejara pasar las ventas que genero el [Window Generator] o las activaciones que vienen directo del [Input Buffer], dependiendo del modo de convolucion que se este operando, sera la FSM quien generara la señal que escoge a quien debe dejar pasar.

Siguiendo tenemos el [Weight Buffer] que es simplemente parte de la BRAM donde se guardaron los pesos de cada kernel, aqui es importante el [Address Generator] ya que es quien le dice al [Weight Buffer]:
* Que peso debe entrar al MAC.
* De que filtro es ese peso.
* A que canal corresponde hacer convolucion ese peso del filtro.

Tenemos el [MAC Array] el cual es un arreglo de 16 MACS que trabajaran en paralelo dependiendo del modo en el cual este el acelerador en ese momento, cada MAC realiza la operacion de convolucion de un kernel con su respectivo canal en caso de DepthWise $3$ $\times$ $3$, de esta forma estamos usando un MAC por canal, o haciendo paralelismo sobre canales, para este caso cada MAC debera realizar $3$ $\times$ $3$ $\times$ $1$ multiplicaciones, sumar el resultado de esas multiplicaciones y guardarlas en su respectivo acumulador que esta en el bloque de [Accumulator Bank]. En caso de conv $3$ $\times$ $3$ normal, entonces los MACs se usan de forma que hacemos paralelismo sobre $C_{out}$, es decir como en convoluciones normales, los filtros se aplican sobre todos los canales de entrada entonces podemos hacer que cada MAC haga las operaciones correspondientes para cada filtro, en este caso los filtros/kernels no son realmente $3$ $\times$ $3$, sino mas bien $3$ $\times$ $3$ $\times$ $C_{in}$, ya que el kernel debe tener profundidad igual al numero de canales de entrada, por lo tanto no tiene solo $9$ pesos sino $3$ $\times$ $3$ $\times$ $C_{in}$, por lo que para este modo, cada MAC tambien debe realizar $3$ $\times$ $3$ $\times$ $C_{in}$ multiplicaciones, luego como ya se explico, sumar el resultado de estas multiplicaciones y guardarlas en sus respectivo acumulador del [Accumulator Bank], escencialmente se propone tener tantos acumuladores como MACs en el array, ya que asi cada MAC tiene un acumulador siempre disponible para su uso.

En el [Accumulator Bank] como ya se explico, simplemente se guarda el resultado de cada una de las convoluciones hechas previamente por cada uno de los MACs.

[ReLU], [Quant] y [Pool] son simplemente bloque de post-procesamiento, [ReLU] es la funcion de activacion, [Quant] se encarga de cuantizar el valor final en INT8 y [Pool] es un bloque opcional dependiendo de la capa, el cual se encarga de reducir la dimensionalidad del feature map obtenido.

[Output Buffer] es nuevamente parte de BRAM donde se guarda el feature map ya procesado, el [Address Generator] se encarga de decirle en que direccion debe guardar el Feature Map.

Una vez entendidos todos los bloques, el flujo para una convolucion $3$ $\times$ $3$ es el siguiente:

```mermaid
flowchart LR

    DDR["DDR Memory<br>Feature Maps"]
    DMA["AXI DMA"]
    IN_BUF["Input Feature Buffer (BRAM)"]
    LINE["Line Buffer"]
    WIN["Window Generator"]
    MAC["MAC Array"]
    ACC["Accumulator Bank"]
    OUT_BUF["Output Buffer (BRAM)"]
    DDR2["DDR Memory<br>Output Feature Maps"]

    DDR --> DMA
    DMA --> IN_BUF
    IN_BUF --> LINE
    LINE --> WIN
    WIN --> MAC
    MAC --> ACC
    ACC --> OUT_BUF
    OUT_BUF --> DMA
    DMA --> DDR2
```

```mermaid
flowchart LR
    DDR_IN["DDR3\nFeature Maps (entrada)"]
    DMA_IN["DMA\n(DDR → BRAM)"]
    IN_BUF["Input Feature Buffer\n(BRAM)"]
    LINE["Line Buffer\n(3x3 mode)"]
    WIN["Window Generator\n(3x3 mode)"]
    MUX["Input MUX\n(Spatial / Direct)"]
    W_BUF["Weight Buffer\n(BRAM)"]
    MAC["MAC Array\n(16 PEs)"]
    ACC["Accumulator Bank\n(16 x INT32)"]
    RELU["ReLU"]
    QUANT["Quantizer\n(INT8)"]
    POOL["Pooling / GAP\n(Opcional)"]
    OUT_BUF["Output Buffer\n(BRAM)"]
    DMA_OUT["DMA\n(BRAM → DDR)"]
    DDR_OUT["DDR3\nFeature Maps (salida)"]

    DDR_IN --> DMA_IN --> IN_BUF
    IN_BUF --> LINE --> WIN --> MUX
    IN_BUF --> MUX
    W_BUF --> MAC
    MUX --> MAC --> ACC --> RELU --> QUANT --> POOL --> OUT_BUF
    OUT_BUF --> DMA_OUT --> DDR_OUT
```

Para el caso de conv 1×1, el flujo simplificado es:

```mermaid
flowchart LR

    IN_BUF["Input Feature Buffer (BRAM)"]
    PIXEL["Pixel (x,y) - todos Cin"]
    MAC["MAC Array (Paralelismo sobre Cout)"]
    ACC["Accumulator"]
    OUT_BUF["Output Buffer"]

    IN_BUF --> PIXEL
    PIXEL --> MAC
    MAC --> ACC
    ACC --> OUT_BUF
```

```mermaid
flowchart TB

    subgraph FASE1["Fase 1: Depthwise 3x3"]
        DDR_IN["DDR3 Feature Maps (entrada)"]
        DMA_IN["DMA (DDR → BRAM)"]
        IN_BUF["Input Feature Buffer (BRAM)"]
        LINE["Line Buffer"]
        WIN["Window Generator"]
        MUX1["Input MUX (Spatial)"]
        W_DW["Weight Buffer DW (BRAM)"]
        MAC1["MAC Array (16 PEs) - Paralelismo sobre Cin"]
        ACC1["Accumulator Bank"]
        RELU1["ReLU"]
        QUANT1["Quantizer (INT8)"]
        OUT_BUF["Output Buffer (BRAM) ← resultado DW por tile"]

        DDR_IN --> DMA_IN --> IN_BUF
        IN_BUF --> LINE --> WIN --> MUX1
        W_DW --> MAC1
        MUX1 --> MAC1 --> ACC1 --> RELU1 --> QUANT1 --> OUT_BUF
    end

    subgraph FSM_CTRL["FSM Control"]
        NOTE["Tile DW completo → FSM cambia modo a PW → Redirige lectura: OUT_BUF actúa como IN_BUF Sin DMA, sin DDR"]
    end

    subgraph FASE2["Fase 2: Pointwise 1x1"]
        MUX2["Input MUX (Direct - 1x1)"]
        W_PW["Weight Buffer PW (BRAM) (recargado por DMA)"]
        MAC2["MAC Array (16 PEs) - Paralelismo sobre Cout"]
        ACC2["Accumulator Bank"]
        RELU2["ReLU"]
        QUANT2["Quantizer (INT8)"]
        POOL2["Pooling / GAP (Opcional)"]
        OUT_BUF2["Output Buffer (BRAM) ← resultado PW"]
        DMA_OUT["DMA (BRAM → DDR)"]
        DDR_OUT["DDR3\nFeature Maps (salida)"]

        MUX2 --> MAC2 --> ACC2 --> RELU2 --> QUANT2 --> POOL2 --> OUT_BUF2
        W_PW --> MAC2
        OUT_BUF2 --> DMA_OUT --> DDR_OUT
    end

    OUT_BUF -->|"Lectura directa (puntero FSM)"| MUX2
    FASE1 --> FSM_CTRL --> FASE2
```

## ESTRATEGIA DE MEMORIA

```mermaid

flowchart TB
    subgraph DMA["DMA Engine (PL)"]
        AXI_M["AXI Master Interface (AXI-HP)"]
        CTRL["DMA Control FSM"]
        RD["Read Engine"]
        WR["Write Engine"]
        BUF["Internal BRAM Buffer"]
        IRQ["Interrupt Generator"]

        AXI_M --> RD
        AXI_M --> WR
        RD --> BUF
        BUF --> WR
        CTRL --> RD
        CTRL --> WR
        CTRL --> IRQ
    end
```

Una vez comprendido que realizara cada bloque en la seccion anterior entonces se debe explicar la estrategia de carga y gestion de pesos, como se mostro inicialmente, los pesos de cada capa estaran originalmente almacenados en la DDR por lo que debemos traerlos a BRAM para poder trabajar con ellos sin leer de forma recurrente en memoria, para esto, antes de iniciar el procesamiento de una capa:

* El procesador configura la transferencia de los pesos mediante el DMA.
* Los pesos correspondientes a la capa se cargan al [Weight Buffer].

Dado por la limitaciones que se impusieron que $C_{in}, C_{out} \leq$ $64$, el peor caso para una etapa PointWise donde las convoluciones son $1$ $\times$ $1$ es:

$64$ $\times$ $64$ $=$ $4096$ pesos, que al estar cuantizados en INT8, eso nos da aproximadamente $4$ KB, lo cual es compatible con la capacidad disponible de BRAM en el SoC.

Para capas con $C_{out}$ $>$ $16$, los pesos se cargan en bloques de 16 filtros por iteración, reduciendo el requerimiento de almacenamiento simultáneo.

Tambien para aclarar lo que se menciono antes en las estrategias de memoria sobre el tiling espacial y la generacion de direcciones, tenemos que tener en cuenta la limitacion de BRAM, por lo que el proesamiento se realiza por tiles espaciales y/o por bloques de canales.

Para esto el [Address Generator] es responsable de:

* Generar direcciones de lectura de activaciones.
* Generar direcciones de lectura de pesos.
* Generar direcciones de escritura de feature maps de salida.
* Gestionar contadores de:
    + Coordenadas espaciales $(x, y)$.
    + Canal de entrada $C_i$.
    + Canal de salida $C_o$.
    + Indice del tile.

El procesamiento por tiles permite:
* Reducir la cantidad de datos simultaneamente almacenados en BRAM.
* Mantener alta reutilización local.
* Disminuir transferencias frecuentes a DDR.

El tamaño del tile se define en función de la capacidad disponible de BRAM.

```mermaid
flowchart TB

    IMG["Feature Map Completo"]

    subgraph TILE1["Tile"]
        LB1["Line Buffer"]
        MAC1["MAC Array"]
    end

    subgraph TILE2["Siguiente Tile"]
        LB2["Line Buffer"]
        MAC2["MAC Array"]
    end

    IMG --> TILE1
    TILE1 --> TILE2
```

```mermaid

flowchart LR
    subgraph DDR["DDR3 Memory Map"]
        FB["Frame Buffer"]
        FM_A["Feature Map A"]
        FM_B["Feature Map B (Ping-Pong)"]
        W["CNN Weights"]
        OUT["Final Output"]
    end
```

Dado que la BRAM es el recurso más crítico del diseño, es necesario verificar que la suma de todos los buffers internos del acelerador no exceda la capacidad disponible del SoC. Con la resolucion de entrada de $256$ $\times$ $256$ y MobileNetV2, el feature map mas grande que debe procesarse es el de la primera capa Conv $3$ $\times$ $3$ con stride $2$, que produce una salida de $128$ $\times$ $128$ $\times$ $32$. El procesamiento por tiles se ajusta a este feature map, usando tiles de $128$ $\times$ $8$ para la primera capa y ajustando segun la capa. A continuacion se presenta el consumo estimado de BRAM para el peor caso, es decir, con $C_{in}$ $=$ $C_{out}$ $=$ $64$ y tiles de $128$ $\times$ $8$:

| Buffer | Cálculo | Tamaño estimado |
|---|---|---|
| LineBuffers (3 líneas × 128 píxeles × 64 canales × 1B) | $3 \times 128 \times 64$ | ~24 KB |
| Input Feature Buffer (tile 128×8×64) | $128 \times 8 \times 64$ | ~64 KB |
| Weight Buffer (peor caso Pointwise 64×64) | $64 \times 64$ | ~4 KB |
| Output Buffer (tile 128×8×64, reutilizado DW→PW) | $128 \times 8 \times 64$ | ~64 KB |
| Residual Buffer (tile 128×8×64, para ADD de MobileNetV2) | $128 \times 8 \times 64$ | ~64 KB |
| Window Buffer (ventana 3×3 × 64 canales) | $9 \times 64$ | < 1 KB |
| **Total** | | **~220 KB** |

La Zynq-7020 dispone de 4.9 Mb de BRAM eso es aproximadamente $612.5 KB$, por lo que el consumo estimado representa aproximadamente el $35.9 \%$ del total disponible. Este margen amplio valida las decisiones de diseño tomadas y deja espacio suficiente para los buffers internos del DMA Engine y el bloque de Pre-processing.

Vale la pena resaltar dos optimizaciones importantes:

* El [Output Buffer] cumple una doble funcion: almacena el resultado del Depthwise y actua como [Input Buffer] del Pointwise en el flujo fusionado DW→PW. Esto elimina la necesidad de un buffer intermedio dedicado.
* El [Residual Buffer] solo se activa cuando la FSM esta en modo ADD, es decir unicamente en los bloques de MobileNetV2 donde stride=1 y $C_{in} = C_{out}$. En los demas modos este buffer no se usa, por lo que su espacio puede ser compartido con otros propositos segun convenga.

## PIPELINE DE FRAMES

Una vez que se ha visto como sera la macro-arquitectura, entonces podemos avanzar algo mas y ver el flujo del pipeline de datos:

```mermaid

flowchart LR

    CAP["1. Captura MIPI"]
    DDRF["2. Frame en DDR"]
    SEG["3. Segmentacion HSV<br/>(Core 1 - PS)"]
    OCM["4. Imagen segmentada<br/>en OCM"]
    PRE["5. Pre-processing (PL)<br/>Resize + Norm + INT8"]
    FM0["6. Feature Map Inicial"]
    SCH["7. Scheduler (Core 0 - PS)"]
    DMA_IN["8. DMA: DDR -> PL"]
    CNN["9. CNN Accelerator (PL)"]
    DMA_OUT["10. DMA: PL -> DDR"]
    NEXT["11. Siguiente Capa"]
    RES["12. Resultado Final"]

    CAP --> DDRF
    DDRF --> SEG
    SEG --> OCM
    OCM --> PRE
    PRE --> FM0
    FM0 --> SCH
    SCH --> DMA_IN
    DMA_IN --> CNN
    CNN --> DMA_OUT
    DMA_OUT --> NEXT
    NEXT --> SCH
    SCH --> RES
```
En este diagrama podemos observar:

* Frame adquirido por la camara MIPI que se escribe en DDR.
* Core 1 lee el frame de DDR, aplica la segmentacion HSV threshold, y escribe la imagen segmentada en OCM.
* Core 0 recibe la señal de Core 1 y toma la imagen segmentada de OCM para pasarla al bloque de Pre-processing en PL.
* El bloque de Pre-processing en PL aplica resize, normalizacion y conversion a INT8.
* Se reutiliza el mismo motor de convolución por cada capa.
* Los resultados intermedios se van guardando en DDR.
* Core 0 actua como scheduler, decidiendo que operacion ejecutar en cada momento.

```C
for( layer = 0; layer < num_layers; layer++ ) {
    configure_parameters( layer );   /** modo, dimensiones, direcciones DDR. **/
    load_weights_DMA( layer );       /** DDR -> Weight Buffer BRAM. **/
    launch_DMA_input( layer );       /** DDR -> Input Feature Buffer BRAM. **/
    launch_accelerator( );           /** Inicia computo. **7
    wait_interruption( );            /** Espera IRQ del acelerador **/
    if( layer_has_residual( layer ) ) {
        launch_add_unit( layer );    /** Suma residual IN_BUF + OUT_BUF. **/
        wait_interruption( );
    }
    launch_DMA_output( layer );      /** Output Buffer BRAM -> DDR. **/
    wait_interruption( );
}
```

* Core 0 no procesa datos, solo orquesta.
* DDR actua como almacenamiento intermedio entre capas.
* Hay separacion clara entre control, transferencia y computo.

```mermaid

flowchart LR

    CFG["PS Configura Capa"]
    WLOAD["Cargar Pesos (DDR -> BRAM)"]
    DIN["DMA: Activaciones -> Buffer"]
    COMP["Convolución / Depthwise / 1x1"]
    ACT["ReLU"]
    POOL["Pooling / GAP"]
    DOUT["DMA: Resultado -> DDR"]
    IRQ["Interrupción -> PS"]

    CFG --> WLOAD
    WLOAD --> DIN
    DIN --> COMP
    COMP --> ACT
    ACT --> POOL
    POOL --> DOUT
    DOUT --> IRQ
```
En este diagrama podemos ver como es el pipeline interno por cada capa.

* El PS no procesa datos.
* DDR actúa como almacenamiento intermedio.
* Hay separación clara entre:
    + Control.
    + Transferencia.
    + Computación.

```mermaid

flowchart TB

    subgraph Tiempo

    T1["PS Configura DMA"]
    T2["DMA Transfiere Datos"]
    T3["CNN Procesa"]
    T4["DMA Escribe Resultado"]
    T5["PS Lanza Siguiente Capa"]

    T1 --> T2 --> T3 --> T4 --> T5

    end
```

## Estimacion Teorica del Modelo

Para una capa conovolucional normal de $3$ $\times$ $3$:

Las multiplicaciones totales que se deben hacer son:

$H \times W \times C_{in} \times C_{out} \times 9$.

Donde:
$H:$ Altura del Feature Map.
$W:$ Ancho del Feature Map.
$C_{in}:$ Canales de entrada.
$C_{out}:$ Canales de salida.
Con 16 PEs operando en paralelo entonces tenemos un estimado de ciclos igual a $(H \times W \times C_{in} \times C_{out} \times 9) / 16$

Para una capa $1$ $\times$ $1$:

Las multiplicaciones totals que se deben hacer son:
$H \times W \times C_{in} \times C_{out}$

Con 16 PEs operando en paralelo entonces tenemos un estimado de ciclos igual a $(H \times W \times C_{in} \times C_{out}) / 16$

Estas estimaciones no consideran latencias de memoria ni sobrecarga de control, pero permiten obtener una cota inferior del tiempo de ejecución.

Para una capa DepthWise $3$ $\times$ $3$:

Las multiplicaciones totales que se deben hacer son:

$H \times W \times C_{in} \times 9$

Con 16 PEs operando en paralelo entonces tenemos un estimado de ciclos igual a $(H \times W \times C_{in} \times 9) / 16$

Para la operacion ADD (residual connection):

La operacion ADD simplemente suma elemento a elemento el tensor de entrada con el tensor de salida del bloque. No hay multiplicaciones, solo sumas:

$H \times W \times C$

Con 16 sumadores en paralelo: $(H \times W \times C) / 16$ ciclos. Es la operacion mas rapida del pipeline.

## SEGMENTACIÓN HSV — IMPLEMENTACIÓN EN BARE-METAL

La segmentacion HSV threshold es el metodo escogido para separar la hoja del fondo antes de que la imagen entre al acelerador CNN. Este metodo fue seleccionado porque:

* Es implementable directamente en C bare-metal sin librerias externas.
* Solo usa comparaciones de rangos enteros, sin estructuras de grafos ni redes neuronales.
* Produce resultados consistentes con lo que el modelo aprendio durante el entrenamiento.
* Es ejecutable en el Core 1 del PS mientras Core 0 se prepara para lanzar el acelerador.

### Algoritmo HSV Threshold

```C
/** Pseudocodigo del algoritmo de segmentacion HSV en C bare-metal. **/
/** Entrada: Imagen BGR 256x256 en DDR. **/
/** Salida:  Imagen segmentada en OCM. **/

void segment_hsv( uint8_t* img_bgr, uint8_t* img_out, int width, int height ) {
    for( int i = 0; i < width * height; i++ ) {
        uint8_t b = img_bgr[ 3 * i ];
        uint8_t g = img_bgr[ 3 * i + 1 ];
        uint8_t r = img_bgr[ 3 * i + 2 ];

        /** Conversion RGB -> HSV ( aritmetica entera ). **/
        uint8_t h, s, v;
        rgb_to_hsv_int( r, g, b, &h, &s, &v );

        /** Threshold: verde/verde-amarillo O marron/naranja ( lesiones ). **/
        int mask_green = ( h >= 15 && h <= 95 && s >= 30 && v >= 20 );
        int mask_brown = ( h >=  5 && h <= 20 && s >= 50 && v >= 20 && v <= 220 );
        int fg = mask_green || mask_brown;

        /** Aplicar mascara: fondo = negro. **/
        img_out[ 3 * i ]     = fg ? b : 0;
        img_out[ 3 * i + 1 ] = fg ? g : 0;
        img_out[ 3 * i + 2 ] = fg ? r : 0;
    }
    /** Post-procesamiento morfologico: CLOSE + OPEN ( kernel 7x7 ). **/ 
    morphology_close_open(img_out, width, height);
}
```

### Parametros de los rangos HSV

Los rangos utilizados en el threshold fueron validados empiricamente durante los experimentos de entrenamiento:

| Region | H min | H max | S min | S max | V min | V max |
|---|---|---|---|---|---|---|
| Verde / hoja sana | 15 | 95 | 30 | 255 | 20 | 255 |
| Marron / lesiones | 5 | 20 | 50 | 255 | 20 | 220 |

Nota: los rangos HSV en OpenCV usan H=[0,179], S=[0,255], V=[0,255]. La implementacion en bare-metal usara la misma escala para mantener consistencia con el entrenamiento.

## ADDRESS-GENERATOR

El [ Address Generator ] es el bloque mas complejo del acelerador en terminos de logica, ya que es quien controla exactamente que dato se lee, de donde, y donde se escribe el resultado en cada ciclo. Sin embargo, su complejidad se reduce drasticamente si dejamos que la "inteligencia" la asuma el Core 0 del PS, que es quien conoce de antemano las dimensiones exactas de cada capa de MobileNetV2, y se las comunica al [ Address Generator ] antes de lanzar cada capa mediante registros de configuracion accesibles mediante AXI-Lite.

Esto significa que el [ Address Generator ] es esencialmente un conjunto de contadores que cuentan hasta los valores que el PS escribio en sus registros. No hay logica de deteccion de dimensiones, no hay inferencia dinamica. El Core 0 del PS es quien asume todas esas tareas, el hardware solo ejecuta.

### Registros de configuracion AXI-Lite

Antes de lanzar cada capa, Core 0 escribe los siguientes registros mediante AXI-Lite:

| Offset | Nombre | Bits | Descripcion |
|---|---|---|---|
| 0x00 | REG_START | 1 | Escribir 1 lanza el acelerador. Se limpia automaticamente al terminar. |
| 0x04 | REG_MODE | 2 | Modo de operacion: 00=Conv3x3, 01=DW3x3, 10=PW1x1 |
| 0x08 | REG_H | 9 | Altura del feature map de entrada ( max 256 ) |
| 0x0C | REG_W | 9 | Ancho del feature map de entrada ( max 256 ) |
| 0x10 | REG_CIN | 7 | Canales de entrada ( max 64, pero expansion interna V2 puede ser mayor ) |
| 0x14 | REG_COUT | 7 | Canales de salida ( max 64 ) |
| 0x18 | REG_STRIDE | 2 | Stride de la convolucion: 1 o 2 |
| 0x1C | REG_TILE_W | 8 | Ancho del tile activo ( normalmente 128, menos en el ultimo tile ) |
| 0x20 | REG_LAST_TILE_W | 8 | Ancho del ultimo tile si W no es multiplo de 128 ( W mod 128 ) |
| 0x24 | REG_HAS_RESIDUAL | 1 | 1 si este bloque tiene residual connection ( ADD despues de PW ) |
| 0x28 | REG_ADDR_IN | 32 | Direccion base en DDR del feature map de entrada |
| 0x2C | REG_ADDR_W | 32 | Direccion base en DDR de los pesos de esta capa |
| 0x30 | REG_ADDR_OUT | 32 | Direccion base en DDR donde se escribira el feature map de salida |
| 0x34 | REG_ADDR_RES | 32 | Direccion base en DDR del tensor de entrada para la residual ( mismo que ADDR_IN cuando aplica ) |
| 0x38 | REG_DONE | 1 | Solo lectura. El acelerador escribe 1 aqui al terminar ( genera IRQ ) |
| 0x3C | REG_POOL_EN | 1 | 1 si se debe aplicar MaxPool 2x2 o GAP al finalizar esta capa |

### Formulas de direccion

Para el modo Conv $3 \times 3$ y DepthWise:

$addr\_input = base\_in + (tile\_y \times 8 + row) \times W \times C_{in} + tile\_x \times TILE\_W \times C_{in} + c_i$

$addr\_weight = base\_w + c_o \times C_{in} \times 9 + c_i \times 9 + k_y \times 3 + k_x$

$addr\_output = base\_out + (tile\_y \times 8 + row) \times W_{out} \times C_{out} + tile\_x \times TILE\_W \times C_{out} + c_o$

Donde $W_{out} = W / stride$.

Para el modo PointWise $1 \times 1$:

$addr\_input = base\_in + (tile\_y \times 8 + row) \times W \times C_{in} + tile\_x \times TILE\_W \times C_{in} + c_i$

$addr\_weight = base\_w + c_o \times C_{in} + c_i$

$addr\_output = base\_out + (tile\_y \times 8 + row) \times W \times C_{out} + tile\_x \times TILE\_W \times C_{out} + c_o$

Para el modo ADD (residual):

$addr\_a = base\_out$ (resultado del PW, ya en BRAM)

$addr\_b = base\_res$ (entrada del bloque, guardada en DDR)

El resultado se escribe de vuelta en $base\_out$.

### Tiles parciales en los bordes

Cuando $W$ no es multiplo de $128$, el ultimo tile de cada fila tiene ancho $W \bmod 128$. El PS calcula este valor y lo escribe en REG_LAST_TILE_W. El [ Address Generator ] usa un flag interno `is_last_tile_x` para seleccionar entre TILE_W y LAST_TILE_W como limite del contador de columnas. Esto no requiere logica adicional, solo un multiplexor controlado por ese flag.

Lo mismo aplica verticalmente: cuando $H$ no es multiplo de $8$, el ultimo tile de filas tiene altura $H \bmod 8$, manejado con un registro REG_LAST_TILE_H si se considera necesario, o simplemente con padding a cero en el Input Feature Buffer.

### Tabla de parametros por capa de MobileNetV2 (256x256, 9 clases)

Esta tabla es la que Core 0 tiene almacenada en DDR y consulta para configurar el acelerador antes de cada capa:

| Capa | Modo | H_in | W_in | Cin | Cout | Stride | Residual |
|---|---|---|---|---|---|---|---|
| Conv1 | Conv3x3 | 256 | 256 | 3 | 32 | 2 | No |
| IRB1 - EXP | PW1x1 | 128 | 128 | 32 | 32 | 1 | No |
| IRB1 - DW | DW3x3 | 128 | 128 | 32 | 32 | 1 | No |
| IRB1 - PW | PW1x1 | 128 | 128 | 32 | 16 | 1 | No |
| IRB2 - EXP | PW1x1 | 128 | 128 | 16 | 32 | 1 | No |
| IRB2 - DW | DW3x3 | 128 | 128 | 32 | 32 | 2 | No |
| IRB2 - PW | PW1x1 | 64 | 64 | 32 | 24 | 1 | No |
| IRB3 - EXP | PW1x1 | 64 | 64 | 24 | 48 | 1 | No |
| IRB3 - DW | DW3x3 | 64 | 64 | 48 | 48 | 1 | No |
| IRB3 - PW | PW1x1 | 64 | 64 | 48 | 24 | 1 | **Si** |
| IRB4 - EXP | PW1x1 | 64 | 64 | 24 | 48 | 1 | No |
| IRB4 - DW | DW3x3 | 64 | 64 | 48 | 48 | 2 | No |
| IRB4 - PW | PW1x1 | 32 | 32 | 48 | 32 | 1 | No |
| IRB5 - EXP | PW1x1 | 32 | 32 | 32 | 64 | 1 | No |
| IRB5 - DW | DW3x3 | 32 | 32 | 64 | 64 | 1 | No |
| IRB5 - PW | PW1x1 | 32 | 32 | 64 | 32 | 1 | **Si** |
| IRB6 - EXP | PW1x1 | 32 | 32 | 32 | 64 | 1 | No |
| IRB6 - DW | DW3x3 | 32 | 32 | 64 | 64 | 2 | No |
| IRB6 - PW | PW1x1 | 16 | 16 | 64 | 64 | 1 | No |
| IRB7 - EXP | PW1x1 | 16 | 16 | 64 | 64 | 1 | No |
| IRB7 - DW | DW3x3 | 16 | 16 | 64 | 64 | 1 | No |
| IRB7 - PW | PW1x1 | 16 | 16 | 64 | 64 | 1 | **Si** |
| IRB8 - EXP | PW1x1 | 16 | 16 | 64 | 64 | 1 | No |
| IRB8 - DW | DW3x3 | 16 | 16 | 64 | 64 | 1 | No |
| IRB8 - PW | PW1x1 | 16 | 16 | 64 | 64 | 1 | **Si** |
| IRB9 - EXP | PW1x1 | 16 | 16 | 64 | 64 | 1 | No |
| IRB9 - DW | DW3x3 | 16 | 16 | 64 | 64 | 1 | No |
| IRB9 - PW | PW1x1 | 16 | 16 | 64 | 64 | 1 | **Si** |
| conv_last | PW1x1 | 16 | 16 | 64 | 64 | 1 | No |
| GAP | GAP | 16 | 16 | 64 | 64 | 1 | No |
| Dense | FC | 1 | 1 | 64 | 9 | 1 | No |

Nota: los canales de expansion interna (columna EXP en los bloques IRB) pueden superar 64 en los bloques donde $C_{in} \times expand\_ratio > 64$. En esos casos el acelerador procesa esos canales en bloques de 64, iterando. El PS configura el numero de iteraciones necesarias en un registro adicional REG_CIN_ITERS si se considera necesario, o alternativamente se limita el expand_ratio para que los canales internos no superen 64 en ningun bloque, lo cual fue la decision tomada en el entrenamiento con MAX_CH=64.
