angel-obando-17/CNN-accelerator-on-SoC/accelerator/tb/accelerator/tb_cnn_top_stride.vhd

library ieee;
use ieee.std_logic_1164.all;
use ieee.numeric_std.all;

-- Testbench de integracion para el soporte de stride real ( ver
-- accelerator/cnn_accelerator/docs/stride_support_gap.md, Parte 4, y los
-- 4 puntos de implementacion: registros / wiring / addr_generator.vhd /
-- generalizacion de pool_en en ddr_addr_gen.vhd+dma_fsm.vhd ). Mismo
-- patron que tb_cnn_top.vhd / tb_cnn_top_bias.vhd / tb_cnn_top_hardcore.vhd
-- ( acelerador + DMA reales contra DDR falsa bidireccional ), pero con una
-- red mas densa/pesada: mas capas encadenadas con datos REALES propagados,
-- 2 tiles horizontales con stride, y una capa de regresion explicita con
-- stride_en=0 para confirmar que nada de lo ya verificado se rompio.
--
--   CASO A: Conv3x3 + stride_en=1, tile de salida 2x2, UN solo tile.
--           Activacion VARIA por FILA de imagen (no uniforme) -- elegido
--           a proposito para que el resultado distinga la ventana correcta
--           ( TF SAME, row = 2*y_counter + sig_ky + 1 ) de la simetrica
--           vieja ( row = 2*y_counter + sig_ky ) y de una formula que
--           "olvide" escalar por stride. Con activacion uniforme coincidirian
--           por casualidad en este tile tan chico -- ver el analisis mas abajo.
--   CASO B: DW3x3 + stride_en=1, mismo tile 2x2, misma idea pero variando
--           por COLUMNA en vez de por fila -- cubre la mitad del calculo
--           ( col = 2*x_counter + sig_kx + 1 ) que el Caso A no ejercita, y de
--           paso confirma que DW3x3 (addr_w por canal, no tocado en este
--           cambio) sigue funcionando bien combinado con stride.
--   CASO C: Conv3x3 + stride_en=1, DOS tiles horizontales ( TILE_WAIT ).
--           Ejercita el supuesto de diseno central de la Opcion 2 ( ver
--           "Hallazgo clave 1" en stride_support_gap.md ): el tile que pide
--           el DMA ( DMA_TILE_W = doble del tile de salida, con halo ) y el
--           tile que itera el acelerador ( MAX_X/MAX_Y, tamano de salida )
--           son registros independientes. Confirma ademas que tile0 lee su
--           halo DERECHO como pixel real de tile1 (no cero, a diferencia
--           del pad del borde verdadero de la imagen) y que el OFM de
--           ambos tiles queda escrito CONTIGUO en la imagen de salida
--           ( sin hueco ni superposicion ) -- eso es lo que confirma que
--           tile_w_out (mitad de tile_w, generalizacion de pool_en) quedo
--           bien generalizado en ddr_addr_gen.vhd.
--   CASO D: cadena real de 2 capas ( Conv3x3 stride=2 -> DW3x3 stride=1 ),
--           igual patron que MobileNetV2 real ( ej. conv1 -> primera capa
--           del siguiente bloque ): la Capa 2 consume la salida REAL
--           ( ya a mitad de resolucion ) de la Capa 1, no datos por
--           defecto. Confirma que una capa con stride puede alimentar
--           directamente a una capa SIN stride, sin ningun paso intermedio.
--   CASO E: regresion explicita. Mismo caso y misma matematica que el
--           CASO K de tb_cnn_top_hardcore.vhd ( PW1x1 + Residual, bias que
--           deja el valor cerca del techo + residual que fuerza saturacion
--           en add_unit ), reubicado a direcciones nuevas y con
--           stride_en=0 escrito EXPLICITAMENTE en los dos lados ( acelerador
--           y DMA ). El objetivo es confirmar que, con stride_en en 0, la
--           generalizacion "pool_en OR stride_en" y el nuevo `if` de
--           addr_generator.vhd no cambiaron en NADA el comportamiento ya
--           verificado -- mismo resultado exacto (satura a 0x7F) que antes
--           de tocar una sola linea de este cambio.
--   CASOS F-I: ver el comentario de cada uno mas abajo.
--   CASOS J-M ( agregados 2026-09-13, tras la primera corrida en placa, que
--           destapo 4 bugs de RTL que la suite no detectaba ):
--     J: Conv3x3 stride, 2 tiles VERTICALES -- el halo de ABAJO ( que con
--        la ventana TF SAME si se lee ) trae la fila real del tile siguiente.
--     K: Conv3x3 Cin=3 con un valor distinto por canal -- detecta byte_sel
--        adelantado un ciclo respecto al dato de la BRAM ( bug 2 ).
--     L: PW1x1 Cin=16 con canal c = c -- el mismo bug 2, en PW.
--     M: PW1x1 + residual, Cout=32, residual distinto por pixel y grupo --
--        detecta el residual leido con la direccion de la siguiente
--        iteracion ( bug 4 ).
--     ( El bug 3, el latch de sig_ky/sig_kx en addr_generator.vhd, no se ve
--       en simulacion: solo en el methodology DRC post-implementacion. )
--
-- NOTA IMPORTANTE: stride_en es un registro que persiste entre capas
-- ( no hay reset entre "run_layer_and_ack" ) -- por eso CADA caso escribe
-- stride_en explicitamente en los dos lados ( REG_STRIDE_EN offset 0x44 del
-- acelerador, DMA_STRIDE_EN offset 0x54 del DMA ), incluso cuando el valor
-- que necesita es el mismo que dejo el caso anterior. Nunca se asume el
-- valor por defecto de reset ni el valor que dejo el caso previo.
--
-- NOTA SOBRE EL HALO CON STRIDE: el DMA fetchea el halo SIMETRICO de
-- siempre ( una fila/columna arriba-izquierda y una abajo-derecha, ver
-- row_words_padded en ddr_addr_gen.vhd ). Con la ventana TF SAME
-- ( row = 2*y_counter + sig_ky + 1 ) la fila 0 y la columna 0 del
-- IFBuffer ( halo de arriba/izquierda ) nunca se leen, y el halo de
-- abajo/derecha si: en tiles interiores trae el dato real del tile vecino
-- ( Casos C y J ) y en el borde de la imagen, cero ( el pad de TF ). Hasta
-- el 2026-09-13 la ventana era la simetrica 2y-1..2y+1 y era al reves: el
-- halo de abajo/derecha era el que sobraba.
--
-- Direcciones: bloques de 0x4000 bytes por caso, mismo esquema que
-- tb_cnn_top_hardcore.vhd, a partir de 0x40000 (para no chocar con ningun
-- otro testbench). +0x0000=W, +0x1000=IN, +0x2000=OUT, +0x3000=RES,
-- +0x3800=BIAS. Todos los valores se calcularon para division EXACTA por
-- 2**shift (o directamente shift=0 cuando no hace falta).

entity tb_cnn_top_stride is
end tb_cnn_top_stride;

architecture Behavioral of tb_cnn_top_stride is

    constant CLK_PERIOD : time := 10 ns;

    signal clk   : std_logic := '0';
    signal reset : std_logic := '0'; -- Low Active.

    -- AXI-Lite #1 ( acelerador ).
    signal axi_awaddr  : std_logic_vector(  6 downto 0 ) := ( others => '0' );
    signal axi_awvalid : std_logic := '0';
    signal axi_awready : std_logic;
    signal axi_wdata   : std_logic_vector( 31 downto 0 ) := ( others => '0' );
    signal axi_wstrb   : std_logic_vector(  3 downto 0 ) := ( others => '1' );
    signal axi_wvalid  : std_logic := '0';
    signal axi_wready  : std_logic;
    signal axi_bresp   : std_logic_vector(  1 downto 0 );
    signal axi_bvalid  : std_logic;
    signal axi_bready  : std_logic := '0';
    signal axi_araddr  : std_logic_vector(  6 downto 0 ) := ( others => '0' );
    signal axi_arvalid : std_logic := '0';
    signal axi_arready : std_logic;
    signal axi_rdata   : std_logic_vector( 31 downto 0 );
    signal axi_rresp   : std_logic_vector(  1 downto 0 );
    signal axi_rvalid  : std_logic;
    signal axi_rready  : std_logic := '0';

    -- AXI-Lite #2 ( DMA ).
    signal s_axi_awaddr  : std_logic_vector(  6 downto 0 ) := ( others => '0' );
    signal s_axi_awvalid : std_logic := '0';
    signal s_axi_awready : std_logic;
    signal s_axi_wdata   : std_logic_vector( 31 downto 0 ) := ( others => '0' );
    signal s_axi_wstrb   : std_logic_vector(  3 downto 0 ) := ( others => '1' );
    signal s_axi_wvalid  : std_logic := '0';
    signal s_axi_wready  : std_logic;
    signal s_axi_bresp   : std_logic_vector(  1 downto 0 );
    signal s_axi_bvalid  : std_logic;
    signal s_axi_bready  : std_logic := '0';
    signal s_axi_araddr  : std_logic_vector(  6 downto 0 ) := ( others => '0' );
    signal s_axi_arvalid : std_logic := '0';
    signal s_axi_arready : std_logic;
    signal s_axi_rdata   : std_logic_vector( 31 downto 0 );
    signal s_axi_rresp   : std_logic_vector(  1 downto 0 );
    signal s_axi_rvalid  : std_logic;
    signal s_axi_rready  : std_logic := '0';

    -- AXI4 to DDR, Read.
    signal m_axi_r_arid    : std_logic_vector(  3 downto 0 );
    signal m_axi_r_araddr  : std_logic_vector( 31 downto 0 );
    signal m_axi_r_arlen   : std_logic_vector(  7 downto 0 );
    signal m_axi_r_arsize  : std_logic_vector(  2 downto 0 );
    signal m_axi_r_arburst : std_logic_vector(  1 downto 0 );
    signal m_axi_r_arvalid : std_logic;
    signal m_axi_r_arready : std_logic := '0';
    signal m_axi_r_rid     : std_logic_vector(  3 downto 0 ) := ( others => '0' );
    signal m_axi_r_rdata   : std_logic_vector( 63 downto 0 ) := ( others => '0' );
    signal m_axi_r_rresp   : std_logic_vector(  1 downto 0 ) := ( others => '0' );
    signal m_axi_r_rlast   : std_logic := '0';
    signal m_axi_r_rvalid  : std_logic := '0';
    signal m_axi_r_rready  : std_logic;

    -- AXI4 to DDR, Write.
    signal m_axi_w_awid    : std_logic_vector(  3 downto 0 );
    signal m_axi_w_awaddr  : std_logic_vector( 31 downto 0 );
    signal m_axi_w_awlen   : std_logic_vector(  7 downto 0 );
    signal m_axi_w_awsize  : std_logic_vector(  2 downto 0 );
    signal m_axi_w_awburst : std_logic_vector(  1 downto 0 );
    signal m_axi_w_awvalid : std_logic;
    signal m_axi_w_awready : std_logic := '0';
    signal m_axi_w_wdata   : std_logic_vector( 63 downto 0 );
    signal m_axi_w_wstrb   : std_logic_vector(  7 downto 0 );
    signal m_axi_w_wlast   : std_logic;
    signal m_axi_w_wvalid  : std_logic;
    signal m_axi_w_wready  : std_logic := '0';
    signal m_axi_w_bid     : std_logic_vector(  3 downto 0 ) := ( others => '0' );
    signal m_axi_w_bresp   : std_logic_vector(  1 downto 0 ) := ( others => '0' );
    signal m_axi_w_bvalid  : std_logic := '0';
    signal m_axi_w_bready  : std_logic;

    signal dma_done : std_logic;

    constant DDR_WORDS : integer := 65536;
    type ddr_mem_array is array( 0 to DDR_WORDS - 1 ) of std_logic_vector( 63 downto 0 );

    signal ddr_mem : ddr_mem_array := (
        -- CASO A ( Conv3x3 stride, activacion varia por FILA ). Imagen
        -- 4x4, Cin=16: imgrow0=imgrow1=2, imgrow2=imgrow3=6. Base IN
        -- word 33280 ( addr 0x41000 ), 8 words por fila ( 4 pixeles x
        -- 2 words/pixel ).
        33280 => x"0202020202020202", 33281 => x"0202020202020202",
        33282 => x"0202020202020202", 33283 => x"0202020202020202",
        33284 => x"0202020202020202", 33285 => x"0202020202020202",
        33286 => x"0202020202020202", 33287 => x"0202020202020202",
        33288 => x"0202020202020202", 33289 => x"0202020202020202",
        33290 => x"0202020202020202", 33291 => x"0202020202020202",
        33292 => x"0202020202020202", 33293 => x"0202020202020202",
        33294 => x"0202020202020202", 33295 => x"0202020202020202",
        33296 => x"0606060606060606", 33297 => x"0606060606060606",
        33298 => x"0606060606060606", 33299 => x"0606060606060606",
        33300 => x"0606060606060606", 33301 => x"0606060606060606",
        33302 => x"0606060606060606", 33303 => x"0606060606060606",
        33304 => x"0606060606060606", 33305 => x"0606060606060606",
        33306 => x"0606060606060606", 33307 => x"0606060606060606",
        33308 => x"0606060606060606", 33309 => x"0606060606060606",
        33310 => x"0606060606060606", 33311 => x"0606060606060606",
        -- CASO A, bias = 0 ( addr 0x43800, word 34560 ).
        34560 => x"0000000000000000", 34561 => x"0000000000000000",
        34562 => x"0000000000000000", 34563 => x"0000000000000000",
        34564 => x"0000000000000000", 34565 => x"0000000000000000",
        34566 => x"0000000000000000", 34567 => x"0000000000000000",

        -- CASO B ( DW3x3 stride, activacion varia por COLUMNA ). Imagen
        -- 4x4, 4 FILAS completas ( imgrow0..3 ), cada una: imgcol0=imgcol1=3,
        -- imgcol2=imgcol3=9. Base IN word 35328 ( addr 0x45000 ), 8 words
        -- por fila ( 4 pixeles x 2 words/pixel ), 32 words en total.
        35328 => x"0303030303030303", 35329 => x"0303030303030303",
        35330 => x"0303030303030303", 35331 => x"0303030303030303",
        35332 => x"0909090909090909", 35333 => x"0909090909090909",
        35334 => x"0909090909090909", 35335 => x"0909090909090909",
        35336 => x"0303030303030303", 35337 => x"0303030303030303",
        35338 => x"0303030303030303", 35339 => x"0303030303030303",
        35340 => x"0909090909090909", 35341 => x"0909090909090909",
        35342 => x"0909090909090909", 35343 => x"0909090909090909",
        35344 => x"0303030303030303", 35345 => x"0303030303030303",
        35346 => x"0303030303030303", 35347 => x"0303030303030303",
        35348 => x"0909090909090909", 35349 => x"0909090909090909",
        35350 => x"0909090909090909", 35351 => x"0909090909090909",
        35352 => x"0303030303030303", 35353 => x"0303030303030303",
        35354 => x"0303030303030303", 35355 => x"0303030303030303",
        35356 => x"0909090909090909", 35357 => x"0909090909090909",
        35358 => x"0909090909090909", 35359 => x"0909090909090909",
        -- CASO B, bias = 0 ( addr 0x47800, word 36608 ).
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
        -- word 46848 ).
        46848 => x"0000000000000000", 46849 => x"0000000000000000",
        46850 => x"0000000000000000", 46851 => x"0000000000000000",
        46852 => x"0000000000000000", 46853 => x"0000000000000000",
        46854 => x"0000000000000000", 46855 => x"0000000000000000",

        -- CASO G ( PW1x1, Cin=24, verificacion del fix de cin_groups en el
        -- LADO DE LECTURA -- 1 fila, 2 columnas ). Pixel0: canales 0-15 = 1,
        -- canales 16-23 = 2. Pixel1: canales 0-15 = 3, canales 16-23 = 4.
        -- Base IN word 47616 ( addr 0x5D000 ). Empaquetado RELLENO
        -- ( cin_groups*16 = 32 bytes por pixel -- ver row_stride_in
        -- := img_w*cin_groups*16 en ddr_addr_gen.vhd ): pixel0 ocupa
        -- bytes 0-31 ( 24 reales + 8 de relleno ), pixel1 bytes 32-63.
        47616 => x"0101010101010101", 47617 => x"0101010101010101",
        47618 => x"0202020202020202",
        47620 => x"0303030303030303", 47621 => x"0303030303030303",
        47622 => x"0404040404040404",
        -- CASO G, bias = 0 ( addr 0x5F800, word 48896 ).
        48896 => x"0000000000000000", 48897 => x"0000000000000000",
        48898 => x"0000000000000000", 48899 => x"0000000000000000",
        48900 => x"0000000000000000", 48901 => x"0000000000000000",
        48902 => x"0000000000000000", 48903 => x"0000000000000000",

        -- CASO H ( PW1x1, Cin=16 ( sin afectar ), Cout=24, verificacion del
        -- fix de cout_groups en el LADO DE ESCRITURA -- 2 filas, 1 columna ).
        -- fila0: activacion = 2 ( todos los canales ). fila1: activacion = 5.
        -- Base IN word 49664 ( addr 0x61000 ), 16 bytes ( 2 words de 64b )
        -- por fila ( 1 pixel x 16 canales, Cin=16 ya cabe en un solo grupo ).
        49664 => x"0202020202020202", 49665 => x"0202020202020202",
        49666 => x"0505050505050505", 49667 => x"0505050505050505",
        -- CASO H, bias = 0 ( addr 0x63800, word 50944 ). Con max_co=1
        -- ( 2 grupos de 16 canales ) el bias_buf se indexa por co_counter,
        -- asi que hacen falta los DOS grupos ( 8 words c/u ) igual que con
        -- weight_words -- si no, bias(1) queda sin inicializar y contamina
        -- con 'X' el grupo 2 (co_counter=1) de cada fila.
        50944 => x"0000000000000000", 50945 => x"0000000000000000",
        50946 => x"0000000000000000", 50947 => x"0000000000000000",
        50948 => x"0000000000000000", 50949 => x"0000000000000000",
        50950 => x"0000000000000000", 50951 => x"0000000000000000",
        50952 => x"0000000000000000", 50953 => x"0000000000000000",
        50954 => x"0000000000000000", 50955 => x"0000000000000000",
        50956 => x"0000000000000000", 50957 => x"0000000000000000",
        50958 => x"0000000000000000", 50959 => x"0000000000000000",

        -- CASO F2 ( Conv3x3, Cin=3, imagen de 4 COLUMNAS x 1 fila -- ver si
        -- el gap de empaquetado denso del Caso G TAMBIEN afecta a Conv3x3
        -- con Cin=3 real, no solo a PW1x1 con Cin=24 ). Activacion varia
        -- por columna: col0=col1=3, col2=col3=9 ( igual estilo que Caso B ).
        -- Empaquetado RELLENO: cin_groups*16 = 16 bytes/pixel ( 3 reales +
        -- 13 de relleno ). Base IN word 51200 ( addr 0x64000 ). Cada pixel
        -- arranca en una word par: pixel0 en 51200, pixel1 en 51202,
        -- pixel2 en 51204, pixel3 en 51206. Solo los bytes 0-2 de cada uno
        -- se leen ( Cin=3 ), el resto es relleno que nadie mira.
        51200 => x"0000000000030303", 51202 => x"0000000000030303",
        51204 => x"0000000000090909", 51206 => x"0000000000090909",
        -- CASO F2, bias = 0 ( addr 0x64800, word 51456 -- 0x64800/8. La
        -- version vieja decia 51328, que es 0x64400: el bias caia sobre el
        -- relleno por defecto 0x01010101 y el Caso F2 saturaba a 0x7F sin
        -- importar el datapath. Bug del testbench, no del RTL ).
        51456 => x"0000000000000000", 51457 => x"0000000000000000",
        51458 => x"0000000000000000", 51459 => x"0000000000000000",
        51460 => x"0000000000000000", 51461 => x"0000000000000000",
        51462 => x"0000000000000000", 51463 => x"0000000000000000",

        -- CASO H2 ( PW1x1, Cin=16, Cout=24, 1 fila x 2 COLUMNAS -- ver si
        -- el gap de empaquetado denso TAMBIEN afecta la escritura de OFM
        -- con columnas, no solo con filas como el Caso H ). col0=activ 2,
        -- col1=activ 5. Base IN word 52224 ( addr 0x66000 ).
        52224 => x"0202020202020202", 52225 => x"0202020202020202",
        52226 => x"0505050505050505", 52227 => x"0505050505050505",
        -- CASO H2, bias = 0 x2 grupos ( addr 0x69000, word 53760 ).
        53760 => x"0000000000000000", 53761 => x"0000000000000000",
        53762 => x"0000000000000000", 53763 => x"0000000000000000",
        53764 => x"0000000000000000", 53765 => x"0000000000000000",
        53766 => x"0000000000000000", 53767 => x"0000000000000000",
        53768 => x"0000000000000000", 53769 => x"0000000000000000",
        53770 => x"0000000000000000", 53771 => x"0000000000000000",
        53772 => x"0000000000000000", 53773 => x"0000000000000000",
        53774 => x"0000000000000000", 53775 => x"0000000000000000",

        -- CASO I ( relu_en=0, capa lineal ): bias = -40 en int32 ( 0xFFFFFFD8 )
        -- para los 16 canales ( base 0x6F800/8 = 57088, 4 palabras de 128 bits ).
        57088 => x"FFFFFFD8FFFFFFD8", 57089 => x"FFFFFFD8FFFFFFD8",
        57090 => x"FFFFFFD8FFFFFFD8", 57091 => x"FFFFFFD8FFFFFFD8",
        57092 => x"FFFFFFD8FFFFFFD8", 57093 => x"FFFFFFD8FFFFFFD8",
        57094 => x"FFFFFFD8FFFFFFD8", 57095 => x"FFFFFFD8FFFFFFD8",

        -- CASO J ( Conv3x3 stride, 2 tiles verticales ). Imagen 4x8, Cin=16,
        -- fila r = r+1 ( 1..8 ). Base IN word 57856 ( addr 0x71000 ), 8 words
        -- por fila. bias = 0 ( addr 0x73800, word 59136 ).
        57856 to 57863 => x"0101010101010101",
        57864 to 57871 => x"0202020202020202",
        57872 to 57879 => x"0303030303030303",
        57880 to 57887 => x"0404040404040404",
        57888 to 57895 => x"0505050505050505",
        57896 to 57903 => x"0606060606060606",
        57904 to 57911 => x"0707070707070707",
        57912 to 57919 => x"0808080808080808",
        59136 to 59143 => x"0000000000000000",

        -- CASO K ( Conv3x3, Cin=3, 2x2 ). Canal c = c+1 en los 4 pixeles
        -- ( 16 bytes/pixel, bytes 0-2 reales ). Base IN word 59904 ( addr
        -- 0x75000 ). bias = 0 ( addr 0x77800, word 61184 ).
        59904 => x"0000000000030201",
        59906 => x"0000000000030201",
        59908 => x"0000000000030201",
        59910 => x"0000000000030201",
        61184 to 61187 => x"0000000000000000",

        -- CASO L ( PW1x1, Cin=16, 2x2 ). Canal c = c en los 4 pixeles. Base IN
        -- word 61952 ( addr 0x79000 ). bias = 0 ( addr 0x7B800, word 63232 ).
        61952 => x"0706050403020100", 61953 => x"0F0E0D0C0B0A0908",
        61954 => x"0706050403020100", 61955 => x"0F0E0D0C0B0A0908",
        61956 => x"0706050403020100", 61957 => x"0F0E0D0C0B0A0908",
        61958 => x"0706050403020100", 61959 => x"0F0E0D0C0B0A0908",
        63232 to 63239 => x"0000000000000000",

        -- CASO M ( PW1x1 + residual, Cout=32, 2x2 ). Residual del pixel p,
        -- grupo g = 10p + 40g + 5. 32 bytes/pixel ( 2 grupos de 16 ). Base RES
        -- word 65024 ( addr 0x7F000 ). bias = 0 x 2 grupos ( addr 0x7F800,
        -- word 65280 ).
        65024 to 65025 => x"0505050505050505",
        65026 to 65027 => x"2D2D2D2D2D2D2D2D",
        65028 to 65029 => x"0F0F0F0F0F0F0F0F",
        65030 to 65031 => x"3737373737373737",
        65032 to 65033 => x"1919191919191919",
        65034 to 65035 => x"4141414141414141",
        65036 to 65037 => x"2323232323232323",
        65038 to 65039 => x"4B4B4B4B4B4B4B4B",
        65280 to 65295 => x"0000000000000000",

        others => x"0101010101010101" );

    type rd_state_type is ( RD_S_IDLE, RD_S_BURST );
    signal rd_slave_state : rd_state_type := RD_S_IDLE;

    type wr_state_type is ( WR_S_IDLE, WR_S_DATA, WR_S_RESP );
    signal wr_slave_state : wr_state_type := WR_S_IDLE;
    signal wr_word_idx    : integer := 0;

begin

    clk <= not clk after CLK_PERIOD / 2;

    dut : entity work.cnn_top
        port map(
            clk             => clk,
            reset           => reset,
            axi_awaddr     => axi_awaddr,
            axi_awvalid    => axi_awvalid,
            axi_awready    => axi_awready,
            axi_wdata      => axi_wdata,
            axi_wstrb      => axi_wstrb,
            axi_wvalid     => axi_wvalid,
            axi_wready     => axi_wready,
            axi_bresp      => axi_bresp,
            axi_bvalid     => axi_bvalid,
            axi_bready     => axi_bready,
            axi_araddr     => axi_araddr,
            axi_arvalid    => axi_arvalid,
            axi_arready    => axi_arready,
            axi_rdata      => axi_rdata,
            axi_rresp      => axi_rresp,
            axi_rvalid     => axi_rvalid,
            axi_rready     => axi_rready,
            s_axi_awaddr   => s_axi_awaddr,
            s_axi_awvalid  => s_axi_awvalid,
            s_axi_awready  => s_axi_awready,
            s_axi_wdata    => s_axi_wdata,
            s_axi_wstrb    => s_axi_wstrb,
            s_axi_wvalid   => s_axi_wvalid,
            s_axi_wready   => s_axi_wready,
            s_axi_bresp    => s_axi_bresp,
            s_axi_bvalid   => s_axi_bvalid,
            s_axi_bready   => s_axi_bready,
            s_axi_araddr   => s_axi_araddr,
            s_axi_arvalid  => s_axi_arvalid,
            s_axi_arready  => s_axi_arready,
            s_axi_rdata    => s_axi_rdata,
            s_axi_rresp    => s_axi_rresp,
            s_axi_rvalid   => s_axi_rvalid,
            s_axi_rready   => s_axi_rready,
            m_axi_r_arid    => m_axi_r_arid,
            m_axi_r_araddr  => m_axi_r_araddr,
            m_axi_r_arlen   => m_axi_r_arlen,
            m_axi_r_arsize  => m_axi_r_arsize,
            m_axi_r_arburst => m_axi_r_arburst,
            m_axi_r_arvalid => m_axi_r_arvalid,
            m_axi_r_arready => m_axi_r_arready,
            m_axi_r_rid     => m_axi_r_rid,
            m_axi_r_rdata   => m_axi_r_rdata,
            m_axi_r_rresp   => m_axi_r_rresp,
            m_axi_r_rlast   => m_axi_r_rlast,
            m_axi_r_rvalid  => m_axi_r_rvalid,
            m_axi_r_rready  => m_axi_r_rready,
            m_axi_w_awid    => m_axi_w_awid,
            m_axi_w_awaddr  => m_axi_w_awaddr,
            m_axi_w_awlen   => m_axi_w_awlen,
            m_axi_w_awsize  => m_axi_w_awsize,
            m_axi_w_awburst => m_axi_w_awburst,
            m_axi_w_awvalid => m_axi_w_awvalid,
            m_axi_w_awready => m_axi_w_awready,
            m_axi_w_wdata   => m_axi_w_wdata,
            m_axi_w_wstrb   => m_axi_w_wstrb,
            m_axi_w_wlast   => m_axi_w_wlast,
            m_axi_w_wvalid  => m_axi_w_wvalid,
            m_axi_w_wready  => m_axi_w_wready,
            m_axi_w_bid     => m_axi_w_bid,
            m_axi_w_bresp   => m_axi_w_bresp,
            m_axi_w_bvalid  => m_axi_w_bvalid,
            m_axi_w_bready  => m_axi_w_bready,
            dma_done        => dma_done
        );

    -- DDR, canal de lectura.
    process( clk )
        variable v_word_idx   : integer := 0;
        variable v_beats_left : integer := 0;
    begin
        if( rising_edge( clk ) ) then
            if( reset = '0' ) then
                m_axi_r_arready <= '0';
                m_axi_r_rvalid  <= '0';
                rd_slave_state  <= RD_S_IDLE;
                v_word_idx      := 0;
                v_beats_left    := 0;

            else
                case rd_slave_state is
                    when RD_S_IDLE =>
                        m_axi_r_arready <= '0';
                        m_axi_r_rvalid  <= '0';
                        if( m_axi_r_arvalid = '1' ) then
                            m_axi_r_arready <= '1';
                            v_word_idx      := to_integer( unsigned( m_axi_r_araddr ) ) / 8;
                            v_beats_left    := to_integer( unsigned( m_axi_r_arlen ) ) + 1;
                            rd_slave_state  <= RD_S_BURST;
                        end if;

                    when RD_S_BURST =>
                        m_axi_r_arready <= '0';

                        if( m_axi_r_rvalid = '0' ) then
                            m_axi_r_rvalid <= '1';
                            m_axi_r_rdata  <= ddr_mem( v_word_idx );
                            m_axi_r_rlast  <= '0' when v_beats_left /= 1 else '1';

                        elsif( m_axi_r_rready = '1' ) then
                            v_word_idx   := v_word_idx + 1;
                            v_beats_left := v_beats_left - 1;
                            if( v_beats_left = 0 ) then
                                m_axi_r_rvalid <= '0';
                                rd_slave_state <= RD_S_IDLE;
                            else
                                m_axi_r_rdata <= ddr_mem( v_word_idx );
                                m_axi_r_rlast <= '0' when v_beats_left /= 1 else '1';
                            end if;
                        end if;

                end case;
            end if;
        end if;
    end process;

    -- DDR, canal de escritura.
    process( clk )
    begin
        if( rising_edge( clk ) ) then
            if( reset = '0' ) then
                m_axi_w_awready <= '0';
                m_axi_w_wready  <= '0';
                m_axi_w_bvalid  <= '0';
                wr_slave_state  <= WR_S_IDLE;
                wr_word_idx     <= 0;

            else
                case wr_slave_state is
                    when WR_S_IDLE =>
                        m_axi_w_awready <= '0';
                        m_axi_w_wready  <= '0';
                        m_axi_w_bvalid  <= '0';
                        if( m_axi_w_awvalid = '1' ) then
                            m_axi_w_awready <= '1';
                            wr_word_idx     <= to_integer( unsigned( m_axi_w_awaddr ) ) / 8;
                            wr_slave_state  <= WR_S_DATA;
                        end if;

                    when WR_S_DATA =>
                        m_axi_w_awready <= '0';
                        m_axi_w_wready  <= '1';
                        if( m_axi_w_wvalid = '1' ) then
                            ddr_mem( wr_word_idx ) <= m_axi_w_wdata;
                            wr_word_idx             <= wr_word_idx + 1;
                            if( m_axi_w_wlast = '1' ) then
                                m_axi_w_wready <= '0';
                                wr_slave_state <= WR_S_RESP;
                            end if;
                        end if;

                    when WR_S_RESP =>
                        if( m_axi_w_bvalid = '0' ) then
                            m_axi_w_bvalid <= '1';
                            m_axi_w_bresp  <= "00";
                        elsif( m_axi_w_bready = '1' ) then
                            m_axi_w_bvalid <= '0';
                            wr_slave_state <= WR_S_IDLE;
                        end if;

                end case;
            end if;
        end if;
    end process;

    -- Main process.
    process

        procedure axi_write_accel( addr : in integer; data : in std_logic_vector( 31 downto 0 ) ) is
        begin
            axi_awaddr  <= std_logic_vector( to_unsigned( addr, 7 ) );
            axi_wdata   <= data;
            axi_awvalid <= '1';
            axi_wvalid  <= '1';
            wait until rising_edge( clk );
            axi_awvalid <= '0';
            axi_wvalid  <= '0';
            wait until axi_bvalid = '1';
            axi_bready <= '1';
            wait until rising_edge( clk );
            axi_bready <= '0';
        end procedure;

        procedure axi_write_dma( addr : in integer; data : in std_logic_vector( 31 downto 0 ) ) is
        begin
            s_axi_awaddr  <= std_logic_vector( to_unsigned( addr, 7 ) );
            s_axi_wdata   <= data;
            s_axi_awvalid <= '1';
            s_axi_wvalid  <= '1';
            wait until rising_edge( clk );
            s_axi_awvalid <= '0';
            s_axi_wvalid  <= '0';
            wait until s_axi_bvalid = '1';
            s_axi_bready <= '1';
            wait until rising_edge( clk );
            s_axi_bready <= '0';
        end procedure;

        -- Standard Config for tile 2x2. relu6_val por defecto = 127 ( se
        -- puede sobreescribir despues con un axi_write_accel(52,...) extra ).
        procedure cfg_accel(
            mode         : in std_logic_vector( 1 downto 0 );
            max_inner_v  : in integer;
            max_x_v      : in integer;
            max_y_v      : in integer;
            has_res      : in integer;
            pool_en_v    : in integer;
            pool_type_v  : in integer;
            shift_v      : in integer;
            gap_shift_v  : in integer
        ) is
        begin
            axi_write_accel(  4, std_logic_vector( resize( unsigned( mode ), 32 ) ) );
            axi_write_accel(  8, x"00000010" ); -- CIN = 16.
            axi_write_accel( 12, std_logic_vector( to_unsigned( max_inner_v, 32 ) ) );
            axi_write_accel( 16, x"00000000" ); -- MAX_CO = 0 ( override despues si hace falta ).
            axi_write_accel( 20, std_logic_vector( to_unsigned( max_x_v, 32 ) ) );
            axi_write_accel( 24, std_logic_vector( to_unsigned( max_y_v, 32 ) ) );
            axi_write_accel( 28, x"00000000" ); -- MAX_TILE_X = 0 ( override despues si hace falta ).
            axi_write_accel( 32, x"00000000" ); -- MAX_TILE_Y = 0.
            axi_write_accel( 36, std_logic_vector( to_unsigned( has_res, 32 ) ) );
            axi_write_accel( 40, std_logic_vector( to_unsigned( pool_en_v, 32 ) ) );
            axi_write_accel( 44, std_logic_vector( to_unsigned( pool_type_v, 32 ) ) );
            axi_write_accel( 48, std_logic_vector( to_unsigned( shift_v, 32 ) ) );
            axi_write_accel( 52, x"0000007F" ); -- RELU6_VAL = 127 ( override despues si hace falta ).
            axi_write_accel( 56, std_logic_vector( to_unsigned( gap_shift_v, 32 ) ) );
            axi_write_accel( 60, x"0000FFFF" ); -- REG_MULT ~= 1.0 ( no-op ), este tb no prueba el multiplicador.
            -- REG_RELU_EN ( 0x48 ) = 1 por defecto. Registro agregado 2026-09-08:
            -- antes relu_en estaba cableado a '1' en el POST de fsm_cnn_acc.vhd,
            -- sin registro para apagarlo. Al volverlo configurable su valor de
            -- reset es 0, asi que hay que pedir la ReLU6 explicitamente. El
            -- Caso I lo sobreescribe a 0 para probar una capa lineal.
            axi_write_accel( 72, x"00000001" );
        end procedure;

        -- Standard config of DMA for tile NxN, CON bias. DMA_COUT queda en
        -- 16 por defecto ( override despues si hace falta ).
        procedure cfg_dma(
            tile_n       : in integer;
            has_res      : in integer;
            weight_words : in integer;
            addr_w_v     : in integer;
            addr_in_v    : in integer;
            addr_out_v   : in integer;
            addr_res_v   : in integer;
            pool_en_v    : in integer;
            pool_type_v  : in integer;
            bias_words_v : in integer;
            addr_bias_v  : in integer
        ) is
        begin
            axi_write_dma(  8, x"00000010" ); -- DMA_CIN = 16.
            axi_write_dma( 12, x"00000010" ); -- DMA_COUT = 16.
            axi_write_dma( 16, std_logic_vector( to_unsigned( tile_n, 32 ) ) ); -- DMA_IMG_W.
            axi_write_dma( 20, std_logic_vector( to_unsigned( tile_n, 32 ) ) ); -- DMA_IMG_H.
            axi_write_dma( 24, std_logic_vector( to_unsigned( tile_n, 32 ) ) ); -- DMA_TILE_W.
            axi_write_dma( 28, std_logic_vector( to_unsigned( tile_n, 32 ) ) ); -- DMA_TILE_H.
            axi_write_dma( 32, x"00000001" ); -- DMA_NUM_TILE_X = 1 ( override despues si hace falta ).
            axi_write_dma( 36, x"00000001" ); -- DMA_NUM_TILE_Y = 1.
            axi_write_dma( 40, std_logic_vector( to_unsigned( has_res, 32 ) ) );
            axi_write_dma( 44, std_logic_vector( to_unsigned( weight_words, 32 ) ) );
            axi_write_dma( 48, std_logic_vector( to_unsigned( addr_w_v, 32 ) ) );
            axi_write_dma( 52, std_logic_vector( to_unsigned( addr_in_v, 32 ) ) );
            axi_write_dma( 56, std_logic_vector( to_unsigned( addr_out_v, 32 ) ) );
            axi_write_dma( 60, std_logic_vector( to_unsigned( addr_res_v, 32 ) ) );
            axi_write_dma( 68, std_logic_vector( to_unsigned( pool_en_v, 32 ) ) );
            axi_write_dma( 72, std_logic_vector( to_unsigned( pool_type_v, 32 ) ) );
            axi_write_dma( 76, std_logic_vector( to_unsigned( bias_words_v, 32 ) ) ); -- DMA_BIAS_WORDS ( 0x4C ).
            axi_write_dma( 80, std_logic_vector( to_unsigned( addr_bias_v, 32 ) ) );  -- DMA_ADDR_BIAS ( 0x50 ).
        end procedure;

        procedure run_layer_and_ack is
        begin
            axi_write_dma( 0, x"00000001" ); -- DMA_START.
            wait until dma_done = '1';
            wait for 1 ns;
        end procedure;

        procedure ack_dma_done is
        begin
            axi_write_dma( 64, x"00000001" ); -- write-1-to-clear DMA_DONE.
        end procedure;

        variable errors : integer := 0;

        procedure check( actual : in std_logic_vector( 63 downto 0 ); expected : in std_logic_vector( 63 downto 0 ); label_v : in string ) is
        begin
            if( actual /= expected ) then
                report "FALLO " & label_v & " -- esperado " & to_hstring( expected ) & " obtenido " & to_hstring( actual ) severity error;
                errors := errors + 1;
            else
                report "OK " & label_v & " = " & to_hstring( actual );
            end if;
        end procedure;

    begin

        reset <= '0';
        wait until rising_edge( clk );
        wait until rising_edge( clk );
        wait until rising_edge( clk );
        wait until rising_edge( clk );
        reset <= '1';
        wait until rising_edge( clk );
        wait until rising_edge( clk );

        report "=== INICIO tb_cnn_top_stride: red densa con stride real + regresion ===";

        -- CASO A: Conv3x3 + stride_en=1, tile 2x2, activacion varia por
        -- fila ( imgrow0=imgrow1=2, imgrow2=imgrow3=6 ). Ventana TF SAME
        -- ( padding="same", stride 2, entrada par ): la salida (y,x) lee
        -- filas 2y..2y+2 y columnas 2x..2x+2 de la imagen -- pad 0
        -- arriba/izquierda, 1 abajo/derecha. En el IFBuffer ( fila 0 = halo
        -- de arriba ) eso es row = 2*y_counter + sig_ky + 1 ( fix 2026-09-13,
        -- bug 1 de la primera corrida en placa: antes la ventana era la
        -- simetrica 2y-1..2y+1 y este caso daba 8/12/28/42 ).
        --   y=0 ( filas 0,1,2 ): 2+2+6 = 10.  y=1 ( filas 2,3 + pad ): 6+6 = 12.
        --   x=0 ( cols 0,1,2 ): 3 validas.   x=1 ( cols 2,3 + pad ): 2 validas.
        -- sum = 16 * suma_filas * cols, shift=4 (division exacta):
        -- (0,0)=10*3=30, (0,1)=10*2=20, (1,0)=12*3=36, (1,1)=12*2=24.
        report "--- CASO A: Conv3x3 + stride_en=1, activacion varia por fila ---";
        cfg_accel( "00", 144, 1, 1, 0, 0, 0, 4, 0 );
        axi_write_accel( 68, x"00000001" ); -- REG_STRIDE_EN = 1.
        cfg_dma( 4, 0, 144, 16#40000#, 16#41000#, 16#42000#, 16#43000#, 0, 0, 4, 16#43800# );
        axi_write_dma( 84, x"00000001" ); -- DMA_STRIDE_EN = 1.
        run_layer_and_ack;

        check( ddr_mem( 33792 ), x"1E1E1E1E1E1E1E1E", "CasoA pixel(y=0,x=0) = 30" );
        check( ddr_mem( 33794 ), x"1414141414141414", "CasoA pixel(y=0,x=1) = 20" );
        check( ddr_mem( 33796 ), x"2424242424242424", "CasoA pixel(y=1,x=0) = 36" );
        check( ddr_mem( 33798 ), x"1818181818181818", "CasoA pixel(y=1,x=1) = 24" );
        ack_dma_done;
        report "=== CASO A OK (ventana TF SAME: row = 2*y_counter + sig_ky + 1) ===";

        -- CASO B: DW3x3 + stride_en=1, mismo tile 2x2, activacion varia
        -- por COLUMNA ( imgcol0=imgcol1=3, imgcol2=imgcol3=9 ). Ventana TF
        -- SAME: col = 2*x_counter + sig_kx + 1. DW3x3 es de un solo canal
        -- por salida ( sin multiplicar por 16 ), asi que no hace falta shift.
        --   x=0 ( cols 0,1,2 ): 3+3+9 = 15.  x=1 ( cols 2,3 + pad ): 9+9 = 18.
        --   y=0 ( filas 0,1,2 ): 3 validas.  y=1 ( filas 2,3 + pad ): 2 validas.
        -- (0,0)=3*15=45, (0,1)=3*18=54, (1,0)=2*15=30, (1,1)=2*18=36.
        report "--- CASO B: DW3x3 + stride_en=1, activacion varia por columna ---";
        cfg_accel( "01", 9, 1, 1, 0, 0, 0, 0, 0 );
        axi_write_accel( 68, x"00000001" ); -- REG_STRIDE_EN = 1.
        cfg_dma( 4, 0, 9, 16#44000#, 16#45000#, 16#46000#, 16#47000#, 0, 0, 4, 16#47800# );
        axi_write_dma( 84, x"00000001" ); -- DMA_STRIDE_EN = 1.
        run_layer_and_ack;

        check( ddr_mem( 35840 ), x"2D2D2D2D2D2D2D2D", "CasoB pixel(y=0,x=0) = 45" );
        check( ddr_mem( 35842 ), x"3636363636363636", "CasoB pixel(y=0,x=1) = 54" );
        check( ddr_mem( 35844 ), x"1E1E1E1E1E1E1E1E", "CasoB pixel(y=1,x=0) = 30" );
        check( ddr_mem( 35846 ), x"2424242424242424", "CasoB pixel(y=1,x=1) = 36" );
        ack_dma_done;
        report "=== CASO B OK (col = 2*x_counter + sig_kx + 1, DW3x3 + stride) ===";

        -- CASO C: Conv3x3 + stride_en=1, DOS tiles horizontales. Activacion
        -- y pesos por defecto (=1) -- se verifica por CONTEO de taps
        -- validos, igual estilo que el resto de la suite. Imagen 8x4 ->
        -- salida 4x2, tile de salida 2x2. Con la ventana TF SAME la salida
        -- global X lee las columnas 2X..2X+2:
        --   tile0 x=0 ( cols 0,1,2 ) -> 3.
        --   tile0 x=1 ( cols 2,3,4 ) -> 3: la col 4 es de tile1 y llega por
        --     el halo DERECHO de tile0 ( dato REAL -- si el DMA la llenara
        --     con cero daria 2 ). Confirma que el DMA decodifico bien el
        --     limite entre tiles con stride.
        --   tile1 x=0 ( cols 4,5,6 ) -> 3.
        --   tile1 x=1 ( cols 6,7 + pad ) -> 2 ( borde derecho real ).
        --   filas validas: y=0 -> 3, y=1 -> 2 (igual en ambos tiles).
        -- sum = 16 * filas * cols, shift=4 (division exacta).
        report "--- CASO C: Conv3x3 + stride_en=1, 2 tiles horizontales (TILE_WAIT) ---";
        cfg_accel( "00", 144, 1, 1, 0, 0, 0, 4, 0 );
        axi_write_accel( 28, x"00000001" ); -- MAX_TILE_X = 1 ( 2 tiles ).
        axi_write_accel( 68, x"00000001" ); -- REG_STRIDE_EN = 1.
        cfg_dma( 4, 0, 144, 16#48000#, 16#49000#, 16#4A000#, 16#4B000#, 0, 0, 4, 16#4B800# );
        axi_write_dma( 16, x"00000008" ); -- DMA_IMG_W = 8 ( 2 tiles x 4 core, override ).
        axi_write_dma( 32, x"00000002" ); -- DMA_NUM_TILE_X = 2 ( override ).
        axi_write_dma( 84, x"00000001" ); -- DMA_STRIDE_EN = 1.
        run_layer_and_ack;

        report "--- tile0 (halo derecho = pixel real de tile1, no cero) ---";
        check( ddr_mem( 37888 ), x"0909090909090909", "CasoC tile0(y=0,x=0) = 9" );
        check( ddr_mem( 37890 ), x"0909090909090909", "CasoC tile0(y=0,x=1) = 9 (halo derecho real, no 6)" );
        check( ddr_mem( 37896 ), x"0606060606060606", "CasoC tile0(y=1,x=0) = 6" );
        check( ddr_mem( 37898 ), x"0606060606060606", "CasoC tile0(y=1,x=1) = 6 (real, no 4)" );

        report "--- tile1 (borde derecho real de la imagen -> pad = 0) ---";
        check( ddr_mem( 37892 ), x"0909090909090909", "CasoC tile1(y=0,x=0) = 9" );
        check( ddr_mem( 37894 ), x"0606060606060606", "CasoC tile1(y=0,x=1) = 6" );
        check( ddr_mem( 37900 ), x"0606060606060606", "CasoC tile1(y=1,x=0) = 6" );
        check( ddr_mem( 37902 ), x"0404040404040404", "CasoC tile1(y=1,x=1) = 4" );
        ack_dma_done;
        report "=== CASO C OK (DMA_TILE_W desacoplado de MAX_X/MAX_Y verificado con 2 tiles reales) ===";

        -- CASO D: cadena real Conv3x3(stride=2) -> DW3x3(stride=1), igual
        -- patron que conv1 -> siguiente capa en MobileNetV2 real. Capa 1
        -- igual al Caso C con UN tile ( la col 4 y la fila 4 son pad ):
        -- conteos 9,6,6,4. Capa 2 consume la salida REAL de Capa 1 como
        -- imagen 2x2 -- con solo 2x2 pixeles y kernel 3x3, CUALQUIER
        -- posicion de salida termina sumando los 4 pixeles reales (caso
        -- degenerado) -> las 4 salidas dan el mismo valor: 9+6+6+4=25,
        -- +bias3=28, shift=0.
        report "--- CASO D: cadena Conv3x3(stride=2) -> DW3x3(stride=1), datos reales propagados ---";

        report "--- Capa 1 (Conv3x3, stride_en=1) ---";
        cfg_accel( "00", 144, 1, 1, 0, 0, 0, 4, 0 );
        axi_write_accel( 68, x"00000001" ); -- REG_STRIDE_EN = 1.
        cfg_dma( 4, 0, 144, 16#4C000#, 16#4D000#, 16#4E000#, 16#4F000#, 0, 0, 4, 16#4F800# );
        axi_write_dma( 84, x"00000001" ); -- DMA_STRIDE_EN = 1.
        run_layer_and_ack;

        check( ddr_mem( 39936 ), x"0909090909090909", "CasoD capa1(y=0,x=0) = 9" );
        check( ddr_mem( 39938 ), x"0606060606060606", "CasoD capa1(y=0,x=1) = 6" );
        check( ddr_mem( 39940 ), x"0606060606060606", "CasoD capa1(y=1,x=0) = 6" );
        check( ddr_mem( 39942 ), x"0404040404040404", "CasoD capa1(y=1,x=1) = 4" );
        ack_dma_done;

        report "--- Capa 2 (DW3x3, stride_en=0 -- IN = OUT real de capa 1) ---";
        cfg_accel( "01", 9, 1, 1, 0, 0, 0, 0, 0 );
        axi_write_accel( 68, x"00000000" ); -- REG_STRIDE_EN = 0 ( explicito ).
        cfg_dma( 2, 0, 9, 16#50000#, 16#4E000#, 16#51000#, 16#52000#, 0, 0, 4, 16#52800# );
        axi_write_dma( 84, x"00000000" ); -- DMA_STRIDE_EN = 0 ( explicito ).
        run_layer_and_ack;

        check( ddr_mem( 41472 ), x"1C1C1C1C1C1C1C1C", "CasoD capa2(y=0,x=0) = 28" );
        check( ddr_mem( 41474 ), x"1C1C1C1C1C1C1C1C", "CasoD capa2(y=0,x=1) = 28" );
        check( ddr_mem( 41476 ), x"1C1C1C1C1C1C1C1C", "CasoD capa2(y=1,x=0) = 28" );
        check( ddr_mem( 41478 ), x"1C1C1C1C1C1C1C1C", "CasoD capa2(y=1,x=1) = 28" );
        ack_dma_done;
        report "=== CASO D OK (capa con stride alimentando directamente a capa sin stride, datos reales) ===";

        -- CASO E: regresion. Mismo caso y matematica EXACTA que el CASO K
        -- de tb_cnn_top_hardcore.vhd (PW1x1 + Residual): sum=16,
        -- acc=16+bias104=120, shift=0 -> 120. clamp_int8(120)=120 (dentro
        -- de rango). ReLU6: 120<127 -> 120. Residual sobreescrito a 10:
        -- add_unit: 120+10=130 > 127 -> satura A SU PROPIO limite a 127.
        -- stride_en=0 escrito EXPLICITO en los dos lados -- confirma que
        -- toda la plomeria nueva (registros + wiring + "or stride_en" en
        -- ddr_addr_gen.vhd/dma_fsm.vhd) no cambio el resultado ya
        -- verificado antes de este cambio.
        report "--- CASO E: regresion (PW1x1 + Residual, stride_en=0 explicito) ---";
        cfg_accel( "10", 16, 1, 1, 1, 0, 0, 0, 0 );
        axi_write_accel( 68, x"00000000" ); -- REG_STRIDE_EN = 0 ( explicito ).
        cfg_dma( 2, 1, 16, 16#53000#, 16#54000#, 16#55000#, 16#56000#, 0, 0, 4, 16#56800# );
        axi_write_dma( 84, x"00000000" ); -- DMA_STRIDE_EN = 0 ( explicito ).
        run_layer_and_ack;

        check( ddr_mem( 43520 ), x"7F7F7F7F7F7F7F7F", "CasoE pixel(0,0) (120+10=130 -> satura a 127)" );
        check( ddr_mem( 43522 ), x"7F7F7F7F7F7F7F7F", "CasoE pixel(0,1)" );
        check( ddr_mem( 43524 ), x"7F7F7F7F7F7F7F7F", "CasoE pixel(1,0)" );
        check( ddr_mem( 43526 ), x"7F7F7F7F7F7F7F7F", "CasoE pixel(1,1)" );
        ack_dma_done;
        report "=== CASO E OK (regresion confirmada: stride_en=0 no cambio nada del datapath ya verificado) ===";

        -- CASO F: verificacion del fix cin_groups floor->ceil, LADO DE
        -- LECTURA (ver cin_grouping_gap.md). Conv3x3, Cin=3 (igual que
        -- conv1 real), imagen/tile 2x2 (un solo tile -> los 4 bordes del
        -- tile son bordes reales de la imagen). Pesos y activacion por
        -- defecto (=1) -- se verifica por CONTEO de taps validos, igual
        -- estilo que CASO C: cada esquina de una imagen 2x2 excluye
        -- exactamente 1 fila y 1 columna del kernel 3x3 -> 2x2=4 taps
        -- validos por pixel. sum = Cin(3) * 4 = 12.
        -- SIN el fix, cin_groups=floor(3/16)=0 colapsaria term1/term2 a
        -- CERO siempre -- el acelerador leeria la MISMA direccion (0,0)
        -- para los 9 taps de CADA pixel, sin importar el zero-padding real
        -- de los bordes -> sum = 9*3 = 27 en vez de 12.
        report "--- CASO F: Conv3x3, Cin=3 (fix cin_groups, lado lectura) ---";
        cfg_accel( "00", 27, 1, 1, 0, 0, 0, 0, 0 );
        axi_write_accel(  8, x"00000003" ); -- REG_CIN = 3 (override, cfg_accel fija 16).
        axi_write_accel( 68, x"00000000" ); -- REG_STRIDE_EN = 0 (explicito).
        cfg_dma( 2, 0, 27, 16#58000#, 16#59000#, 16#5A000#, 16#5B000#, 0, 0, 4, 16#5B800# );
        axi_write_dma(  8, x"00000003" ); -- DMA_CIN = 3 (override).
        axi_write_dma( 84, x"00000000" ); -- DMA_STRIDE_EN = 0 (explicito).
        run_layer_and_ack;

        check( ddr_mem( 46080 ), x"0C0C0C0C0C0C0C0C", "CasoF pixel(0,0) = 12 (3 canales x 4 taps validos; bug daria 27)" );
        check( ddr_mem( 46082 ), x"0C0C0C0C0C0C0C0C", "CasoF pixel(0,1) = 12" );
        check( ddr_mem( 46084 ), x"0C0C0C0C0C0C0C0C", "CasoF pixel(1,0) = 12" );
        check( ddr_mem( 46086 ), x"0C0C0C0C0C0C0C0C", "CasoF pixel(1,1) = 12" );
        ack_dma_done;
        report "=== CASO F: ver arriba OK/FALLO (cin_groups = ceil(3/16) = 1) ===";

        -- CASO F2: MISMO Cin=3 que conv1 real, pero con 4 COLUMNAS reales
        -- (Caso F solo tenia 2, y con activacion uniforme no podia detectar
        -- un corrimiento entre columnas -- ver hallazgo del Caso G). Imagen
        -- 4x1 (una sola fila real), activacion varia por columna: col0=
        -- col1=3, col2=col3=9. Con kernel 3x3 y una sola fila real (halo
        -- de ceros arriba/abajo), cada pixel de salida ve exactamente las
        -- columnas {x-1,x,x+1} intersectadas con {0,1,2,3}. sum = Cin(3) *
        -- suma_de_esas_columnas: x=0->3+3=6->18. x=1->3+3+9=15->45.
        -- x=2->3+9+9=21->63. x=3->9+9=18->54.
        report "--- CASO F2: Conv3x3, Cin=3, 4 columnas (mismo hallazgo del Caso G, con conv1 real) ---";
        cfg_accel( "00", 27, 3, 0, 0, 0, 0, 0, 0 );
        axi_write_accel(  8, x"00000003" ); -- REG_CIN = 3 (override).
        axi_write_accel( 68, x"00000000" ); -- REG_STRIDE_EN = 0 (explicito).
        cfg_dma( 4, 0, 27, 16#58000#, 16#64000#, 16#65000#, 16#5B000#, 0, 0, 4, 16#64800# );
        axi_write_dma(  8, x"00000003" ); -- DMA_CIN = 3 (override).
        axi_write_dma( 20, x"00000001" ); -- DMA_IMG_H = 1 (override, tile_n=4 lo dejaria en 4).
        axi_write_dma( 28, x"00000001" ); -- DMA_TILE_H = 1 (override).
        axi_write_dma( 84, x"00000000" ); -- DMA_STRIDE_EN = 0 (explicito).
        run_layer_and_ack;

        check( ddr_mem( 51712 ), x"1212121212121212", "CasoF2 pixel(0) = 18 (Cin*[3+3])" );
        check( ddr_mem( 51714 ), x"2D2D2D2D2D2D2D2D", "CasoF2 pixel(1) = 45 (Cin*[3+3+9])" );
        check( ddr_mem( 51716 ), x"3F3F3F3F3F3F3F3F", "CasoF2 pixel(2) = 63 (Cin*[3+9+9])" );
        check( ddr_mem( 51718 ), x"3636363636363636", "CasoF2 pixel(3) = 54 (Cin*[9+9])" );
        ack_dma_done;
        report "=== CASO F2: ver arriba OK/FALLO (busca el mismo gap del Caso G pero en conv1 real) ===";

        -- CASO G: verificacion del fix cin_groups, LADO DE LECTURA, con DOS
        -- COLUMNAS (igual que irb3_exp/irb4_exp reales, Cin=24). PW1x1, 1
        -- fila x 2 columnas. Empaquetado denso en DDR: pixel0 ocupa los
        -- bytes 0-23 relativos a IN, pixel1 los bytes 24-47 -- SIN relleno
        -- a multiplo de 16 (row_stride_in = img_w*cin, cin crudo). pixel0:
        -- canales 0-15=1, canales 16-23=2 -> sum=16*1+8*2=32. pixel1:
        -- canales 0-15=3, canales 16-23=4 -> sum=16*3+8*4=80.
        report "--- CASO G: PW1x1, Cin=24, 2 columnas (fix cin_groups, lado lectura) ---";
        cfg_accel( "10", 24, 1, 0, 0, 0, 0, 0, 0 );
        axi_write_accel(  8, x"00000018" ); -- REG_CIN = 24 (override).
        axi_write_accel( 68, x"00000000" ); -- REG_STRIDE_EN = 0 (explicito).
        cfg_dma( 1, 0, 24, 16#5C000#, 16#5D000#, 16#5E000#, 16#5F000#, 0, 0, 4, 16#5F800# );
        axi_write_dma(  8, x"00000018" ); -- DMA_CIN = 24 (override).
        axi_write_dma( 16, x"00000002" ); -- DMA_IMG_W = 2 (override, tile_n=1 lo dejaria en 1).
        axi_write_dma( 24, x"00000002" ); -- DMA_TILE_W = 2 (override).
        axi_write_dma( 84, x"00000000" ); -- DMA_STRIDE_EN = 0 (explicito).
        run_layer_and_ack;

        check( ddr_mem( 48128 ), x"2020202020202020", "CasoG pixel(0,0) = 32 (16*1 + 8*2)" );
        check( ddr_mem( 48130 ), x"5050505050505050", "CasoG pixel(0,1) = 80 (16*3 + 8*4)" );
        ack_dma_done;
        report "=== CASO G: ver arriba OK/FALLO (cin_groups = ceil(24/16) = 2, 2 columnas) ===";

        -- CASO H: verificacion del fix cout_groups, LADO DE ESCRITURA (ver
        -- cin_grouping_gap.md Parte 4). PW1x1, Cin=16 (sin afectar), pero
        -- Cout=24 (igual que irb2_pw/irb3_pw reales) -- 2 filas x 1 columna,
        -- activacion distinta por fila (fila0=2, fila1=5) para detectar si
        -- el stride entre filas del OFBuffer (row_words_out, gobernado por
        -- cout_groups) esta mal. sum fila0 = 16*2 = 32. sum fila1 = 16*5 = 80.
        report "--- CASO H: PW1x1, Cin=16, Cout=24, 2 filas (fix cout_groups, lado escritura) ---";
        cfg_accel( "10", 16, 0, 1, 0, 0, 0, 0, 0 );
        axi_write_accel( 16, x"00000001" ); -- REG_MAX_CO = 1 (2 grupos de 16 -> Cout=24).
        axi_write_accel( 68, x"00000000" ); -- REG_STRIDE_EN = 0 (explicito).
        -- weight_words = 32, NO 16: con max_co=1 el acelerador lee addr_w
        -- 0-15 para co=0 Y 16-31 para co=1 (term7 = co_counter*cin), asi
        -- que el weight buffer necesita las DOS mitades cargadas o el
        -- segundo grupo de canales de salida lee BRAM sin inicializar.
        cfg_dma( 1, 0, 32, 16#60000#, 16#61000#, 16#62000#, 16#63000#, 0, 0, 8, 16#63800# );
        axi_write_dma( 12, x"00000018" ); -- DMA_COUT = 24 (override).
        axi_write_dma( 20, x"00000002" ); -- DMA_IMG_H = 2 (override).
        axi_write_dma( 28, x"00000002" ); -- DMA_TILE_H = 2 (override).
        axi_write_dma( 84, x"00000000" ); -- DMA_STRIDE_EN = 0 (explicito).
        run_layer_and_ack;

        report "--- fila0 (activacion=2): 16*2=32 ---";
        check( ddr_mem( 50176 ), x"2020202020202020", "CasoH fila0 canales 0-7 = 32" );
        check( ddr_mem( 50177 ), x"2020202020202020", "CasoH fila0 canales 8-15 = 32" );
        check( ddr_mem( 50178 ), x"2020202020202020", "CasoH fila0 canales 16-23 = 32" );
        report "--- fila1 (activacion=5): 16*5=80 (si cout_groups estuviera mal, leeria datos de fila0 aqui) ---";
        check( ddr_mem( 50180 ), x"5050505050505050", "CasoH fila1 canales 0-7 = 80" );
        check( ddr_mem( 50181 ), x"5050505050505050", "CasoH fila1 canales 8-15 = 80" );
        check( ddr_mem( 50182 ), x"5050505050505050", "CasoH fila1 canales 16-23 = 80" );
        ack_dma_done;
        report "=== CASO H: ver arriba OK/FALLO (cout_groups = ceil(24/16) = 2, 2 filas) ===";

        -- CASO H2: MISMO Cout=24 que irb2_pw/irb3_pw reales, pero con 2
        -- COLUMNAS en vez de 2 filas (Caso H solo probo filas). col0=
        -- activacion 2 (sum=16*2=32), col1=activacion 5 (sum=16*5=80),
        -- ambos grupos (co=0,1) por columna. Empaquetado denso esperado:
        -- col0 ocupa 24 bytes reales, col1 los siguientes 24.
        report "--- CASO H2: PW1x1, Cout=24, 2 columnas (busca el mismo gap del Caso G, lado escritura) ---";
        cfg_accel( "10", 16, 1, 0, 0, 0, 0, 0, 0 );
        axi_write_accel( 16, x"00000001" ); -- REG_MAX_CO = 1.
        axi_write_accel( 68, x"00000000" ); -- REG_STRIDE_EN = 0 (explicito).
        cfg_dma( 1, 0, 32, 16#60000#, 16#66000#, 16#68000#, 16#63000#, 0, 0, 8, 16#69000# );
        axi_write_dma( 12, x"00000018" ); -- DMA_COUT = 24 (override).
        axi_write_dma( 16, x"00000002" ); -- DMA_IMG_W = 2 (override).
        axi_write_dma( 24, x"00000002" ); -- DMA_TILE_W = 2 (override).
        axi_write_dma( 84, x"00000000" ); -- DMA_STRIDE_EN = 0 (explicito).
        run_layer_and_ack;

        check( ddr_mem( 53248 ), x"2020202020202020", "CasoH2 col0 canales 0-7 = 32" );
        check( ddr_mem( 53249 ), x"2020202020202020", "CasoH2 col0 canales 8-15 = 32" );
        check( ddr_mem( 53250 ), x"2020202020202020", "CasoH2 col0 canales 16-23 = 32" );
        check( ddr_mem( 53252 ), x"5050505050505050", "CasoH2 col1 canales 0-7 = 80" );
        check( ddr_mem( 53253 ), x"5050505050505050", "CasoH2 col1 canales 8-15 = 80" );
        check( ddr_mem( 53254 ), x"5050505050505050", "CasoH2 col1 canales 16-23 = 80" );
        ack_dma_done;
        report "=== CASO H2: ver arriba OK/FALLO (busca el gap del Caso G del lado de escritura, con columnas) ===";

        -- CASO I: relu_en = 0, capa LINEAL con salida negativa.
        -- Las 9 capas `_pw` del modelo real ( los linear bottlenecks de
        -- MobileNetV2 ) llevan relu_en=False en layer_quant_params.json: sus
        -- salidas negativas son parte del resultado, no ruido. Hasta el
        -- 2026-09-08 el hardware tenia relu_en cableado a '1' en el estado POST
        -- de fsm_cnn_acc.vhd y NO habia registro para apagarlo -- toda salida
        -- negativa se aplastaba a cero y no habia forma de expresarlo desde el
        -- PS. Peor: con el relu6_val=0 que trae el JSON para esas capas, la
        -- salida entera habria sido cero. Este caso ejercita REG_RELU_EN (0x48).
        -- PW1x1, Cin=16, pesos y activacion por defecto (=1) -> sum = 16.
        -- bias = -40 -> acc = -24. mult=0xFFFF, shift=0 -> ( -24*65535 + 32768 )
        -- >> 16 = -24 = 0xE8. Con relu_en=1 saldria 0x00; con relu_en=0, 0xE8.
        report "--- CASO I: relu_en=0, capa lineal con salida NEGATIVA ---";
        cfg_accel( "10", 16, 1, 1, 0, 0, 0, 0, 0 );
        axi_write_accel( 72, x"00000000" ); -- REG_RELU_EN = 0 ( capa lineal ).
        axi_write_accel( 68, x"00000000" ); -- REG_STRIDE_EN = 0 ( explicito ).
        cfg_dma( 2, 0, 16, 16#6C000#, 16#6D000#, 16#6E000#, 16#6F000#, 0, 0, 4, 16#6F800# );
        axi_write_dma( 84, x"00000000" ); -- DMA_STRIDE_EN = 0 ( explicito ).
        run_layer_and_ack;

        check( ddr_mem( 56320 ), x"E8E8E8E8E8E8E8E8", "CasoI pixel(0,0) = -24 (sum 16 + bias -40, sin ReLU)" );
        check( ddr_mem( 56322 ), x"E8E8E8E8E8E8E8E8", "CasoI pixel(0,1) = -24" );
        check( ddr_mem( 56324 ), x"E8E8E8E8E8E8E8E8", "CasoI pixel(1,0) = -24" );
        check( ddr_mem( 56326 ), x"E8E8E8E8E8E8E8E8", "CasoI pixel(1,1) = -24" );
        ack_dma_done;
        report "=== CASO I: ver arriba OK/FALLO (relu_en=0 preserva los negativos) ===";

        -- CASO J: Conv3x3 + stride_en=1, DOS tiles VERTICALES. Imagen 4x8,
        -- activacion por FILA: fila r = r+1 ( 1..8 ). Salida 2x4 ( tile de
        -- salida 2x2, MAX_TILE_Y=1 ). La salida Y lee las filas 2Y..2Y+2:
        --   Y=0: 1+2+3 = 6.
        --   Y=1: 3+4+5 = 12 -- la fila 4 es del tile 1 y llega por el halo de
        --        ABAJO del tile 0 ( con cero daria 7 ). conv1 real tiene 32
        --        tiles verticales: este halo se usa en todos menos el ultimo.
        --   Y=2: 5+6+7 = 18.
        --   Y=3: 7+8   = 15 ( borde de abajo real -> pad = 0 ).
        --   cols: X=0 -> 3, X=1 -> 2.  sum = 16*suma_filas*cols, shift=4.
        report "--- CASO J: Conv3x3 + stride_en=1, 2 tiles verticales (halo de abajo real) ---";
        cfg_accel( "00", 144, 1, 1, 0, 0, 0, 4, 0 );
        axi_write_accel( 32, x"00000001" ); -- MAX_TILE_Y = 1 ( 2 tiles ).
        axi_write_accel( 68, x"00000001" ); -- REG_STRIDE_EN = 1.
        cfg_dma( 4, 0, 144, 16#70000#, 16#71000#, 16#72000#, 16#73000#, 0, 0, 4, 16#73800# );
        axi_write_dma( 20, x"00000008" ); -- DMA_IMG_H = 8 ( override ).
        axi_write_dma( 36, x"00000002" ); -- DMA_NUM_TILE_Y = 2 ( override ).
        axi_write_dma( 84, x"00000001" ); -- DMA_STRIDE_EN = 1.
        run_layer_and_ack;

        check( ddr_mem( 58368 ), x"1212121212121212", "CasoJ pixel(Y=0,X=0) = 18" );
        check( ddr_mem( 58370 ), x"0C0C0C0C0C0C0C0C", "CasoJ pixel(Y=0,X=1) = 12" );
        check( ddr_mem( 58372 ), x"2424242424242424", "CasoJ pixel(Y=1,X=0) = 36 (halo de abajo real, no 21)" );
        check( ddr_mem( 58374 ), x"1818181818181818", "CasoJ pixel(Y=1,X=1) = 24 (halo de abajo real, no 14)" );
        check( ddr_mem( 58376 ), x"3636363636363636", "CasoJ pixel(Y=2,X=0) = 54" );
        check( ddr_mem( 58378 ), x"2424242424242424", "CasoJ pixel(Y=2,X=1) = 36" );
        check( ddr_mem( 58380 ), x"2D2D2D2D2D2D2D2D", "CasoJ pixel(Y=3,X=0) = 45" );
        check( ddr_mem( 58382 ), x"1E1E1E1E1E1E1E1E", "CasoJ pixel(Y=3,X=1) = 30" );
        ack_dma_done;
        report "=== CASO J: ver arriba OK/FALLO (halo de abajo entre tiles con stride) ===";

        -- CASO K: Conv3x3, Cin=3, imagen 2x2, canal c = c+1 ( 1,2,3 ) en los
        -- 4 pixeles, pesos = 1. Cada pixel tiene 4 taps validos -> 4*6 = 24.
        -- Detecta el bug 2 ( byte_sel sin registrar vs la latencia de 1 ciclo
        -- de la BRAM del IFBuffer ): el tap (2,2) de cada canal leia el canal
        -- ci+1 ( el ultimo recortado ) -> el pixel (0,0), el unico cuyo tap
        -- (2,2) cae dentro de la imagen, daba 24 - 6 + (2+3+3) = 26. Los
        -- otros 3 no lo ven ( su tap (2,2) es pad = 0 ).
        report "--- CASO K: Conv3x3 Cin=3, valor distinto por canal (byte_sel) ---";
        cfg_accel( "00", 27, 1, 1, 0, 0, 0, 0, 0 );
        axi_write_accel(  8, x"00000003" ); -- REG_CIN = 3 ( override ).
        axi_write_accel( 68, x"00000000" ); -- REG_STRIDE_EN = 0 ( explicito ).
        cfg_dma( 2, 0, 27, 16#74000#, 16#75000#, 16#76000#, 16#77000#, 0, 0, 4, 16#77800# );
        axi_write_dma(  8, x"00000003" ); -- DMA_CIN = 3 ( override ).
        axi_write_dma( 84, x"00000000" ); -- DMA_STRIDE_EN = 0 ( explicito ).
        run_layer_and_ack;

        check( ddr_mem( 60416 ), x"1818181818181818", "CasoK pixel(0,0) = 24 (con bug byte_sel daba 26)" );
        check( ddr_mem( 60418 ), x"1818181818181818", "CasoK pixel(0,1) = 24" );
        check( ddr_mem( 60420 ), x"1818181818181818", "CasoK pixel(1,0) = 24" );
        check( ddr_mem( 60422 ), x"1818181818181818", "CasoK pixel(1,1) = 24" );
        ack_dma_done;
        report "=== CASO K: ver arriba OK/FALLO (byte_sel alineado con el dato en Conv3x3) ===";

        -- CASO L: PW1x1, Cin=16, imagen 2x2, canal c = c ( 0..15 ), pesos = 1
        -- -> 0+1+..+15 = 120. Con el bug 2 cada canal leia el siguiente ( el
        -- ultimo recortado ) -> 1+..+15+15 = 135 -> satura a 127.
        report "--- CASO L: PW1x1 Cin=16, canal c = c (byte_sel) ---";
        cfg_accel( "10", 16, 1, 1, 0, 0, 0, 0, 0 );
        axi_write_accel( 68, x"00000000" ); -- REG_STRIDE_EN = 0 ( explicito ).
        cfg_dma( 2, 0, 16, 16#78000#, 16#79000#, 16#7A000#, 16#7B000#, 0, 0, 4, 16#7B800# );
        axi_write_dma( 84, x"00000000" ); -- DMA_STRIDE_EN = 0 ( explicito ).
        run_layer_and_ack;

        check( ddr_mem( 62464 ), x"7878787878787878", "CasoL pixel(0,0) = 120 (con bug byte_sel saturaba a 127)" );
        check( ddr_mem( 62466 ), x"7878787878787878", "CasoL pixel(0,1) = 120" );
        check( ddr_mem( 62468 ), x"7878787878787878", "CasoL pixel(1,0) = 120" );
        check( ddr_mem( 62470 ), x"7878787878787878", "CasoL pixel(1,1) = 120" );
        ack_dma_done;
        report "=== CASO L: ver arriba OK/FALLO (byte_sel alineado con el dato en PW1x1) ===";

        -- CASO M: PW1x1 + Residual, Cin=16, Cout=32 ( 2 grupos ), imagen 2x2.
        -- sum = 16 ( pesos y activacion = 1 ), bias 0 -> 16 antes del
        -- residual. Residual distinto por pixel p y grupo g: 10p + 40g + 5.
        -- Salida = 16 + residual. Detecta el bug 4 ( residual_buf leido con
        -- ag_addr_out en vivo, que en POST ya avanzo a la siguiente
        -- iteracion ): el grupo 0 recibia el residual del grupo 1 del mismo
        -- pixel y el grupo 1 el del grupo 0 del pixel siguiente ( el mismo
        -- patron que se midio en la placa ). weight_words = 32 y bias de 2
        -- grupos, igual que el Caso H ( max_co = 1 ).
        report "--- CASO M: PW1x1 + Residual, Cout=32, residual distinto por pixel y grupo ---";
        cfg_accel( "10", 16, 1, 1, 1, 0, 0, 0, 0 );
        axi_write_accel( 16, x"00000001" ); -- REG_MAX_CO = 1 ( Cout=32 ).
        axi_write_accel( 68, x"00000000" ); -- REG_STRIDE_EN = 0 ( explicito ).
        cfg_dma( 2, 1, 32, 16#7C000#, 16#7D000#, 16#7E000#, 16#7F000#, 0, 0, 8, 16#7F800# );
        axi_write_dma( 12, x"00000020" ); -- DMA_COUT = 32 ( override ).
        axi_write_dma( 84, x"00000000" ); -- DMA_STRIDE_EN = 0 ( explicito ).
        run_layer_and_ack;

        check( ddr_mem( 64512 ), x"1515151515151515", "CasoM pixel0 grupo0 canales 0-7 = 16+5 = 21" );
        check( ddr_mem( 64513 ), x"1515151515151515", "CasoM pixel0 grupo0 canales 8-15 = 16+5 = 21" );
        check( ddr_mem( 64514 ), x"3D3D3D3D3D3D3D3D", "CasoM pixel0 grupo1 canales 16-23 = 16+45 = 61" );
        check( ddr_mem( 64515 ), x"3D3D3D3D3D3D3D3D", "CasoM pixel0 grupo1 canales 24-31 = 16+45 = 61" );
        check( ddr_mem( 64516 ), x"1F1F1F1F1F1F1F1F", "CasoM pixel1 grupo0 canales 0-7 = 16+15 = 31" );
        check( ddr_mem( 64517 ), x"1F1F1F1F1F1F1F1F", "CasoM pixel1 grupo0 canales 8-15 = 16+15 = 31" );
        check( ddr_mem( 64518 ), x"4747474747474747", "CasoM pixel1 grupo1 canales 16-23 = 16+55 = 71" );
        check( ddr_mem( 64519 ), x"4747474747474747", "CasoM pixel1 grupo1 canales 24-31 = 16+55 = 71" );
        check( ddr_mem( 64520 ), x"2929292929292929", "CasoM pixel2 grupo0 canales 0-7 = 16+25 = 41" );
        check( ddr_mem( 64521 ), x"2929292929292929", "CasoM pixel2 grupo0 canales 8-15 = 16+25 = 41" );
        check( ddr_mem( 64522 ), x"5151515151515151", "CasoM pixel2 grupo1 canales 16-23 = 16+65 = 81" );
        check( ddr_mem( 64523 ), x"5151515151515151", "CasoM pixel2 grupo1 canales 24-31 = 16+65 = 81" );
        check( ddr_mem( 64524 ), x"3333333333333333", "CasoM pixel3 grupo0 canales 0-7 = 16+35 = 51" );
        check( ddr_mem( 64525 ), x"3333333333333333", "CasoM pixel3 grupo0 canales 8-15 = 16+35 = 51" );
        check( ddr_mem( 64526 ), x"5B5B5B5B5B5B5B5B", "CasoM pixel3 grupo1 canales 16-23 = 16+75 = 91" );
        check( ddr_mem( 64527 ), x"5B5B5B5B5B5B5B5B", "CasoM pixel3 grupo1 canales 24-31 = 16+75 = 91" );
        ack_dma_done;
        report "=== CASO M: ver arriba OK/FALLO (residual alineado con la iteracion que se cierra) ===";

        report "=== RESUMEN: " & integer'image( errors ) & " fallo(s) ===" severity note;
        if( errors = 0 ) then
            report "=== TODOS LOS CASOS PASARON ===" severity note;
        else
            report "=== HAY CASOS CON FALLOS, revisar arriba ===" severity error;
        end if;

        wait;
    end process;

end Behavioral;
