angel-obando-17/CNN-accelerator-on-SoC/accelerator/cnn_accelerator/rtl/fsm_cnn_acc.vhd

library ieee;
use ieee.std_logic_1164.all;

entity fsm_cnn_accelerator is
    port(
        clk, reset       : in std_logic;
        -- Input signals.
        mac_valid        : in std_logic;
        reg_start        : in std_logic;
        reg_mode         : in std_logic_vector( 1 downto 0 );
        pixel_done       : in std_logic;
        reg_pool_en      : in std_logic;
        reg_pool_type    : in std_logic;
        post_done        : in std_logic;
        layer_done       : in std_logic;
        tile_boundary    : in std_logic;
        tile_ready       : in std_logic;
        reg_has_residual : in std_logic;
        reg_relu_en      : in std_logic;
        gap_done         : in std_logic;
        
        -- Output signals.
        acc_clear       : out std_logic;
        addr_en         : out std_logic;
        mac_en          : out std_logic;
        mux_sel         : out std_logic;
        acc_bank_enable : out std_logic;
        mac_clear       : out std_logic;
        relu_en         : out std_logic;
        quant_en        : out std_logic;
        pool_act        : out std_logic; 
        pool_type_sel   : out std_logic;
        add_en          : out std_logic; 
        addr_res        : out std_logic;
        tile_req        : out std_logic; 
        reg_done        : out std_logic;
        irq_out         : out std_logic
    );
end fsm_cnn_accelerator;

architecture Behavioral of fsm_cnn_accelerator is
    type state_type is ( IDLE, COMPUTE, DRAIN, LATCH, POST, TILE_WAIT, FLUSH, DONE );

    -- Aux signals.
    signal current_state, next_state : state_type;
begin

    process( clk, reset )
    begin
        if( reset = '1' ) then
            -- Reset to the initial state.
            current_state <= IDLE;
        elsif( rising_edge( clk ) ) then
            -- Set current_state to next_state.
            current_state <= next_state;
        end if;
    end process;
    
    process( 
        current_state,
        mac_valid, 
        reg_start, 
        reg_mode, 
        pixel_done,
        reg_pool_en, 
        reg_pool_type, 
        post_done, 
        layer_done,
        tile_boundary,
        tile_ready,
        reg_has_residual,
        reg_relu_en,
        gap_done 
    )
    begin
        -- Default values for signals.
        acc_clear       <= '0';
        addr_en         <= '0';
        mac_en          <= '0';
        mux_sel         <= '0';
        acc_bank_enable <= '0';
        mac_clear       <= '0';
        relu_en         <= '0';
        quant_en        <= '0';
        pool_act        <= '0';
        pool_type_sel   <= '0';
        add_en          <= '0';
        addr_res        <= '0';
        tile_req        <= '0';
        reg_done        <= '0';
        irq_out         <= '0';
        next_state      <= current_state;
        
        case current_state is
            when IDLE =>
                acc_clear  <= '1';
                mac_clear  <= '1';
                if( reg_start = '1' ) then
                    mac_clear  <= '1';
                    next_state <= COMPUTE;
                else
                    next_state <= IDLE;
                end if;

            when COMPUTE =>
                addr_en <= '1';
                mac_en  <= mac_valid;
                if( reg_mode = "00" or reg_mode = "01" ) then
                    -- Set mux_sel = '0' to conv 3x3 and DW 3x3.
                    mux_sel <= '0';
                elsif( reg_mode = "10" ) then
                    -- Set mux_sel = '1' to PW 1x1.
                    mux_sel <= '1';
                end if;
                
                if( pixel_done = '1' ) then
                    next_state <= DRAIN;
                else
                    next_state <= COMPUTE;
                end if;

            when DRAIN =>
                addr_en    <= '1';
                mac_en     <= mac_valid;
                next_state <= LATCH;

            when LATCH =>
                acc_bank_enable <= '1';
                mac_clear       <= '1';
                addr_en         <= '1';
                next_state <= POST;

            when POST =>
                relu_en  <= reg_relu_en;
                quant_en <= '1';
                addr_en  <= '1';
                mac_en   <= mac_valid;
                add_en   <= reg_has_residual;
                addr_res <= reg_has_residual;
                if( reg_pool_en = '1' ) then
                    -- Set pool_act = '1' and the mux who choose between maxpool and gap
                    -- is controlled by reg_pool_type.
                    pool_act <= '1';
                    pool_type_sel <= reg_pool_type;
                else
                    pool_act <= '0';
                    pool_type_sel <= '0';
                end if;
                
                if( post_done = '1' ) then
                    if( layer_done = '1' ) then
                        if( reg_pool_en = '1' and reg_pool_type = '1' ) then
                            next_state <= FLUSH;
                        else
                            next_state <= DONE;
                        end if;
                    elsif( tile_boundary = '1' ) then
                        next_state <= TILE_WAIT;
                    else
                        next_state <= COMPUTE;
                    end if;
                else
                    next_state <= POST;
                end if;

            when TILE_WAIT =>
                tile_req <= '1';
                addr_en  <= '1';
                if( tile_ready = '1' ) then
                    next_state <= COMPUTE;
                else
                    next_state <= TILE_WAIT;
                end if; 

            when FLUSH =>
                pool_type_sel <= '1';
                if( gap_done = '1' ) then
                    next_state <= DONE;
                else
                    next_state <= FLUSH;
                end if;

            when DONE =>
                reg_done <= '1';
                irq_out  <= '1';
                if( reg_start = '1' ) then
                    next_state <= IDLE;
                else
                    next_state <= DONE;
                end if;

        end case;

    end process;
end Behavioral;
