angel-obando-17/CNN-accelerator-on-SoC/accelerator/cnn_accelerator/rtl/weight_buffer.vhd

library ieee;
use ieee.std_logic_1164.all;
use ieee.numeric_std.all;

entity weight_buf is
    generic(
        DATA_WIDTH : integer := 128; -- Bits por palabra.
        ADDR_WIDTH : integer := 8    -- Bits de dirección ( 256 posiciones ).
    );
    port(
        clk      : in  std_logic;
        r_enable : in  std_logic;
        w_enable : in  std_logic;
        wr_addr  : in  std_logic_vector( ADDR_WIDTH - 1 downto 0 );
        rd_addr  : in  std_logic_vector( ADDR_WIDTH - 1 downto 0 );
        data_in  : in  std_logic_vector( DATA_WIDTH - 1 downto 0 );
        data_out : out std_logic_vector( DATA_WIDTH - 1 downto 0 )
    );
end weight_buf;

architecture Behavioral of weight_buf is
    type buf_bram is array( 0 to ( 2 ** ADDR_WIDTH ) - 1 )of std_logic_vector( DATA_WIDTH - 1 downto 0 );
    signal buf_weight : buf_bram;
begin

    process( clk )
    begin
        if( rising_edge( clk ) ) then
            if( w_enable = '1' ) then
                buf_weight( to_integer( unsigned( wr_addr ) ) ) <= data_in;
            end if;
            
            if( r_enable = '1' ) then
                data_out <= buf_weight( to_integer( unsigned( rd_addr ) ) );
            end if;
        end if;
    end process;

end Behavioral;
