angel-obando-17/CNN-accelerator-on-SoC/accelerator/cnn_accelerator/rtl/mac.vhd

library ieee;
use ieee.std_logic_1164.all;
use ieee.numeric_std.all;

entity mac is
    port(
       clk, reset : in  std_logic;
       enable     : in  std_logic;
       clear      : in  std_logic;
       weight     : in  signed( 7 downto 0 );
       act        : in  signed( 7 downto 0 );
       acc_out    : out signed( 31 downto 0 )
    );
end mac;

architecture Behavioral of mac is
    signal accumulator : signed( 31 downto 0 ) := ( others => '0' );
    signal product     : signed( 15 downto 0 ) := ( others => '0' );
begin
    
    product <= weight * act;
    
    process( clk )
    begin
        if( rising_edge( clk ) ) then
            if( reset = '1' or clear = '1' ) then
                accumulator <= ( others => '0' );
            elsif( enable = '1' ) then
                accumulator <= accumulator + resize( product, 32 );
            end if;
        end if;
    end process;

    acc_out <= accumulator;

end Behavioral;
