angel-obando-17/CNN-accelerator-on-SoC/(commit log)

2026-01-22 NEW: Bitacora para llevar registro del avance, hasta el momento se tiene la macro-arquitectura del sistema.
2026-01-30 UPDATE: Se hizo ajustes en la macro-arquitectura, se explica la funcion que cumlira cada uno de los elementos del SoC y como estaran interconectados.
2026-02-18 UPDATE: Se definio el pipeline.
2026-02-18 UPDATE: Correccion de diagramas.
2026-03-02 UPDATE: Correccion de unidades
2026-03-02 UPDATE: Correccion de diagrama.
2026-03-03 NEW: Entrenamiento de CNN y analisis de resultados.
    [tabla_resumen.csv]
2026-03-08 UPDATE: resultados de CNN actualizados, se agrego las imagenes segmentadas y mascaras obtenidas de forma manual.
2026-03-08 UPDATE: Modelo U-net entrenado para segmentar las imagenes del dataset de manera mas precisa, a partir de las mascaras hechas de forma manual.
2026-03-08 UPDATE: Actualizacion de resultados obtenidos en analisis.md
2026-03-08 UPDATE: Resultados segundo entrenamiento de la CNN.
    [tabla_resumen.csv]
2026-03-08 UPDATE: Correccion de resultados y resultados de entrenamiento 2 en analisis.md.
    [tabla_resumen.csv]
2026-03-09 UPDATE: Resultados de modelos para comparacion.
2026-03-10 UPDATE: Archivo de comparacion de distintas boards.
2026-03-14 UPDATE: Actualizacion Bitacora y Analisis despues de entrenamiento usando HSV.
2026-03-14 UPDATE: Ajustes Bitacora finales y correccion tabla de analisis.md
2026-03-17 UPDATE: Diagramas mas desarrollados y ademas implementacion de fsm para el cnn_accelerator.
2026-04-23 NEW: Corrections of fsm code and implementation of the MAC_Array block.
    [cnn_pkg.vhd, fsm_cnn_acc.vhd, mac.vhd, mac_array.vhd]
2026-04-30 UPDATE: Se implemento el bloque mac_array y accumulator_bank, ademas de diseñar e implementar la fsm del bloque address generator.
2026-05-03 UPDATE: Bloque Address Generator completado, ademas de ajustes en la fsm del bloque, pruebas realizadas con archivo testbench.
2026-06-04 UPDATE: Weight Buffer Implementado, creacion de archivo architecture.md y correccion de detalles de la arquitectura.
2026-06-04 UPDATE: Bloque Cuantizador y de ReLU6 activation function implementado, ademas de agregar detalles sobre dicho bloque en architecture.md
2026-06-04 UPDATE: Correccion de fsm principal, ademas de implementar resiual buffer, output feature buffer y add unit.
2026-06-05 UPDATE: Pool Unit implementada, con MaxPool Unit y GAP Unit, ademas de cambios realizados en ls fsm principal.
2026-06-08 UPDATE: Correccion de diagramas de la arquitectura y de la asm principal y la asm del address generator.
2026-06-09 FIX: Timing bugs corregidos en datapath V1.0, testbench y documentacion actualizados.
    [cnn_accelerator.vhd, fsm_addr_generator.vhd, fsm_cnn_acc.vhd, mac.vhd, tb_cnn_accelerator.vhd]
2026-06-10 UPDATE: Pruebas con Conv3x3 realaizadas con archivo testbench, ademas de corregir un bug en la fsm del address_generator.
    [fsm_addr_generator.vhd, tb_conv3x3.vhd]
2026-06-21 FIX: Bugs de timing en pool_unit corregidos, testbenches de pool y residual add verificados.
    [cnn_accelerator.vhd, fsm_cnn_acc.vhd, max_pool.vhd, tb_add.vhd, tb_dw3x3.vhd, tb_pool.vhd]
2026-06-24 UPDATE: Pruebas con archivos testbench que simulan multiples capas para validar el funcionamiento del acelerador.
2026-07-01 UPDATE: AXI-Slave para comunicacion entre PS y PL implementado.
2026-07-01 UPDATE: Se agregaron estados a las fsm's para poder sincronizar con la futura implementacion del DMA, se probo que todo funcionara con nuevo archivo testbench.
2026-07-02 UPDATE: Banco de registros AXI-Lite del DMA implementado y documentacion de diseno del DMA agregada.
2026-07-02 FIX: IFBuffer redimensionado con padding real para halo de Conv3x3/DW3x3, 8 testbenches actualizados y verificados.
    [addr_generator.vhd, cnn_accelerator.vhd, inputf_buf.vhd, inputf_buf_a.vhd, inputf_buf_b.vhd, reg_bank.vhd, tb_add.vhd, tb_cnn_accelerator.vhd]
2026-07-06 UPDATE: README and new documentation for DMA.
2026-07-08 UPDATE: AXI4 Read/Write Master del DMA implementados.
2026-07-09 UPDATE: DMA Engine Finalizado y listo para pruebas.
2026-07-09 UPDATE: reg_bank probado y funcionando correctamente con testbench.
    [tb_reg_bank.vhd]
2026-07-11 UPDATE: DMA Engine funcionando y probado con archivo testbench.
2026-07-13 FIX: Correccion de archivos testbench, para que sean coherente con las correcciones hechas al acelerador.
    [tb_add.vhd, tb_cnn_accelerator.vhd, tb_multilayer.vhd, tb_multilayer2.vhd, tb_multilayer3.vhd, tb_pool.vhd]
2026-07-13 UPDATE: F_max definida para el acelerador despues de STA.
2026-07-14 Block Diagram y archivo .xsa ya exportados listo para trabajar en Vitis ( PL Completado ).
2026-07-18 UPDATE; Inicio de pruebas para validar QAT, actualizacion de estructura de carpetas para CNN
    [tabla_resumen.csv]
2026-07-18 UPDATE: Modelos creados y listos para entrenar.
2026-07-18 UPDATE: Refactorizacion de los codigos viejos completado, listo para proceder con etapa QAT.
2026-07-19 UPDATE: Correcion en el trackeo de algunos archivos.
2026-07-19 UPDATE: QAT hardware-aware (Fase 2) implementado y evaluado -- software insuficiente, se pasa a modificar el acelerador.
2026-08-05 UPDATE: Verificación en simulacion despues de implementar bias support en hardware.
2026-08-05 UPDATE: Prueba PTQ v2, reflejada bajo el hardware real ya con correccion en quant_relu.vhd
2026-08-05 UPDATE: Soporte de bias + multiplicador de re-cuantizacion en el acelerador -- timing 70MHz cerrado, accuracy real 93.70%.
2026-08-05 UPDATE: Documentacion de registros para el dma actualizada.
2026-08-06 UPDATE: Registros AXI CNN/DMA listos.
2026-08-06 UPDATE: struct layer_config_t lista para ser usada en funciones de los drivers.
2026-08-06 UPDATE: Firmas de las funciones publicas de cada driver listas.
2026-08-07 UPDATE: Drivers del acelerador y del dma listos.
2026-09-03 UPDATE: Soporte de stride real implementado y verificado en RTL.
2026-09-04 UPDATE: Fix de timing en el acelerador.
    [addr_generator.vhd, cnn_driver.c, ddr_addr_gen.vhd, dma_driver.c, dma_engine.vhd, dma_fsm.vhd, reg_bank.vhd]
2026-09-08 UPDATE: Corrección de empaquetado en DDR a multiplo de 16 B/pixel.
2026-09-08 UPDATE: Correción para cumplir con los 4KB maximos permitidos por el protocolo AXI.
2026-09-08 UPDATE: 5to y ultimo sitio del bug floor/ceil originado por GAP_FLUSH.
    [dma_fsm.vhd, tb_cnn_top_hardcore.vhd]
2026-09-09 UPDATE: REG_RELU_EN, la ReLU6 ahora se puede apagar por capa.
2026-09-09 UPDATE: generate_layer_table.py script completo y listo para usarse en la generacion de layer_table.c
2026-09-09 UPDATE: generate_layer_table resuelto conflicto de rutas y layer_table.h declara arreglo.
    [layer_table.h]
2026-09-11 UPDATE: intercore.h ( Buzon entre cores + SGIs ) y odc de memoria del sistema.
2026-09-11 UPDATE: intercore.h ( Buzon entre cores + SGIs ) y doc de memoria del sistema.
2026-09-13 UPDATE: Core1 Segmentacion HSV completa, resultados iguales a los obtenidos con Python en el entrenamiento.
2026-09-14 UPDATE: main.c del Core0 listo, firmware V1.0 listo para ponerse en prueba con la placa.
2026-09-14 FIX: Correcion de 4 bugs en el hardware que hicieron fallar las pruebas en la placa.
    [addr_generator.vhd, cnn_accelerator.vhd, tb_cnn_top_stride.vhd]
2026-09-14 UPDATE: Core0 - lectura de imagenes, pesos, bias y dense desde la SD.
2026-09-21 UPDATE: Boot de la placa desde la SD, core0 despierta al core1.
2026-10-15 UPDATE: Core0 - inferencia puramente software para comparacion de tiempos con el acelerador.
2026-10-19 UPDATE: Core0 - medicion de tiempos HW vs SW con XTime (HW 99.2 ms, SW 13.56 s, 137 veces mas rapido), GAP verificado identico.
2026-10-22 UPDATE: Core0 - driver de la LCD 20x4 e integracion en main.c.
2026-10-24 FIX: LCD - el sistema ya no se bloquea sin pantalla.
